hack-a-tack/FPGA_Logic_Analyzer/rev2/pcb/images/rev2_3d_render.png

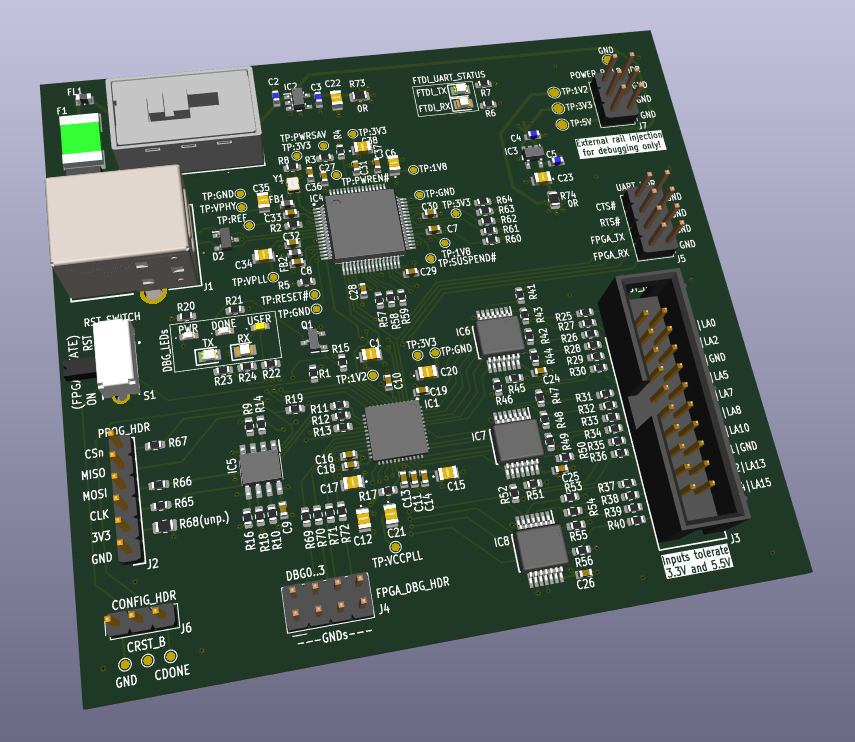
rev2/pcb/images/rev2_3d_render.png
