hack-a-tack/FPGA_Logic_Analyzer/rev2/pcb/kicad/report.txt

Warning: Width correction constrained.  The width correction value must be in the range of [-0.099999 mm; -0.000002 mm] for the current design rules.
