hack-a-tack/FPGA_Logic_Analyzer/rev2/fpga/iCEcube2_rev2_logic_analyzer/iCEcube2_rev2_logic_analyzer_Implmnt/synlog/report/iCEcube2_rev2_logic_analyzer_fpga_mapper_notes.txt

@N: MF248 |Running in 64-bit mode.
@N: MF666 |Clock conversion enabled. (Command "set_option -fix_gated_and_generated_clocks 1" in the project file.)
@N: MT204 |Auto Constrain mode is disabled because clocks are defined in the SDC file
@N: MO225 :"c:\users\jakob\documents\ee-projects\fpga_logic_analyzer\rev2\fpga\rtl\uart_rx.vhd":91:2:91:3|There are no possible illegal states for state machine r_state[0:3] (in view: work.uart_rx(rtl)); safe FSM implementation is not required.
@N: MO225 :"c:\users\jakob\documents\ee-projects\fpga_logic_analyzer\rev2\fpga\rtl\analyzer_fsm.vhd":133:2:133:3|There are no possible illegal states for state machine r_state[0:3] (in view: work.analyzer_fsm(rtl)); safe FSM implementation is not required.
@N: MO231 :"c:\users\jakob\documents\ee-projects\fpga_logic_analyzer\rev2\fpga\rtl\capture_engine.vhd":168:2:168:3|Found counter in view:work.capture_engine(rtl) instance r_post_remaining[13:0] 
@N: MF179 :"c:\users\jakob\documents\ee-projects\fpga_logic_analyzer\rev2\fpga\rtl\capture_engine.vhd":461:10:461:82|Found 16 by 16 bit equality operator ('==') fsm_proc\.un34_i_samp_tick (in view: work.capture_engine(rtl))
@N: MF179 :"c:\users\jakob\documents\ee-projects\fpga_logic_analyzer\rev2\fpga\rtl\capture_engine.vhd":269:5:269:29|Found 14 by 14 bit equality operator ('==') fsm_proc\.un5_r_write_ptr (in view: work.capture_engine(rtl))
@N: BN362 :|Removing sequential instance r_bank_0_0_0_sr_rst_0 (in view: VhdlGenLib.top_RAMN_R_W_6144_8_TFFF_block_ram_ns_sbt(netlist)) because it does not drive other instances.
@N: BN362 :|Removing sequential instance r_bank_1_0_0_sr_rst_0 (in view: VhdlGenLib.top_RAMN_R_W_6144_8_TFFF_block_ram_ns_sbt_0(netlist)) because it does not drive other instances.
@N: MF179 :"c:\users\jakob\documents\ee-projects\fpga_logic_analyzer\rev2\fpga\rtl\send_engine.vhd":221:61:221:87|Found 14 by 14 bit equality operator ('==') fsm_proc\.un5_r_last_addr (in view: work.send_engine(rtl))
@N: BN362 :"c:\users\jakob\documents\ee-projects\fpga_logic_analyzer\rev2\fpga\rtl\send_engine.vhd":164:2:164:3|Removing sequential instance r_sample_count[10] (in view: work.send_engine(rtl)) because it does not drive other instances.
@N: BN362 :"c:\users\jakob\documents\ee-projects\fpga_logic_analyzer\rev2\fpga\rtl\resp_gen.vhd":135:2:135:3|Removing sequential instance seq_proc\.r_queue_3[18] (in view: work.resp_gen(rtl)) because it does not drive other instances.
@N: BN362 :"c:\users\jakob\documents\ee-projects\fpga_logic_analyzer\rev2\fpga\rtl\resp_gen.vhd":135:2:135:3|Removing sequential instance seq_proc\.r_queue_2[18] (in view: work.resp_gen(rtl)) because it does not drive other instances.
@N: BN362 :"c:\users\jakob\documents\ee-projects\fpga_logic_analyzer\rev2\fpga\rtl\resp_gen.vhd":135:2:135:3|Removing sequential instance seq_proc\.r_queue_1[18] (in view: work.resp_gen(rtl)) because it does not drive other instances.
@N: BN362 :"c:\users\jakob\documents\ee-projects\fpga_logic_analyzer\rev2\fpga\rtl\resp_gen.vhd":135:2:135:3|Removing sequential instance seq_proc\.r_queue_0[18] (in view: work.resp_gen(rtl)) because it does not drive other instances.
@N: MO225 :"c:\users\jakob\documents\ee-projects\fpga_logic_analyzer\rev2\fpga\rtl\uart_tx.vhd":107:2:107:3|There are no possible illegal states for state machine r_state[0:3] (in view: work.uart_tx(rtl)); safe FSM implementation is not required.
@N: MF794 |RAM r_bank_0[7:0] required 2 registers during mapping 
@N: MF794 |RAM r_bank_1[7:0] required 2 registers during mapping 
@N: BN362 :|Removing sequential instance r_bank_0_0_0_sr_rst (in view: VhdlGenLib.top_RAMN_R_W_6144_8_TFFF_block_ram_ns_sbt(netlist)) because it does not drive other instances.
@N: BN362 :|Removing sequential instance r_bank_0_0_0_sr_en (in view: VhdlGenLib.top_RAMN_R_W_6144_8_TFFF_block_ram_ns_sbt(netlist)) because it does not drive other instances.
@N: BN362 :|Removing sequential instance r_bank_1_0_0_sr_rst (in view: VhdlGenLib.top_RAMN_R_W_6144_8_TFFF_block_ram_ns_sbt_0(netlist)) because it does not drive other instances.
@N: BN362 :|Removing sequential instance r_bank_1_0_0_sr_en (in view: VhdlGenLib.top_RAMN_R_W_6144_8_TFFF_block_ram_ns_sbt_0(netlist)) because it does not drive other instances.
@N: BN362 :"c:\users\jakob\documents\ee-projects\fpga_logic_analyzer\rev2\fpga\rtl\resp_gen.vhd":135:2:135:3|Removing sequential instance E10.r_active_type[2] (in view: work.top(structure)) because it does not drive other instances.
@N: BN362 :"c:\users\jakob\documents\ee-projects\fpga_logic_analyzer\rev2\fpga\rtl\frame_tx.vhd":121:2:121:3|Removing sequential instance E12.r_frame_type[2] (in view: work.top(structure)) because it does not drive other instances.
@N: BN362 :"c:\users\jakob\documents\ee-projects\fpga_logic_analyzer\rev2\fpga\rtl\trace_buffer.vhd":96:8:96:15|Removing sequential instance E8.r_bank_0_r_bank_0_2_3_OLD[0] (in view: work.top(structure)) because it does not drive other instances.
@N: BN362 :"c:\users\jakob\documents\ee-projects\fpga_logic_analyzer\rev2\fpga\rtl\trace_buffer.vhd":96:8:96:15|Removing sequential instance E8.r_bank_0_r_bank_0_2_3_OLD[1] (in view: work.top(structure)) because it does not drive other instances.
@N: BN362 :"c:\users\jakob\documents\ee-projects\fpga_logic_analyzer\rev2\fpga\rtl\trace_buffer.vhd":96:8:96:15|Removing sequential instance E8.r_bank_0_r_bank_0_2_2_OLD[0] (in view: work.top(structure)) because it does not drive other instances.
@N: BN362 :"c:\users\jakob\documents\ee-projects\fpga_logic_analyzer\rev2\fpga\rtl\trace_buffer.vhd":96:8:96:15|Removing sequential instance E8.r_bank_0_r_bank_0_2_2_OLD[1] (in view: work.top(structure)) because it does not drive other instances.
@N: BN362 :"c:\users\jakob\documents\ee-projects\fpga_logic_analyzer\rev2\fpga\rtl\trace_buffer.vhd":96:8:96:15|Removing sequential instance E8.r_bank_0_r_bank_0_2_1_OLD[0] (in view: work.top(structure)) because it does not drive other instances.
@N: BN362 :"c:\users\jakob\documents\ee-projects\fpga_logic_analyzer\rev2\fpga\rtl\trace_buffer.vhd":96:8:96:15|Removing sequential instance E8.r_bank_0_r_bank_0_2_1_OLD[1] (in view: work.top(structure)) because it does not drive other instances.
@N: BN362 :"c:\users\jakob\documents\ee-projects\fpga_logic_analyzer\rev2\fpga\rtl\trace_buffer.vhd":96:8:96:15|Removing sequential instance E8.r_bank_0_r_bank_0_2_0_OLD[0] (in view: work.top(structure)) because it does not drive other instances.
@N: BN362 :"c:\users\jakob\documents\ee-projects\fpga_logic_analyzer\rev2\fpga\rtl\trace_buffer.vhd":96:8:96:15|Removing sequential instance E8.r_bank_0_r_bank_0_2_0_OLD[1] (in view: work.top(structure)) because it does not drive other instances.
@N: BN362 :"c:\users\jakob\documents\ee-projects\fpga_logic_analyzer\rev2\fpga\rtl\trace_buffer.vhd":96:8:96:15|Removing sequential instance E8.r_bank_0_r_bank_0_1_3_OLD[0] (in view: work.top(structure)) because it does not drive other instances.
@N: BN362 :"c:\users\jakob\documents\ee-projects\fpga_logic_analyzer\rev2\fpga\rtl\trace_buffer.vhd":96:8:96:15|Removing sequential instance E8.r_bank_0_r_bank_0_1_3_OLD[1] (in view: work.top(structure)) because it does not drive other instances.
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
@N: MF794 |RAM r_bank_0[7:0] required 2 registers during mapping 
@N: BN362 :"c:\users\jakob\documents\ee-projects\fpga_logic_analyzer\rev2\fpga\rtl\frame_tx.vhd":121:2:121:3|Removing sequential instance E12.r_frame_len[10] (in view: work.top(structure)) because it does not drive other instances.
@N: BN362 :"c:\users\jakob\documents\ee-projects\fpga_logic_analyzer\rev2\fpga\rtl\frame_tx.vhd":121:2:121:3|Removing sequential instance E12.r_frame_len[9] (in view: work.top(structure)) because it does not drive other instances.
@N: BN362 :"c:\users\jakob\documents\ee-projects\fpga_logic_analyzer\rev2\fpga\rtl\frame_tx.vhd":121:2:121:3|Removing sequential instance E12.r_frame_len[8] (in view: work.top(structure)) because it does not drive other instances.
@N: BN362 :"c:\users\jakob\documents\ee-projects\fpga_logic_analyzer\rev2\fpga\rtl\frame_tx.vhd":121:2:121:3|Removing sequential instance E12.r_frame_len[7] (in view: work.top(structure)) because it does not drive other instances.
@N: BN362 :"c:\users\jakob\documents\ee-projects\fpga_logic_analyzer\rev2\fpga\rtl\frame_tx.vhd":121:2:121:3|Removing sequential instance E12.r_frame_len[6] (in view: work.top(structure)) because it does not drive other instances.
@N: BN362 :"c:\users\jakob\documents\ee-projects\fpga_logic_analyzer\rev2\fpga\rtl\frame_tx.vhd":121:2:121:3|Removing sequential instance E12.r_frame_len[5] (in view: work.top(structure)) because it does not drive other instances.
@N: BN362 :"c:\users\jakob\documents\ee-projects\fpga_logic_analyzer\rev2\fpga\rtl\frame_tx.vhd":121:2:121:3|Removing sequential instance E12.r_frame_len[4] (in view: work.top(structure)) because it does not drive other instances.
@N: BN362 :"c:\users\jakob\documents\ee-projects\fpga_logic_analyzer\rev2\fpga\rtl\send_engine.vhd":164:2:164:3|Removing sequential instance E9.r_payload_len[10] (in view: work.top(structure)) because it does not drive other instances.
@N: BN362 :"c:\users\jakob\documents\ee-projects\fpga_logic_analyzer\rev2\fpga\rtl\send_engine.vhd":164:2:164:3|Removing sequential instance E9.r_payload_len[9] (in view: work.top(structure)) because it does not drive other instances.
@N: BN362 :"c:\users\jakob\documents\ee-projects\fpga_logic_analyzer\rev2\fpga\rtl\send_engine.vhd":164:2:164:3|Removing sequential instance E9.r_payload_len[8] (in view: work.top(structure)) because it does not drive other instances.
@N: BN362 :"c:\users\jakob\documents\ee-projects\fpga_logic_analyzer\rev2\fpga\rtl\send_engine.vhd":164:2:164:3|Removing sequential instance E9.r_payload_len[7] (in view: work.top(structure)) because it does not drive other instances.
@N: BN362 :"c:\users\jakob\documents\ee-projects\fpga_logic_analyzer\rev2\fpga\rtl\send_engine.vhd":164:2:164:3|Removing sequential instance E9.r_payload_len[6] (in view: work.top(structure)) because it does not drive other instances.
@N: BN362 :"c:\users\jakob\documents\ee-projects\fpga_logic_analyzer\rev2\fpga\rtl\send_engine.vhd":164:2:164:3|Removing sequential instance E9.r_payload_len[5] (in view: work.top(structure)) because it does not drive other instances.
@N: BN362 :"c:\users\jakob\documents\ee-projects\fpga_logic_analyzer\rev2\fpga\rtl\send_engine.vhd":164:2:164:3|Removing sequential instance E9.r_payload_len[4] (in view: work.top(structure)) because it does not drive other instances.
@N: FX1017 :|SB_GB inserted on the net E7.un1_r_state_8_0_0.
@N: FX1017 :|SB_GB inserted on the net E12.n_header_index_0_sqmuxa.
@N: FX1017 :|SB_GB inserted on the net N_191_i.
@N: FX1017 :|SB_GB inserted on the net N_352.
@N: BW103 |The default time unit for the Synopsys Constraint File (SDC or FDC) is 1ns.
@N: BW107 |Synopsys Constraint File capacitance units using default value of 1pF 
@N: FX1056 |Writing EDF file: C:\Users\Jakob\Documents\ee-projects\FPGA_logic_analyzer\rev2\fpga\iCEcube2_rev2_logic_analyzer\iCEcube2_rev2_logic_analyzer_Implmnt\iCEcube2_rev2_logic_analyzer.edf
@N: MT615 |Found clock clk52 with period 18.94ns 
@N: MT320 |This timing report is an estimate of place and route data. For final timing results, use the FPGA vendor place and route report.
@N: MT322 |Clock constraints include only register-to-register paths associated with each individual clock.
