hack-a-tack/FPGA_Logic_Analyzer/rev2/fpga/iCEcube2_rev2_logic_analyzer/iCEcube2_rev2_logic_analyzer_Implmnt/synlog/report/iCEcube2_rev2_logic_analyzer_compiler_notes.txt

@N|Running in 64-bit mode
@N|Running in 64-bit mode
@N: CD720 :"C:\lscc\iCEcube2.2020.12\synpbase\lib\vhd2008\std.vhd":146:18:146:21|Setting time resolution to ps
@N:"C:\Users\Jakob\Documents\ee-projects\FPGA_logic_analyzer\rev2\fpga\rtl\top.vhd":90:7:90:9|Top entity is set to top.
@N: CD231 :"C:\lscc\iCEcube2.2020.12\synpbase\lib\vhd2008\std1164.vhd":890:16:890:17|Using onehot encoding for type mvl9plus. For example, enumeration 'U' is mapped to "1000000000".
@N: CD630 :"C:\Users\Jakob\Documents\ee-projects\FPGA_logic_analyzer\rev2\fpga\rtl\top.vhd":90:7:90:9|Synthesizing work.top.structure.
@N: CD630 :"C:\Users\Jakob\Documents\ee-projects\FPGA_logic_analyzer\rev2\fpga\rtl\uart_tx.vhd":57:7:57:13|Synthesizing work.uart_tx.rtl.
@N: CD233 :"C:\Users\Jakob\Documents\ee-projects\FPGA_logic_analyzer\rev2\fpga\rtl\uart_tx.vhd":83:25:83:26|Using sequential encoding for type uart_tx_state_type.
@N: CL189 :"C:\Users\Jakob\Documents\ee-projects\FPGA_logic_analyzer\rev2\fpga\rtl\uart_tx.vhd":107:2:107:3|Register bit r_clks_per_bit(0) is always 0.
@N: CL189 :"C:\Users\Jakob\Documents\ee-projects\FPGA_logic_analyzer\rev2\fpga\rtl\uart_tx.vhd":107:2:107:3|Register bit r_clks_per_bit(1) is always 0.
@N: CD630 :"C:\Users\Jakob\Documents\ee-projects\FPGA_logic_analyzer\rev2\fpga\rtl\frame_tx.vhd":69:7:69:14|Synthesizing work.frame_tx.rtl.
@N: CD231 :"C:\Users\Jakob\Documents\ee-projects\FPGA_logic_analyzer\rev2\fpga\rtl\frame_tx.vhd":104:26:104:27|Using onehot encoding for type frame_tx_state_type. For example, enumeration idle is mapped to "100000".
@N: CD630 :"C:\Users\Jakob\Documents\ee-projects\FPGA_logic_analyzer\rev2\fpga\rtl\tx_mux.vhd":36:7:36:12|Synthesizing work.tx_mux.rtl.
@N: CD630 :"C:\Users\Jakob\Documents\ee-projects\FPGA_logic_analyzer\rev2\fpga\rtl\resp_gen.vhd":78:7:78:14|Synthesizing work.resp_gen.rtl.
@N: CD231 :"C:\Users\Jakob\Documents\ee-projects\FPGA_logic_analyzer\rev2\fpga\rtl\resp_gen.vhd":113:26:113:27|Using onehot encoding for type resp_gen_state_type. For example, enumeration idle is mapped to "10000".
@N: CD630 :"C:\Users\Jakob\Documents\ee-projects\FPGA_logic_analyzer\rev2\fpga\rtl\send_engine.vhd":80:7:80:17|Synthesizing work.send_engine.rtl.
@N: CD231 :"C:\Users\Jakob\Documents\ee-projects\FPGA_logic_analyzer\rev2\fpga\rtl\send_engine.vhd":120:29:120:30|Using onehot encoding for type send_engine_state_type. For example, enumeration idle is mapped to "100000000".
@N: CD630 :"C:\Users\Jakob\Documents\ee-projects\FPGA_logic_analyzer\rev2\fpga\rtl\trace_buffer.vhd":72:7:72:18|Synthesizing work.trace_buffer.rtl.
@N: CL134 :"C:\Users\Jakob\Documents\ee-projects\FPGA_logic_analyzer\rev2\fpga\rtl\trace_buffer.vhd":97:8:97:15|Found RAM r_bank_1, depth=6144, width=8
@N: CL134 :"C:\Users\Jakob\Documents\ee-projects\FPGA_logic_analyzer\rev2\fpga\rtl\trace_buffer.vhd":96:8:96:15|Found RAM r_bank_0, depth=6144, width=8
@N: CD630 :"C:\Users\Jakob\Documents\ee-projects\FPGA_logic_analyzer\rev2\fpga\rtl\capture_engine.vhd":82:7:82:20|Synthesizing work.capture_engine.rtl.
@N: CD231 :"C:\Users\Jakob\Documents\ee-projects\FPGA_logic_analyzer\rev2\fpga\rtl\capture_engine.vhd":120:32:120:33|Using onehot encoding for type capture_engine_state_type. For example, enumeration idle is mapped to "100000".
@N: CL189 :"C:\Users\Jakob\Documents\ee-projects\FPGA_logic_analyzer\rev2\fpga\rtl\capture_engine.vhd":168:2:168:3|Register bit r_pre_samples(0) is always 0.
@N: CL189 :"C:\Users\Jakob\Documents\ee-projects\FPGA_logic_analyzer\rev2\fpga\rtl\capture_engine.vhd":168:2:168:3|Register bit r_pre_samples(1) is always 0.
@N: CL189 :"C:\Users\Jakob\Documents\ee-projects\FPGA_logic_analyzer\rev2\fpga\rtl\capture_engine.vhd":168:2:168:3|Register bit r_pre_samples(2) is always 0.
@N: CL189 :"C:\Users\Jakob\Documents\ee-projects\FPGA_logic_analyzer\rev2\fpga\rtl\capture_engine.vhd":168:2:168:3|Register bit r_pre_samples(3) is always 0.
@N: CL189 :"C:\Users\Jakob\Documents\ee-projects\FPGA_logic_analyzer\rev2\fpga\rtl\capture_engine.vhd":168:2:168:3|Register bit r_pre_samples(4) is always 0.
@N: CL189 :"C:\Users\Jakob\Documents\ee-projects\FPGA_logic_analyzer\rev2\fpga\rtl\capture_engine.vhd":168:2:168:3|Register bit r_pre_samples(5) is always 0.
@N: CL189 :"C:\Users\Jakob\Documents\ee-projects\FPGA_logic_analyzer\rev2\fpga\rtl\capture_engine.vhd":168:2:168:3|Register bit r_pre_samples(6) is always 0.
@N: CL189 :"C:\Users\Jakob\Documents\ee-projects\FPGA_logic_analyzer\rev2\fpga\rtl\capture_engine.vhd":168:2:168:3|Register bit r_pre_samples(7) is always 0.
@N: CL189 :"C:\Users\Jakob\Documents\ee-projects\FPGA_logic_analyzer\rev2\fpga\rtl\capture_engine.vhd":168:2:168:3|Register bit r_pre_samples(8) is always 0.
@N: CD630 :"C:\Users\Jakob\Documents\ee-projects\FPGA_logic_analyzer\rev2\fpga\rtl\analyzer_fsm.vhd":69:7:69:18|Synthesizing work.analyzer_fsm.rtl.
@N: CD233 :"C:\Users\Jakob\Documents\ee-projects\FPGA_logic_analyzer\rev2\fpga\rtl\analyzer_fsm.vhd":109:25:109:26|Using sequential encoding for type runtime_state_type.
@N: CL189 :"C:\Users\Jakob\Documents\ee-projects\FPGA_logic_analyzer\rev2\fpga\rtl\analyzer_fsm.vhd":133:2:133:3|Register bit r_resp_type(2) is always 0.
@N: CL189 :"C:\Users\Jakob\Documents\ee-projects\FPGA_logic_analyzer\rev2\fpga\rtl\analyzer_fsm.vhd":133:2:133:3|Register bit r_resp_type(3) is always 0.
@N: CL189 :"C:\Users\Jakob\Documents\ee-projects\FPGA_logic_analyzer\rev2\fpga\rtl\analyzer_fsm.vhd":133:2:133:3|Register bit r_resp_type(4) is always 0.
@N: CL189 :"C:\Users\Jakob\Documents\ee-projects\FPGA_logic_analyzer\rev2\fpga\rtl\analyzer_fsm.vhd":133:2:133:3|Register bit r_resp_type(5) is always 0.
@N: CL189 :"C:\Users\Jakob\Documents\ee-projects\FPGA_logic_analyzer\rev2\fpga\rtl\analyzer_fsm.vhd":133:2:133:3|Register bit r_resp_type(6) is always 0.
@N: CL189 :"C:\Users\Jakob\Documents\ee-projects\FPGA_logic_analyzer\rev2\fpga\rtl\analyzer_fsm.vhd":133:2:133:3|Register bit r_resp_type(7) is always 0.
@N: CD630 :"C:\Users\Jakob\Documents\ee-projects\FPGA_logic_analyzer\rev2\fpga\rtl\config_regs.vhd":70:7:70:17|Synthesizing work.config_regs.rtl.
@N: CD233 :"C:\Users\Jakob\Documents\ee-projects\FPGA_logic_analyzer\rev2\fpga\rtl\config_regs.vhd":126:22:126:23|Using sequential encoding for type baud_state_type.
@N: CD630 :"C:\Users\Jakob\Documents\ee-projects\FPGA_logic_analyzer\rev2\fpga\rtl\cmd_parser.vhd":53:7:53:16|Synthesizing work.cmd_parser.rtl.
@N: CD233 :"C:\Users\Jakob\Documents\ee-projects\FPGA_logic_analyzer\rev2\fpga\rtl\cmd_parser.vhd":78:23:78:24|Using sequential encoding for type cmd_parser_state.
@N: CL189 :"C:\Users\Jakob\Documents\ee-projects\FPGA_logic_analyzer\rev2\fpga\rtl\cmd_parser.vhd":90:8:90:9|Register bit r_pending_cmd(4) is always 0.
@N: CL189 :"C:\Users\Jakob\Documents\ee-projects\FPGA_logic_analyzer\rev2\fpga\rtl\cmd_parser.vhd":90:8:90:9|Register bit r_pending_cmd(5) is always 0.
@N: CD630 :"C:\Users\Jakob\Documents\ee-projects\FPGA_logic_analyzer\rev2\fpga\rtl\rx_frame_parser.vhd":67:7:67:21|Synthesizing work.rx_frame_parser.rtl.
@N: CD630 :"C:\Users\Jakob\Documents\ee-projects\FPGA_logic_analyzer\rev2\fpga\rtl\uart_rx.vhd":45:7:45:13|Synthesizing work.uart_rx.rtl.
@N: CD233 :"C:\Users\Jakob\Documents\ee-projects\FPGA_logic_analyzer\rev2\fpga\rtl\uart_rx.vhd":65:25:65:26|Using sequential encoding for type uart_rx_state_type.
@N: CD630 :"C:\Users\Jakob\Documents\ee-projects\FPGA_logic_analyzer\rev2\fpga\rtl\clocking.vhd":29:7:29:14|Synthesizing work.clocking.rtl.
@N: CD630 :"C:\Users\Jakob\Documents\ee-projects\FPGA_logic_analyzer\rev2\fpga\rtl\clocking.vhd":39:11:39:18|Synthesizing work.sb_hfosc.syn_black_box.
@N: CL189 :"C:\Users\Jakob\Documents\ee-projects\FPGA_logic_analyzer\rev2\fpga\rtl\uart_rx.vhd":91:2:91:3|Register bit r_clks_per_bit(0) is always 0.
@N: CL189 :"C:\Users\Jakob\Documents\ee-projects\FPGA_logic_analyzer\rev2\fpga\rtl\uart_rx.vhd":91:2:91:3|Register bit r_clks_per_bit(1) is always 0.
@N: CL201 :"C:\Users\Jakob\Documents\ee-projects\FPGA_logic_analyzer\rev2\fpga\rtl\uart_rx.vhd":91:2:91:3|Trying to extract state machine for register r_state.
@N: CL159 :"C:\Users\Jakob\Documents\ee-projects\FPGA_logic_analyzer\rev2\fpga\rtl\rx_frame_parser.vhd":75:2:75:6|Input i_clk is unused.
@N: CL159 :"C:\Users\Jakob\Documents\ee-projects\FPGA_logic_analyzer\rev2\fpga\rtl\rx_frame_parser.vhd":76:2:76:8|Input i_rst_n is unused.
@N: CL189 :"C:\Users\Jakob\Documents\ee-projects\FPGA_logic_analyzer\rev2\fpga\rtl\cmd_parser.vhd":90:8:90:9|Register bit o_cfg_opcode(4) is always 0.
@N: CL189 :"C:\Users\Jakob\Documents\ee-projects\FPGA_logic_analyzer\rev2\fpga\rtl\cmd_parser.vhd":90:8:90:9|Register bit o_cfg_opcode(5) is always 0.
@N: CL201 :"C:\Users\Jakob\Documents\ee-projects\FPGA_logic_analyzer\rev2\fpga\rtl\cmd_parser.vhd":90:8:90:9|Trying to extract state machine for register r_state.
@N: CL201 :"C:\Users\Jakob\Documents\ee-projects\FPGA_logic_analyzer\rev2\fpga\rtl\config_regs.vhd":268:2:268:3|Trying to extract state machine for register r_baud_state.
@N: CL201 :"C:\Users\Jakob\Documents\ee-projects\FPGA_logic_analyzer\rev2\fpga\rtl\analyzer_fsm.vhd":133:2:133:3|Trying to extract state machine for register r_state.
@N: CL201 :"C:\Users\Jakob\Documents\ee-projects\FPGA_logic_analyzer\rev2\fpga\rtl\capture_engine.vhd":168:2:168:3|Trying to extract state machine for register r_state.
@N: CL201 :"C:\Users\Jakob\Documents\ee-projects\FPGA_logic_analyzer\rev2\fpga\rtl\send_engine.vhd":164:2:164:3|Trying to extract state machine for register r_state.
@N: CL201 :"C:\Users\Jakob\Documents\ee-projects\FPGA_logic_analyzer\rev2\fpga\rtl\resp_gen.vhd":135:2:135:3|Trying to extract state machine for register r_state.
@N: CL201 :"C:\Users\Jakob\Documents\ee-projects\FPGA_logic_analyzer\rev2\fpga\rtl\frame_tx.vhd":121:2:121:3|Trying to extract state machine for register r_state.
@N: CL201 :"C:\Users\Jakob\Documents\ee-projects\FPGA_logic_analyzer\rev2\fpga\rtl\uart_tx.vhd":107:2:107:3|Trying to extract state machine for register r_state.
@N|Running in 64-bit mode
@N: NF107 :"C:\Users\Jakob\Documents\ee-projects\FPGA_logic_analyzer\rev2\fpga\rtl\top.vhd":90:7:90:9|Selected library: work cell: top view structure as top level
@N: NF107 :"C:\Users\Jakob\Documents\ee-projects\FPGA_logic_analyzer\rev2\fpga\rtl\top.vhd":90:7:90:9|Selected library: work cell: top view structure as top level
