hack-a-tack/FPGA_Logic_Analyzer/rev2/fpga/iCEcube2_rev2_logic_analyzer/iCEcube2_rev2_logic_analyzer_Implmnt/syntmp/statusReport.html

Project Settings
Project Name | iCEcube2_rev2_logic_analyzer_syn | Implementation Name | iCEcube2_rev2_logic_analyzer_Implmnt
Top Module | [auto] | Pipelining | 1
Retiming | 0 | Resource Sharing | 1
Fanout Guide | 10000 | Disable I/O Insertion | 0
Disable Sequential Optimizations | 0 | Clock Conversion | 1

Run Status
Job Name | Status | | | | CPU Time | Real Time | Memory | Date/Time
(compiler) | Complete | 68 | 26 | 0 | - | 00m:01s | - | 23/08/2026 09:57:09
(premap) | Complete | 6 | 0 | 0 | 0m:00s | 0m:00s | 139MB | 23/08/2026 09:57:12
(fpga_mapper) | Complete | 149 | 159 | 0 | 0m:08s | 0m:09s | 173MB | 23/08/2026 09:57:21
Multi-srs Generator | Complete | | | | 00m:01s | | | 23/08/2026 09:57:11

Area Summary
PADS | 27 | FLOPS | 615
RAMS (v_ram) | 24 | CARRYS | 165
LUTS (total_luts) | 963

Timing Summary
Clock Name | Req Freq | Est Freq | Slack
clk52 | 52.8 MHz | 54.2 MHz | 0.500

Optimizations Summary
Combined Clock Conversion | 2 / 0
