hack-a-tack/FPGA_Logic_Analyzer/rev2/pcb/images/rev2_layout_L4.png

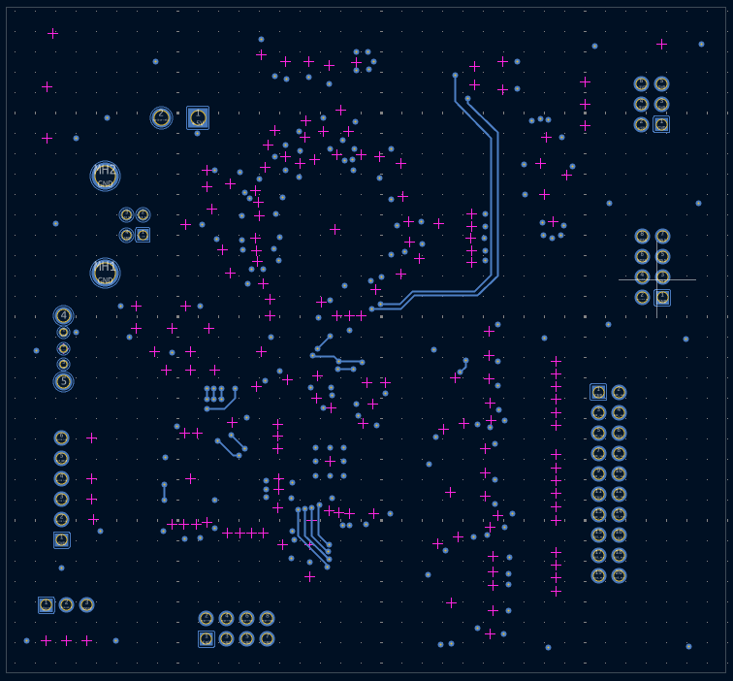
rev2/pcb/images/rev2_layout_L4.png
