hack-a-tack/FPGA_Logic_Analyzer/rev2/pcb/images/rev2_schematic.png

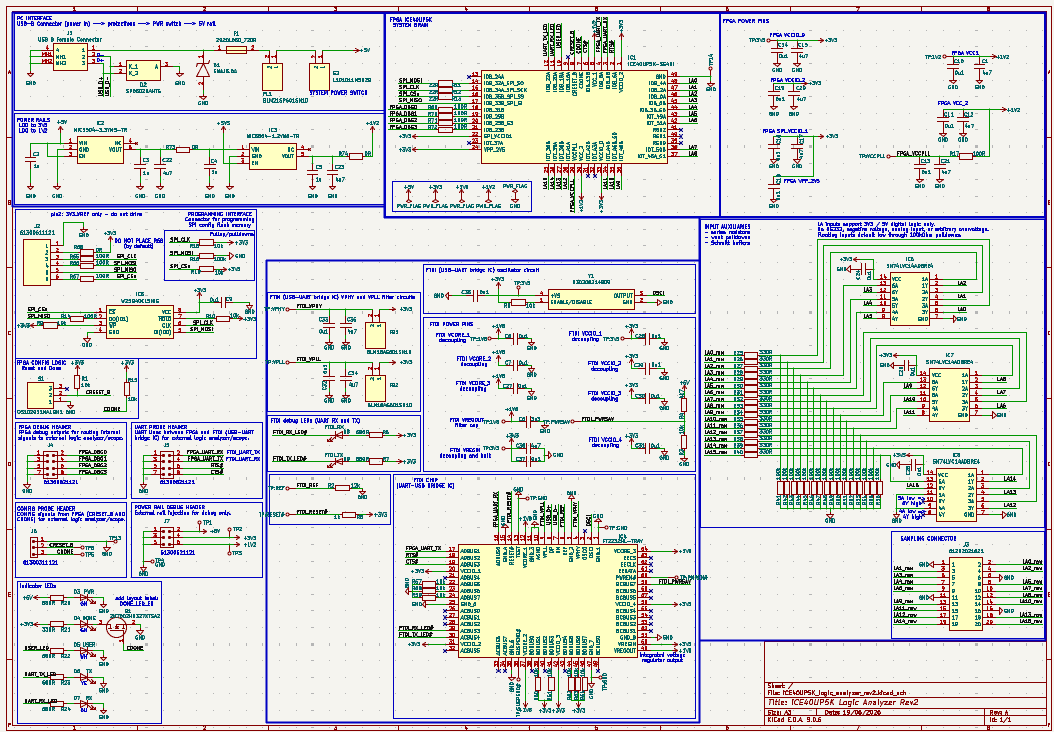
rev2/pcb/images/rev2_schematic.png
