hack-a-tack/FPGA_Logic_Analyzer/rev1/measurements/measurement_notes.md

## Folder contents

raw/ = direct outputs from scripts, scope, external LA, etc.
processed/ = cleaned tables derived from raw data
	performance_summary.csv = final selected metrics for report/GitHub
