hack-a-tack/FPGA_Logic_Analyzer/rev1/measurements/raw/phase7_100k.csv

index | value
0 | 0
1 | 0
2 | 0
3 | 0
4 | 0
5 | 0
6 | 0
7 | 0
8 | 0
9 | 0
10 | 0
11 | 0
12 | 0
13 | 0
14 | 0
15 | 0
16 | 0
17 | 0
18 | 0
19 | 0
20 | 0
21 | 0
22 | 0
23 | 0
24 | 0
25 | 0
26 | 0
27 | 0
28 | 0
29 | 0
30 | 0
31 | 0
32 | 0
33 | 0
34 | 0
35 | 0
36 | 0
37 | 0
38 | 0
39 | 0
40 | 0
41 | 0
42 | 0
43 | 0
44 | 0
45 | 0
46 | 0
47 | 0
48 | 0
49 | 0
50 | 0
51 | 0
52 | 0
53 | 0
54 | 0
55 | 0
56 | 0
57 | 0
58 | 0
59 | 0
60 | 0
61 | 0
62 | 0
63 | 0
64 | 0
65 | 0
66 | 0
67 | 0
68 | 0
69 | 0
70 | 0
71 | 0
72 | 0
73 | 0
74 | 0
75 | 0
76 | 0
77 | 0
78 | 0
79 | 0
80 | 0
81 | 0
82 | 0
83 | 0
84 | 0
85 | 0
86 | 0
87 | 0
88 | 0
89 | 0
90 | 0
91 | 0
92 | 0
93 | 1
94 | 1
95 | 1
96 | 1
97 | 1
98 | 1
99 | 1
100 | 1
101 | 1
102 | 1
103 | 1
104 | 1
105 | 1
106 | 1
107 | 1
108 | 1
109 | 1
110 | 1
111 | 1
112 | 1
113 | 1
114 | 1
115 | 1
116 | 1
117 | 1
118 | 1
119 | 1
120 | 1
121 | 1
122 | 1
123 | 1
124 | 1
125 | 1
126 | 1
127 | 1
128 | 1
129 | 1
130 | 1
131 | 1
132 | 1
133 | 1
134 | 1
135 | 1
136 | 1
137 | 1
138 | 1
139 | 1
140 | 1
141 | 1
142 | 1
143 | 1
144 | 1
145 | 1
146 | 1
147 | 1
148 | 1
149 | 1
150 | 1
151 | 1
152 | 1
153 | 1
154 | 1
155 | 1
156 | 1
157 | 1
158 | 1
159 | 1
160 | 1
161 | 1
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
