hack-a-tack/FPGA_Logic_Analyzer/rev1/measurements/raw/phase7_10M.csv

index | value
0 | 0
1 | 0
2 | 1
3 | 0
4 | 1
5 | 1
6 | 0
7 | 1
8 | 0
9 | 1
10 | 0
11 | 0
12 | 1
13 | 0
14 | 1
15 | 0
16 | 1
17 | 1
18 | 0
19 | 1
20 | 0
21 | 1
22 | 1
23 | 0
24 | 1
25 | 0
26 | 1
27 | 0
28 | 0
29 | 1
30 | 0
31 | 1
32 | 0
33 | 1
34 | 1
35 | 0
36 | 1
37 | 0
38 | 1
39 | 0
40 | 0
41 | 1
42 | 0
43 | 1
44 | 0
45 | 1
46 | 1
47 | 0
48 | 1
49 | 0
50 | 1
51 | 0
52 | 0
53 | 1
54 | 0
55 | 1
56 | 0
57 | 1
58 | 1
59 | 0
60 | 1
61 | 0
62 | 1
63 | 0
64 | 0
65 | 1
66 | 0
67 | 1
68 | 0
69 | 1
70 | 1
71 | 0
72 | 1
73 | 0
74 | 1
75 | 0
76 | 0
77 | 1
78 | 0
79 | 1
80 | 0
81 | 1
82 | 1
83 | 0
84 | 1
85 | 0
86 | 1
87 | 0
88 | 0
89 | 1
90 | 0
91 | 1
92 | 0
93 | 1
94 | 1
95 | 0
96 | 1
97 | 0
98 | 1
99 | 0
100 | 0
101 | 1
102 | 0
103 | 1
104 | 0
105 | 1
106 | 1
107 | 0
108 | 1
109 | 0
110 | 1
111 | 0
112 | 0
113 | 1
114 | 0
115 | 1
116 | 0
117 | 1
118 | 1
119 | 0
120 | 1
121 | 0
122 | 1
123 | 1
124 | 0
125 | 1
126 | 0
127 | 1
128 | 0
129 | 0
130 | 1
131 | 0
132 | 1
133 | 0
134 | 1
135 | 1
136 | 0
137 | 1
138 | 0
139 | 1
140 | 0
141 | 0
142 | 1
143 | 0
144 | 1
145 | 0
146 | 1
147 | 1
148 | 0
149 | 1
150 | 0
151 | 1
152 | 0
153 | 0
154 | 1
155 | 0
156 | 1
157 | 0
158 | 1
159 | 1
160 | 0
161 | 1
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
