hack-a-tack/FPGA_Logic_Analyzer/rev1/measurements/raw/phase7_1M.csv

index | value
0 | 0
1 | 1
2 | 1
3 | 1
4 | 1
5 | 1
6 | 1
7 | 1
8 | 1
9 | 1
10 | 1
11 | 1
12 | 0
13 | 0
14 | 0
15 | 0
16 | 0
17 | 0
18 | 0
19 | 0
20 | 0
21 | 0
22 | 0
23 | 0
24 | 1
25 | 1
26 | 1
27 | 1
28 | 1
29 | 1
30 | 1
31 | 1
32 | 1
33 | 1
34 | 1
35 | 1
36 | 0
37 | 0
38 | 0
39 | 0
40 | 0
41 | 0
42 | 0
43 | 0
44 | 0
45 | 0
46 | 0
47 | 0
48 | 1
49 | 1
50 | 1
51 | 1
52 | 1
53 | 1
54 | 1
55 | 1
56 | 1
57 | 1
58 | 1
59 | 1
60 | 0
61 | 0
62 | 0
63 | 0
64 | 0
65 | 0
66 | 0
67 | 0
68 | 0
69 | 0
70 | 0
71 | 0
72 | 1
73 | 1
74 | 1
75 | 1
76 | 1
77 | 1
78 | 1
79 | 1
80 | 1
81 | 1
82 | 1
83 | 1
84 | 0
85 | 0
86 | 0
87 | 0
88 | 0
89 | 0
90 | 0
91 | 0
92 | 0
93 | 0
94 | 0
95 | 0
96 | 1
97 | 1
98 | 1
99 | 1
100 | 1
101 | 1
102 | 1
103 | 1
104 | 1
105 | 1
106 | 1
107 | 1
108 | 0
109 | 0
110 | 0
111 | 0
112 | 0
113 | 0
114 | 0
115 | 0
116 | 0
117 | 0
118 | 0
119 | 0
120 | 1
121 | 1
122 | 1
123 | 1
124 | 1
125 | 1
126 | 1
127 | 1
128 | 1
129 | 1
130 | 1
131 | 1
132 | 0
133 | 0
134 | 0
135 | 0
136 | 0
137 | 0
138 | 0
139 | 0
140 | 0
141 | 0
142 | 0
143 | 0
144 | 1
145 | 1
146 | 1
147 | 1
148 | 1
149 | 1
150 | 1
151 | 1
152 | 1
153 | 1
154 | 1
155 | 1
156 | 0
157 | 0
158 | 0
159 | 0
160 | 0
161 | 0
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
