hack-a-tack/FPGA_Logic_Analyzer/rev1/measurements/raw/phase7_5M.csv

index | value
0 | 0
1 | 0
2 | 1
3 | 1
4 | 1
5 | 0
6 | 0
7 | 1
8 | 1
9 | 1
10 | 0
11 | 0
12 | 1
13 | 1
14 | 0
15 | 0
16 | 0
17 | 1
18 | 1
19 | 0
20 | 0
21 | 0
22 | 1
23 | 1
24 | 0
25 | 0
26 | 1
27 | 1
28 | 1
29 | 0
30 | 0
31 | 1
32 | 1
33 | 1
34 | 0
35 | 0
36 | 1
37 | 1
38 | 0
39 | 0
40 | 0
41 | 1
42 | 1
43 | 0
44 | 0
45 | 0
46 | 1
47 | 1
48 | 0
49 | 0
50 | 1
51 | 1
52 | 1
53 | 0
54 | 0
55 | 1
56 | 1
57 | 1
58 | 0
59 | 0
60 | 1
61 | 1
62 | 1
63 | 0
64 | 0
65 | 1
66 | 1
67 | 0
68 | 0
69 | 0
70 | 1
71 | 1
72 | 0
73 | 0
74 | 0
75 | 1
76 | 1
77 | 0
78 | 0
79 | 1
80 | 1
81 | 1
82 | 0
83 | 0
84 | 1
85 | 1
86 | 1
87 | 0
88 | 0
89 | 1
90 | 1
91 | 0
92 | 0
93 | 0
94 | 1
95 | 1
96 | 0
97 | 0
98 | 0
99 | 1
100 | 1
101 | 0
102 | 0
103 | 1
104 | 1
105 | 1
106 | 0
107 | 0
108 | 1
109 | 1
110 | 1
111 | 0
112 | 0
113 | 1
114 | 1
115 | 0
116 | 0
117 | 0
118 | 1
119 | 1
120 | 0
121 | 0
122 | 0
123 | 1
124 | 1
125 | 0
126 | 0
127 | 0
128 | 1
129 | 1
130 | 0
131 | 0
132 | 1
133 | 1
134 | 1
135 | 0
136 | 0
137 | 1
138 | 1
139 | 1
140 | 0
141 | 0
142 | 1
143 | 1
144 | 0
145 | 0
146 | 0
147 | 1
148 | 1
149 | 0
150 | 0
151 | 0
152 | 1
153 | 1
154 | 0
155 | 0
156 | 1
157 | 1
158 | 1
159 | 0
160 | 0
161 | 1
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
