hack-a-tack/FPGA_Logic_Analyzer/rev2/pcb/images/rev2_schematic.pdf

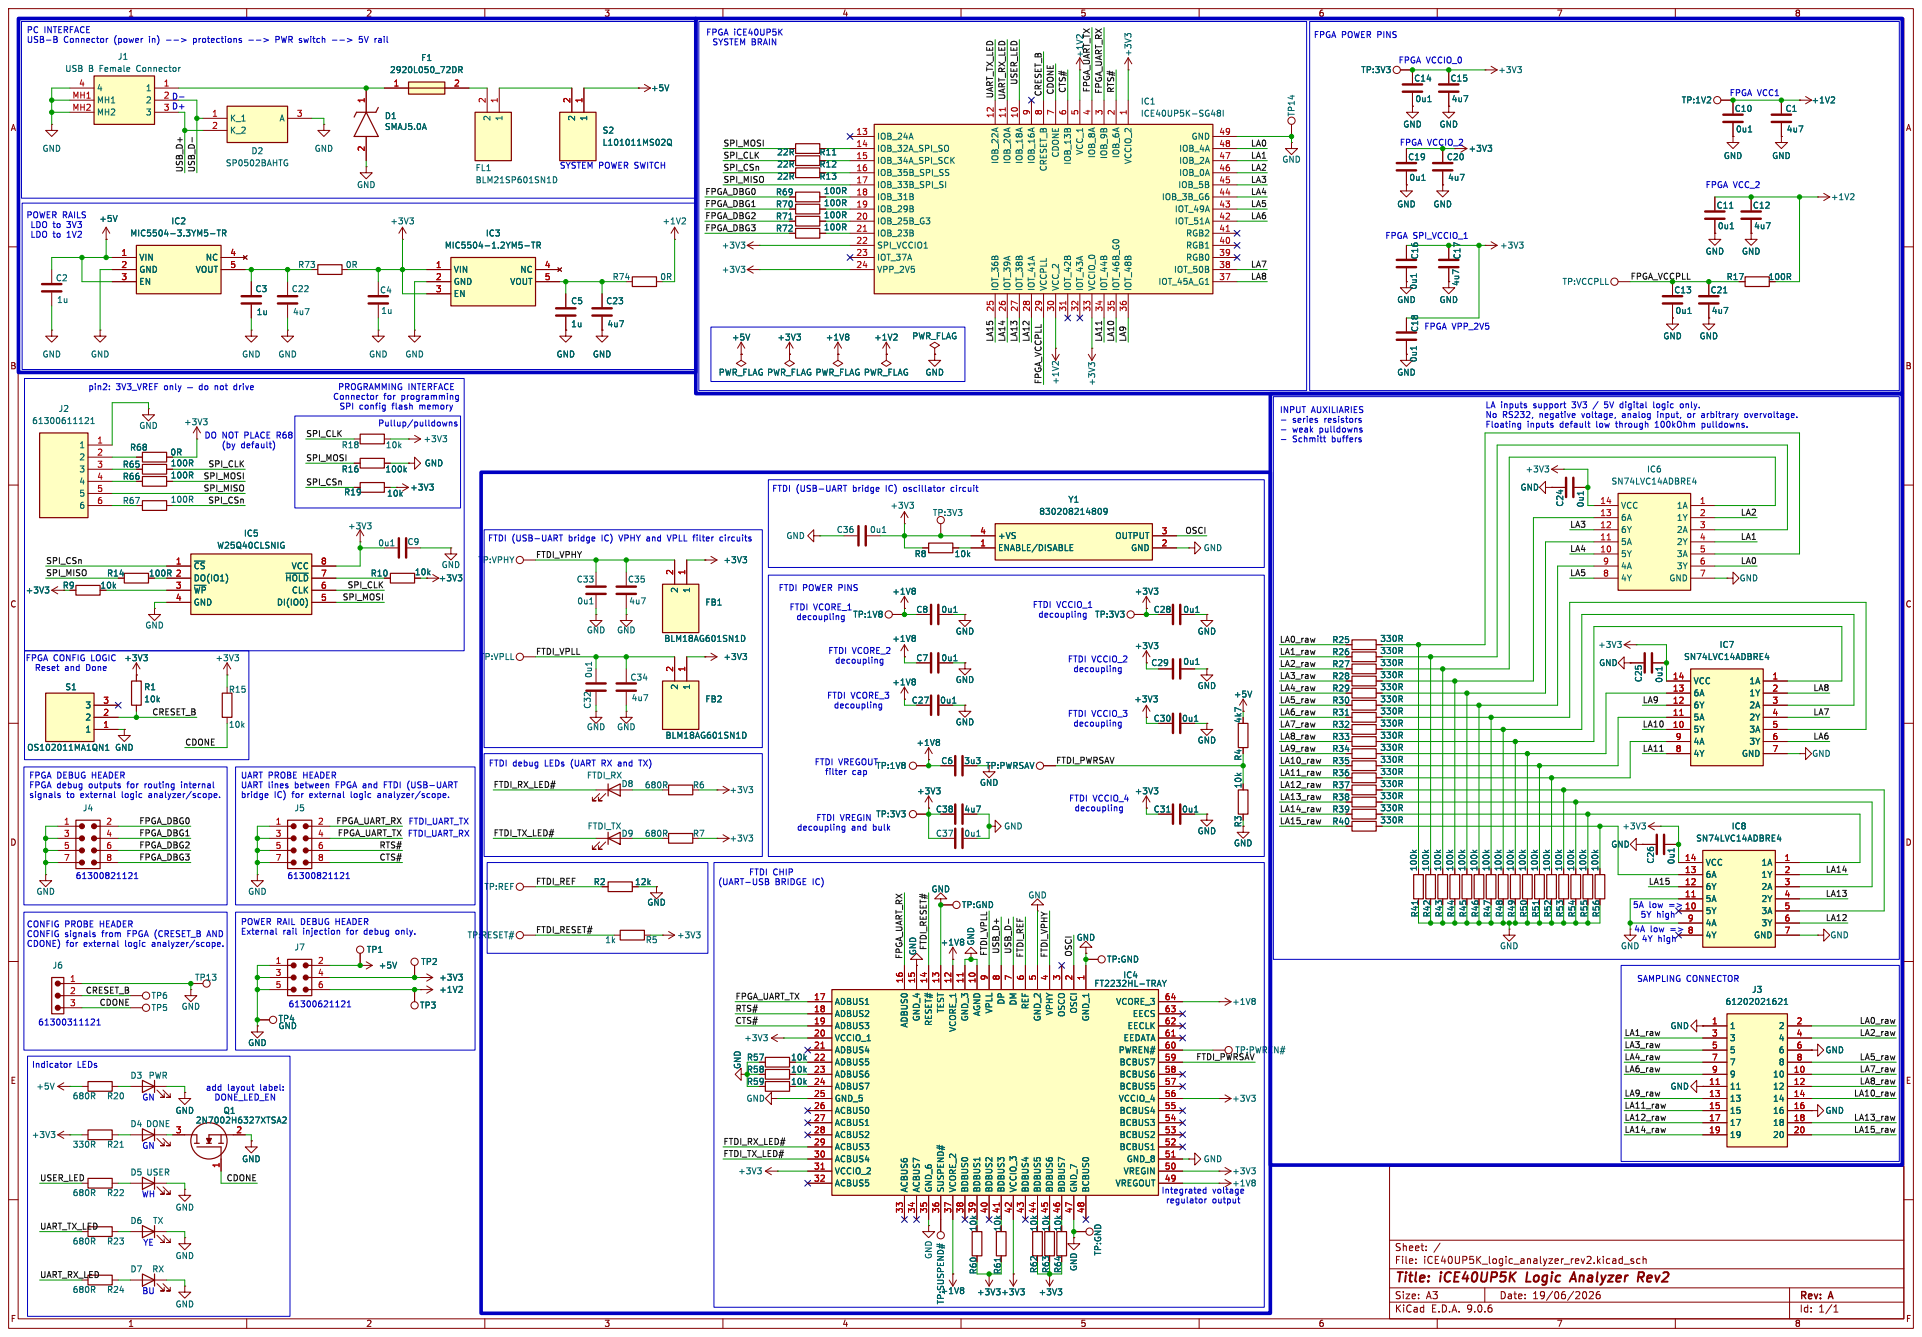
[picture p8: page 1]

- Schmitt buffers FTDI VREGOUT

(UART-USB BRIDGE IC) FPGA CONFIG LOGIC

5Y high FTDI debug LEDs (UART RX and TX) WH

9 AGND 10 GND_3 11 VCORE_1 12 TEST 13 RESET# 14 GND_4 15 ADBUS0 16 VCORE_3 64 ADBUS1 17 EECS 63 ADBUS2 18 EECLK 62 ADBUS3 19 EEDATA 61 VCCIO_1 20 PWREN# 60 ADBUS4 21 BCBUS7 59 ADBUS5 22 BCBUS6 58 ADBUS6 23 BCBUS5 57 ADBUS7 24 VCCIO_4 56 GND_5 25 BCBUS4 55 ACBUS0 26 BCBUS3 54 ACBUS1 27 BCBUS2 53 ACBUS2 28 BCBUS1 52 ACBUS3 29 GND_8 51 ACBUS4 30 VREGIN 50 VCCIO_2 31 VREGOUT 49 ACBUS5 32 BCBUS0 48 GND_7 47 BDBUS7 46 BDBUS6 45 BDBUS5 44 BDBUS4 43 VCCIO_3 42 BDBUS3 41 BDBUS2 40 BDBUS1 39 BDBUS0 38 VCORE_2 37 SUSPEND# 36 GND_6 35 ACBUS7 34 ACBUS6 33 TP:GND GND GNDR57 10k R58 10k TP:PWRSAV

UART lines between FPGA and FTDI (USB-UART

61300821121 POWER RAIL DEBUG HEADER

TP:RESET# TP:REF

CONFIG signals from FPGA (CRESET_B AND

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

Id: 1/1 Title: iCE40UP5K Logic Analyzer Rev2
