hack-a-tack/FPGA_Logic_Analyzer/rev1/pcb/images/schematic.pdf

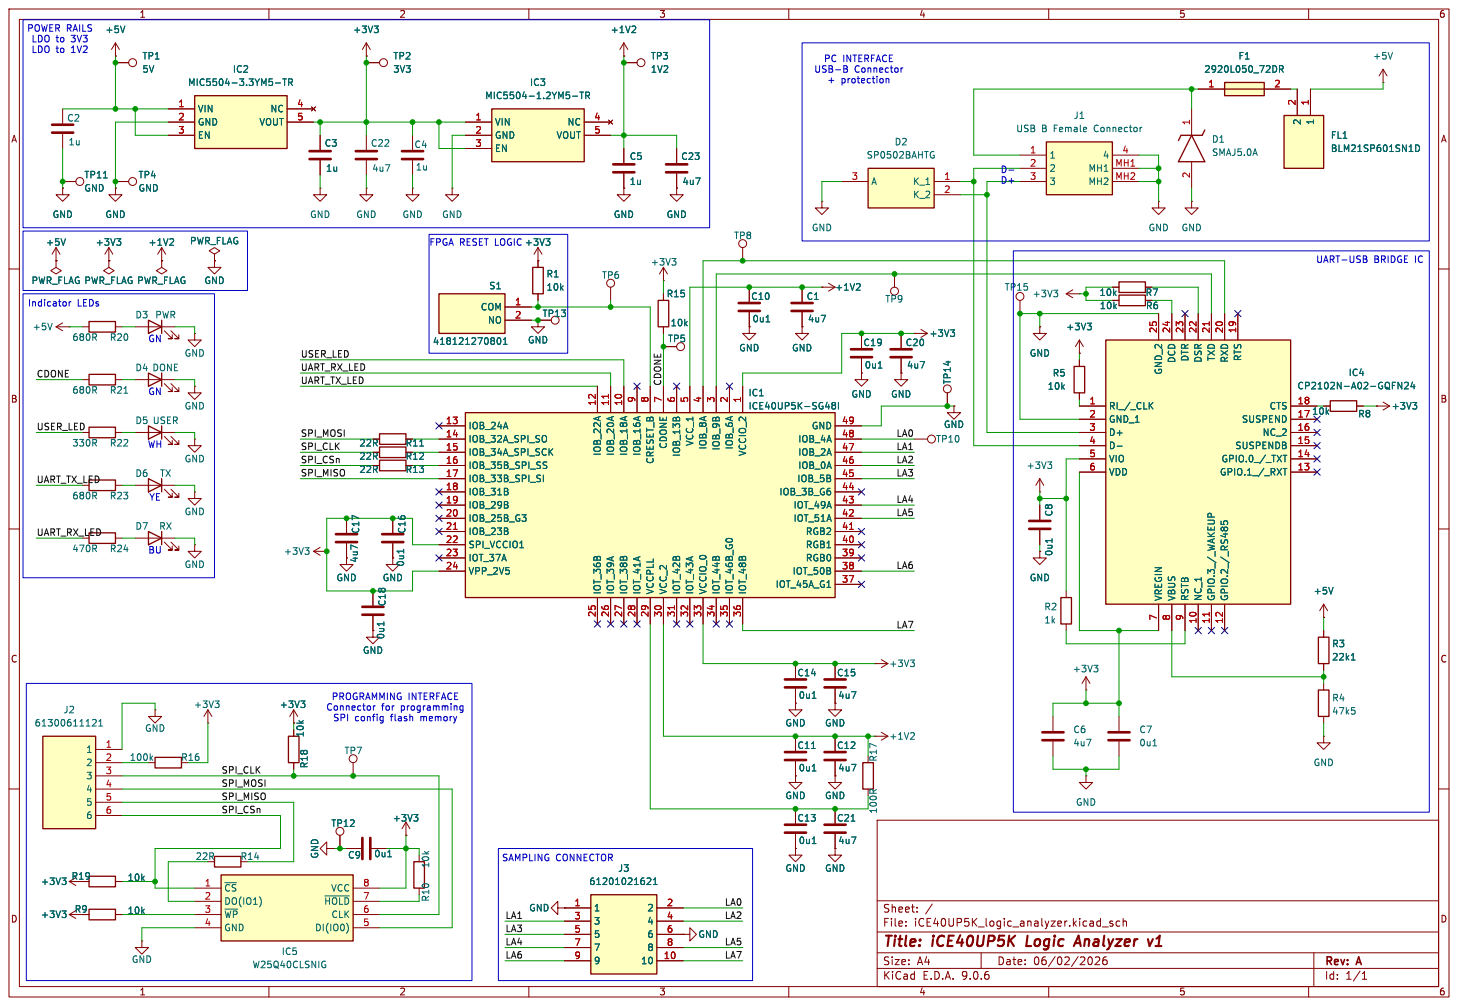
[picture p9: page 1]

J1 USB B Female Connector GND

UART-USB BRIDGE IC

9 DSR 22 NC_1 10 TXD 21 GPIO.3_/_WAKEUP 11 RXD 20 GPIO.2_/_RS485 12 RTS 19 CTS 18 SUSPEND 17 NC_2 16 SUSPENDB 15 GPIO.0_/_TXT 14 GPIO.1_/_RXT 13

Id: 1/1 Title: iCE40UP5K Logic Analyzer v1
