hack-a-tack/FPGA_Logic_Analyzer/rev2/pcb/kicad/iCE40UP5K_logic_analyzer_rev2.kicad_pcb

## KiCad design rev2/pcb/kicad/iCE40UP5K_logic_analyzer_rev2.kicad_pcb (2026-07-11)

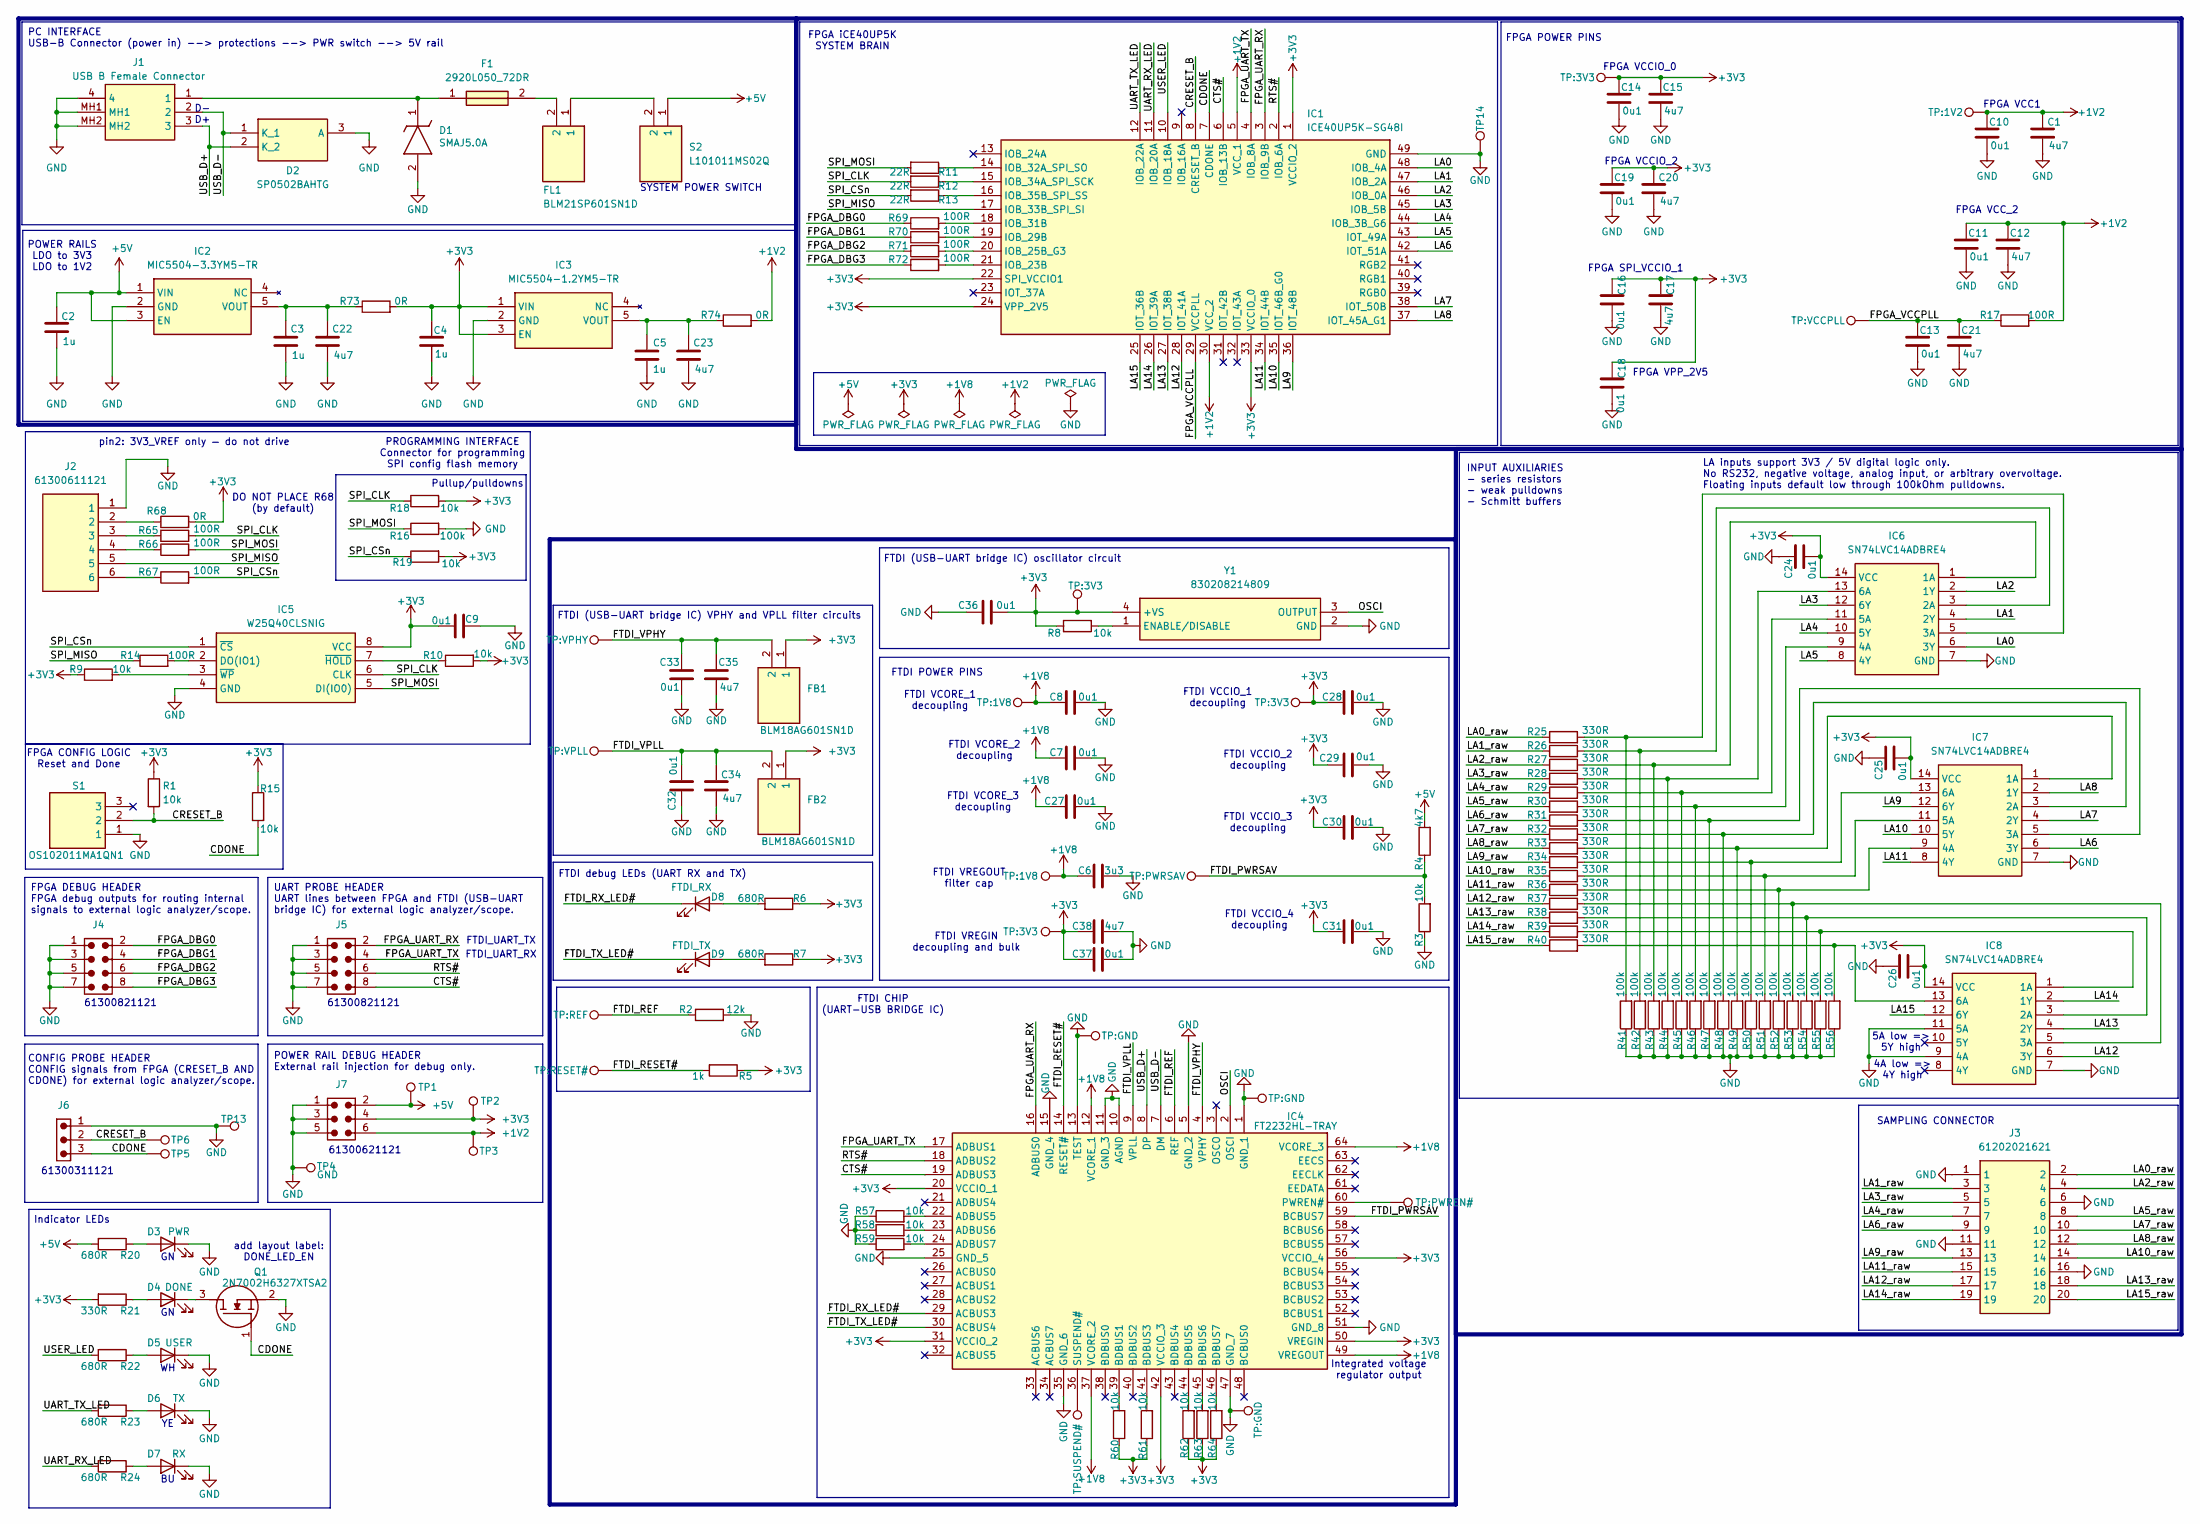
[picture p10: schematic iCE40UP5K_logic_analyzer_rev2.kicad_sch, iCE40UP5K Logic Analyzer Rev2]

Parts:
C1, C12, C15, C17, C20, C21, C22, C23, C34, C35, C38: 4u7; C0805
C2, C3, C4, C5: 1u; INDC1608X90N
C6: 3u3; C0805
C7, C8, C9, C10, C11, C13, C14, C16, C18, C19, C24, C25, C26, C27, C28, C29, C30, C31, C32, C33, C36, C37: 0u1; CAPC1608X95N
D1: SMAJ5.0A; DIOM5127X229N; Mouser Part Number 78-SMAJ5.0A
D2: SP0502BAHTG; SOT95P237X112-3N; Mouser Part Number 576-SP0502BAHTG
D3: PWR; 150060VS75003
D4: DONE; 150060VS75003
D5: USER; 150060WS75000
D6: TX; LEDC2012X70N
D7: RX; LEDC2012X85N
D8: FTDI_RX; LEDC2012X85N
D9: FTDI_TX; LEDC2012X70N
F1: 2920L050_72DR; FUSC7451X125N; Mouser Part Number 576-2920L050/72DR
FB1, FB2: BLM18AG601SN1D; BLM18SP221SN1B; Mouser Part Number 81-BLM11A601S
FL1: BLM21SP601SN1D; BLM21AG102BH1J; Mouser Part Number 81-BLM21SP601SN1D
IC1: ICE40UP5K-SG48I; QFN50P700X700X100-49N-D; Mouser Part Number 842-ICE40UP5K-SG48I
IC2: MIC5504-3.3YM5-TR; SOT95P280X145-5N; Mouser Part Number 998-MIC5504-3.3YM5TR
IC3: MIC5504-1.2YM5-TR; SOT95P280X145-5N; Mouser Part Number 998-MIC5504-1.2YM5TR
IC4: FT2232HL-TRAY; QFP50P1200X1200X160-64N; Mouser Part Number 895-FT2232HL-TRAY
IC5: W25Q40CLSNIG; SOIC127P600X175-8N; Mouser Part Number 454-W25Q40CLSNIG
IC6, IC7, IC8: SN74LVC14ADBRE4; SOP65P780X200-14N; Mouser Part Number 595-SN74LVC14ADBRE4
J1: USB B Female Connector; 61400416121; Mouser Part Number 710-61400416121
J2: 61300611121; HDRV6W64P0X254_1X6_1524X254X869P; Mouser Part Number 710-61300611121
J3: 61202021621; SHDR20W64P254_2X10_3306X910X885P; Mouser Part Number 710-61202021621
J4, J5: 61300821121; J_Wurth_WR-PHD_61300821121
J6: 61300311121; J_Wurth_WR-PHD_61300311121
J7: 61300621121; J_Wurth_WR-PHD_61300621121
Q1: 2N7002H6327XTSA2; SOT95P240X110-3N; Mouser Part Number 726-2N7002H6327XTSA2
R1, R3, R8, R9, R10, R15, R18, R19, R57, R58, R59, R60, R61, R62, R63, R64: 10k; R_0603_1608Metric
R2: 12k; R_0603_1608Metric
R4: 4k7; R_0603_1608Metric
R5: 1k; R_0603_1608Metric
R6, R7, R20, R22, R23, R24: 680R; R_0603_1608Metric
R11, R12, R13: 22R; R_0603_1608Metric
R14, R17, R65, R66, R67, R69, R70, R71, R72: 100R; R_0603_1608Metric
R16, R41, R42, R43, R44, R45, R46, R47, R48, R49, R50, R51, R52, R53, R54, R55, R56: 100k; R_0603_1608Metric
R21, R25, R26, R27, R28, R29, R30, R31, R32, R33, R34, R35, R36, R37, R38, R39, R40: 330R; R_0603_1608Metric
R68, R73, R74: 0R; R_0805_2012Metric
S1: OS102011MA1QN1; Mouser Part Number 611-OS102011MA1QN1
S2: L101011MS02Q; Mouser Part Number 611-L101011MS02Q
TP1: 5V; TestPoint_Pad_D1.5mm
TP2: 3V3; TestPoint_Pad_D1.5mm
TP3: 1V2; TestPoint_Pad_D1.5mm
TP4: GND; TestPoint_Pad_D1.5mm
TP5: CDONE; TestPoint_Pad_D1.0mm
TP6: CRESET_B; TestPoint_Pad_D1.0mm
TP13, TP14: GND; TestPoint_Pad_D1.0mm
TP:1V2: VCC; TestPoint_Pad_D1.0mm
TP:1V8: VREGOUT; TestPoint_Pad_D1.0mm
TP:3V3: FTDI_VCCIO; TestPoint_Pad_D1.0mm
TP:GND: GND; TestPoint_Pad_D1.0mm
TP:PWREN#: PWREN#; TestPoint_Pad_D1.0mm
TP:PWRSAV: PWRSAV#; TestPoint_Pad_D1.0mm
TP:REF: REF; TestPoint_Pad_D1.0mm
TP:RESET#: RESET#; TestPoint_Pad_D1.0mm
TP:SUSPEND#: SUSPEND#; TestPoint_Pad_D1.0mm
TP:VCCPLL: VCC_PLL; TestPoint_Pad_D1.0mm
TP:VPHY: VPHY; TestPoint_Pad_D1.0mm
TP:VPLL: VPLL; TestPoint_Pad_D1.0mm
Y1: 830208214809; Manufacturer_Part_Number 830208214809

Connections:
+1V2: C1.1, C10.1, C11.1, C12.1, IC1.5 (VCC_1), IC1.30 (VCC_2), J7.6, R17.2, R74.2, TP3.1, TP:1V2.1
+1V8: C6.1, C7.1, C8.1, C27.1, IC4.12 (VCORE_1), IC4.37 (VCORE_2), IC4.49 (VREGOUT), IC4.64 (VCORE_3), TP:1V8.1; also elsewhere on the board
+3V3: C4.1, C9.2, C14.1, C15.1, C16.1, C17.1, C18.1, C19.1, C20.1, C24.2, C25.2, C26.2, C28.1, C29.1, C30.1, C31.1, C36.2, C37.1, C38.1, FB1.1, FB2.1, IC1.1 (VCCIO_2), IC1.22 (SPI_VCCIO1), IC1.24 (VPP_2V5), IC1.33 (VCCIO_0), IC3.1 (VIN), IC3.3 (EN), IC4.20 (VCCIO_1), IC4.31 (VCCIO_2), IC4.42 (VCCIO_3), IC4.50 (VREGIN), IC4.56 (VCCIO_4), IC5.8 (VCC), IC6.14 (VCC), IC7.14 (VCC), IC8.14 (VCC), J7.4, R1.1, R5.1, R6.1, R7.1, R8.2, R9.1, R10.2, R15.1, R18.2, R19.2, R21.2, R60.1, R61.1, R62.1, R63.1, R64.1, R68.2, R73.2, TP2.1, TP:3V3.1, Y1.4 (+VS); also elsewhere on the board
+5V: C2.1, IC2.1 (VIN), IC2.3 (EN), J7.2, R4.2, R20.2, S2.1, TP1.1
/CDONE: IC1.7 (CDONE), J6.3, Q1.1 (G), R15.2, TP5.1
/CRESET_B: IC1.8 (CRESET_B), J6.2, R1.2, S1.2, TP6.1
/CTS#: IC1.6 (IOB_13B), IC4.19 (ADBUS3), J5.8
/FPGA_DBG0: J4.2, R69.1
/FPGA_DBG1: J4.4, R70.1
/FPGA_DBG2: J4.6, R71.1
/FPGA_DBG3: J4.8, R72.1
/FPGA_UART_RX: IC1.3 (IOB_9B), IC4.16 (ADBUS0), J5.2
/FPGA_UART_TX: IC1.4 (IOB_8A), IC4.17 (ADBUS1), J5.4
/FPGA_VCCPLL: C13.1, C21.1, IC1.29 (VCCPLL), R17.1, TP:VCCPLL.1
/FTDI_PWRSAV: IC4.59 (BCBUS7), R3.2, R4.1, TP:PWRSAV.1
/FTDI_REF: IC4.6 (REF), R2.1, TP:REF.1
/FTDI_RESET#: IC4.14 (RESET#), R5.2, TP:RESET#.1
/FTDI_RX_LED#: D8.1 (K), IC4.29 (ACBUS3)
/FTDI_TX_LED#: D9.1 (K), IC4.30 (ACBUS4)
/FTDI_VPHY: C33.2, C35.1, FB1.2, IC4.4 (VPHY), TP:VPHY.1
/FTDI_VPLL: C32.2, C34.1, FB2.2, IC4.9 (VPLL), TP:VPLL.1
/LA0: IC1.48 (IOB_4A), IC6.6 (3Y)
/LA0_raw: J3.2, R25.1
/LA1: IC1.47 (IOB_2A), IC6.4 (2Y)
/LA1_raw: J3.3, R26.1
/LA2: IC1.46 (IOB_0A), IC6.2 (1Y)
/LA2_raw: J3.4, R27.1
/LA3: IC1.45 (IOB_5B), IC6.12 (6Y)
/LA3_raw: J3.5, R28.1
/LA4: IC1.44 (IOB_3B_G6), IC6.10 (5Y)
/LA4_raw: J3.7, R29.1
/LA5: IC1.43 (IOT_49A), IC6.8 (4Y)
/LA5_raw: J3.8, R30.1
/LA6: IC1.42 (IOT_51A), IC7.6 (3Y)
/LA6_raw: J3.9, R31.1
/LA7: IC1.38 (IOT_50B), IC7.4 (2Y)
/LA7_raw: J3.10, R32.1
/LA8: IC1.37 (IOT_45A_G1), IC7.2 (1Y)
/LA8_raw: J3.12, R33.1
/LA9: IC1.36 (IOT_48B), IC7.12 (6Y)
/LA9_raw: J3.13, R34.1
/LA10: IC1.35 (IOT_46B_G0), IC7.10 (5Y)
/LA10_raw: J3.14, R35.1
/LA11: IC1.34 (IOT_44B), IC7.8 (4Y)
/LA11_raw: J3.15, R36.1
/LA12: IC1.28 (IOT_41A), IC8.6 (3Y)
/LA12_raw: J3.17, R37.1
/LA13: IC1.27 (IOT_38B), IC8.4 (2Y)
/LA13_raw: J3.18, R38.1
/LA14: IC1.26 (IOT_39A), IC8.2 (1Y)
/LA14_raw: J3.19, R39.1
/LA15: IC1.25 (IOT_36B), IC8.12 (6Y)
/LA15_raw: J3.20, R40.1
/OSCI: IC4.2 (OSCI), Y1.3 (OUTPUT)
/RTS#: IC1.2 (IOB_6A), IC4.18 (ADBUS2), J5.6
/SPI_CLK: IC5.6 (CLK), R12.2, R18.1, R65.2
/SPI_CSn: IC5.1 (~CS), R13.2, R19.1, R67.2
/SPI_MISO: IC1.17 (IOB_33B_SPI_SI), J2.5, R14.1
/SPI_MOSI: IC5.5 (DI(IO0)), R11.2, R16.1, R66.2
/UART_RX_LED: IC1.11 (IOB_20A), R24.2
/UART_TX_LED: IC1.12 (IOB_22A), R23.2
/USB_D+: D2.2 (K_2), IC4.8 (DP), J1.3
/USB_D-: D2.1 (K_1), IC4.7 (DM), J1.2
/USER_LED: IC1.10 (IOB_18A), R22.2
GND: C1.2, C2.2, C3.2, C4.2, C5.2, C6.2, C7.2, C8.2, C9.1, C10.2, C11.2, C12.2, C13.2, C14.2, C15.2, C16.2, C17.2, C18.2, C19.2, C20.2, C21.2, C22.2, C23.2, C24.1, C25.1, C26.1, C27.2, C28.2, C29.2, C30.2, C31.2, C32.1, C33.1, C34.2, C35.2, C36.1, C37.2, C38.2, D1.2 (A), D2.3 (A), D3.1 (K), D5.1 (K), D6.1 (K), D7.1 (K), IC1.49 (GND), IC2.2 (GND), IC3.2 (GND), IC4.1 (GND_1), IC4.5 (GND_2), IC4.10 (AGND), IC4.11 (GND_3), IC4.13 (TEST), IC4.15 (GND_4), IC4.25 (GND_5), IC4.35 (GND_6), IC4.47 (GND_7), IC4.51 (GND_8), IC5.4 (GND), IC6.7 (GND), IC7.7 (GND), IC8.7 (GND), IC8.9 (4A), IC8.11 (5A), J1.4, J1.MH1, J1.MH2, J2.1, J3.1, J3.6, J3.11, J3.16, J4.1, J4.3, J4.5, J4.7, J5.1, J5.3, J5.5, J5.7, J6.1, J7.1, J7.3, J7.5, Q1.2 (S), R2.2, R3.1, R16.2, R41.1, R42.1, R43.1, R44.1, R45.1, R46.1, R47.1, R48.1, R49.1, R50.1, R51.1, R52.1, R53.1, R54.1, R55.1, R56.1, R57.1, R58.1, R59.1, S1.1, TP4.1, TP13.1, TP14.1, TP:GND.1, Y1.2 (GND); also elsewhere on the board
unnamed: D1.1 (K), F1.1, J1.1
unnamed: D3.2 (A), R20.1
unnamed: D4.2 (A), R21.1
unnamed: D4.1 (K), Q1.3 (D)
unnamed: D5.2 (A), R22.1
unnamed: D6.2 (A), R23.1
unnamed: D7.2 (A), R24.1
unnamed: D8.2 (A), R6.2
unnamed: D9.2 (A), R7.2
unnamed: F1.2, FL1.2
unnamed: FL1.1, S2.2
unnamed: IC1.21 (IOB_23B), R72.2
unnamed: IC1.20 (IOB_25B_G3), R71.2
unnamed: IC1.19 (IOB_29B), R70.2
unnamed: IC1.18 (IOB_31B), R69.2
unnamed: IC1.14 (IOB_32A_SPI_SO), R11.1
unnamed: IC1.15 (IOB_34A_SPI_SCK), R12.1
unnamed: IC1.16 (IOB_35B_SPI_SS), R13.1
unnamed: C3.1, C22.1, IC2.5 (VOUT), R73.1
unnamed: C5.1, C23.1, IC3.5 (VOUT), R74.1
unnamed: IC4.22 (ADBUS5), R57.2
unnamed: IC4.23 (ADBUS6), R58.2
unnamed: IC4.24 (ADBUS7), R59.2
unnamed: IC4.39 (BDBUS1), R60.2
unnamed: IC4.41 (BDBUS3), R61.2
unnamed: IC4.44 (BDBUS5), R62.2
unnamed: IC4.45 (BDBUS6), R63.2
unnamed: IC4.46 (BDBUS7), R64.2
unnamed: IC4.60 (PWREN#), TP:PWREN#.1
unnamed: IC4.36 (SUSPEND#), TP:SUSPEND#.1
unnamed: IC5.2 (DO(IO1)), R14.2
unnamed: IC5.7 (~HOLD), R10.1
unnamed: IC5.3 (~WP), R9.2
unnamed: IC6.1 (1A), R27.2, R43.2
unnamed: IC6.3 (2A), R26.2, R42.2
unnamed: IC6.5 (3A), R25.2, R41.2
unnamed: IC6.9 (4A), R30.2, R46.2
unnamed: IC6.11 (5A), R29.2, R45.2
unnamed: IC6.13 (6A), R28.2, R44.2
unnamed: IC7.1 (1A), R33.2, R49.2
unnamed: IC7.3 (2A), R32.2, R48.2
unnamed: IC7.5 (3A), R31.2, R47.2
unnamed: IC7.9 (4A), R36.2, R52.2
unnamed: IC7.11 (5A), R35.2, R51.2
unnamed: IC7.13 (6A), R34.2, R50.2
unnamed: IC8.1 (1A), R39.2, R55.2
unnamed: IC8.3 (2A), R38.2, R54.2
unnamed: IC8.5 (3A), R37.2, R53.2
unnamed: IC8.13 (6A), R40.2, R56.2
unnamed: J2.2, R68.1
unnamed: J2.3, R65.1
unnamed: J2.4, R66.1
unnamed: J2.6, R67.1
unnamed: R8.1, Y1.1 (ENABLE/DISABLE)

Notes on the sheet:
FPGA VCCIO_2
FPGA VCC1
POWER RAILS LDO to 3V3 LDO to 1V2
FTDI VCORE_3 decoupling
FTDI VCCIO_1 decoupling
61300311121
5A low => 5Y high
FTDI VCCIO_2 decoupling
PROGRAMMING INTERFACE Connector for programming SPI config flash memory
FTDI_UART_RX
FTDI VCORE_1 decoupling
SAMPLING CONNECTOR
CONFIG PROBE HEADER CONFIG signals from FPGA (CRESET_B AND CDONE) for external logic analyzer/scope.
LA inputs support 3V3 / 5V digital logic only. No RS232, negative voltage, analog input, or arbitrary overvoltage. Floating inputs default low through 100kOhm pulldowns.
61300821121
add layout label: DONE_LED_EN
FPGA CONFIG LOGIC Reset and Done
UART PROBE HEADER UART lines between FPGA and FTDI (USB-UART bridge IC) for external logic analyzer/scope.
61300621121
POWER RAIL DEBUG HEADER External rail injection for debug only.
D- D+
FPGA SPI_VCCIO_1
FTDI VREGIN decoupling and bulk
FPGA POWER PINS
FTDI VCCIO_4 decoupling
FPGA DEBUG HEADER FPGA debug outputs for routing internal signals to external logic analyzer/scope.
FTDI VREGOUT filter cap
FPGA VCC_2
FTDI (USB-UART bridge IC) VPHY and VPLL filter circuits
Indicator LEDs
FTDI CHIP (UART-USB BRIDGE IC)
FTDI VCCIO_3 decoupling
FTDI (USB-UART bridge IC) oscillator circuit
FTDI debug LEDs (UART RX and TX)
Pullup/pulldowns
FPGA iCE40UP5K SYSTEM BRAIN
Integrated voltage regulator output
FTDI POWER PINS
FPGA VPP_2V5
pin2: 3V3_VREF only — do not drive
FPGA VCCIO_0
PC INTERFACE USB-B Connector (power in) --> protections --> PWR switch --> 5V rail
4A low => 4Y high
DO NOT PLACE R68 (by default)
INPUT AUXILIARIES - series resistors - weak pulldowns - Schmitt buffers
FTDI_UART_TX
FTDI VCORE_2 decoupling
SYSTEM POWER SWITCH

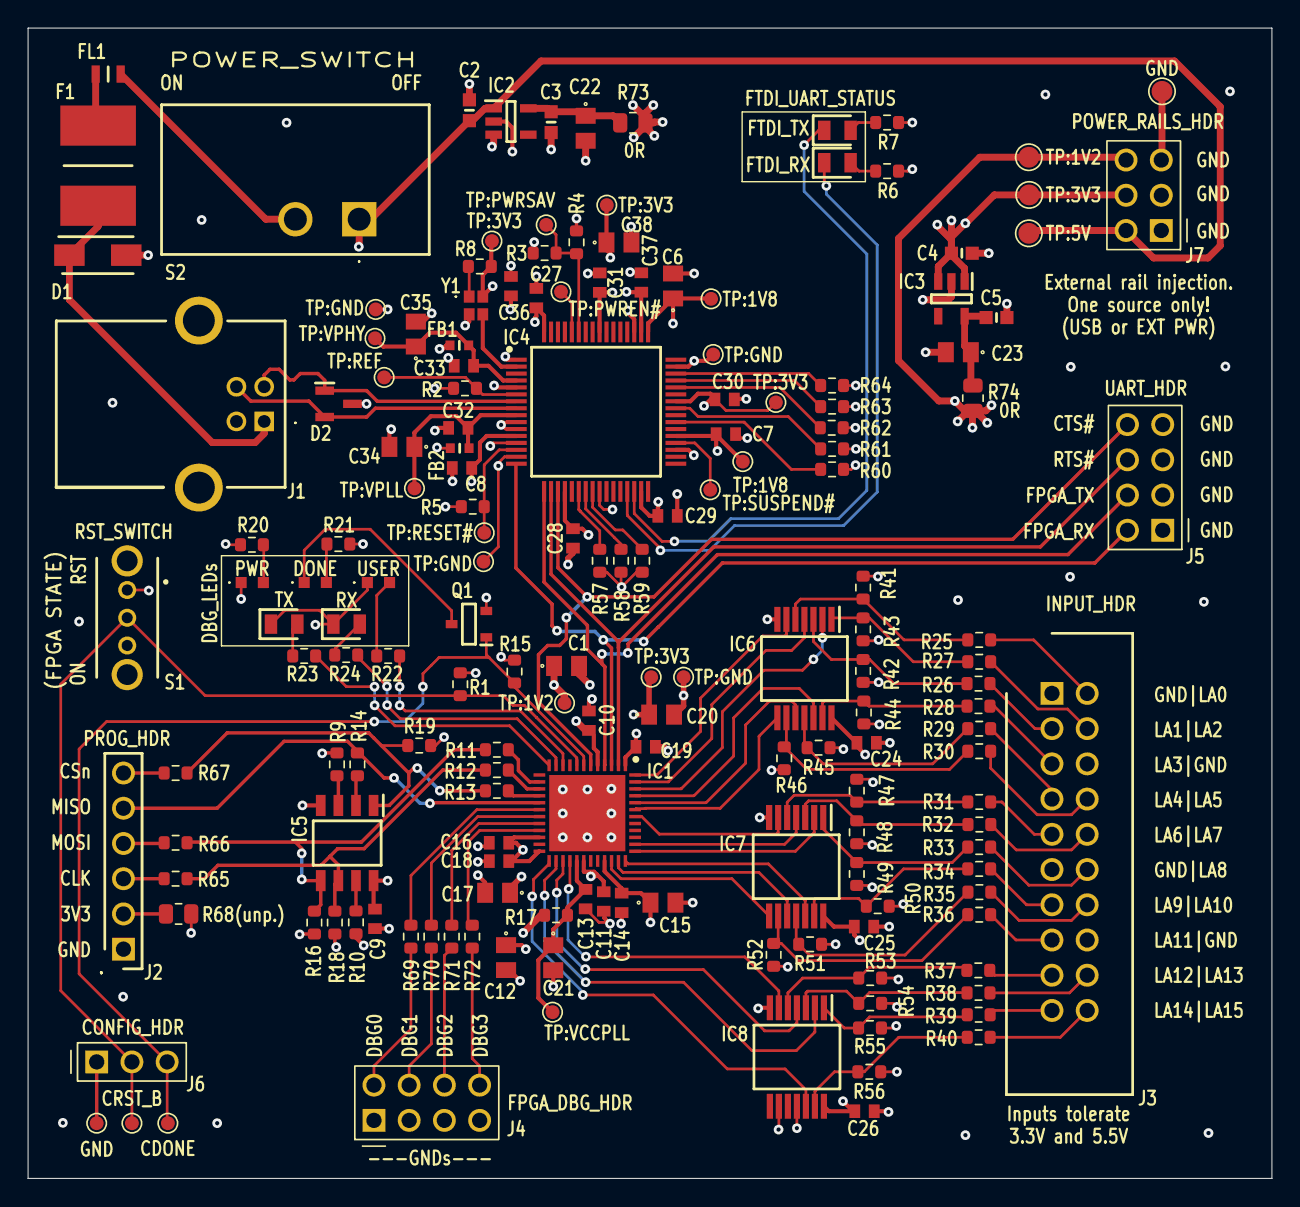
[picture p11: board iCE40UP5K_logic_analyzer_rev2.kicad_pcb from above]

Board: 4 copper layers, 89.7 x 82.9 mm, 170 parts (0 on the bottom side), 119 nets.

Other parts of the board:
TP:1V8#2: VREGOUT; TestPoint_Pad_D1.0mm
TP:3V3#2: FTDI_VCCIO; TestPoint_Pad_D1.0mm
TP:3V3#3: VCCIO; TestPoint_Pad_D1.0mm
TP:3V3#4: VS_OSC; TestPoint_Pad_D1.0mm
TP:GND#2: GND; TestPoint_Pad_D1.0mm
TP:GND#3: TEST; TestPoint_Pad_D1.0mm

Their connections:
+1V8: TP:1V8#2.1; also elsewhere on the board
+3V3: TP:3V3#2.1, TP:3V3#3.1, TP:3V3#4.1; also elsewhere on the board
GND: TP:GND#2.1, TP:GND#3.1; also elsewhere on the board
