hack-a-tack/FPGA_Logic_Analyzer/rev1/pcb/kicad/iCE40UP5K_logic_analyzer.kicad_pcb

## KiCad design rev1/pcb/kicad/iCE40UP5K_logic_analyzer.kicad_pcb (2026-04-13, an earlier design)

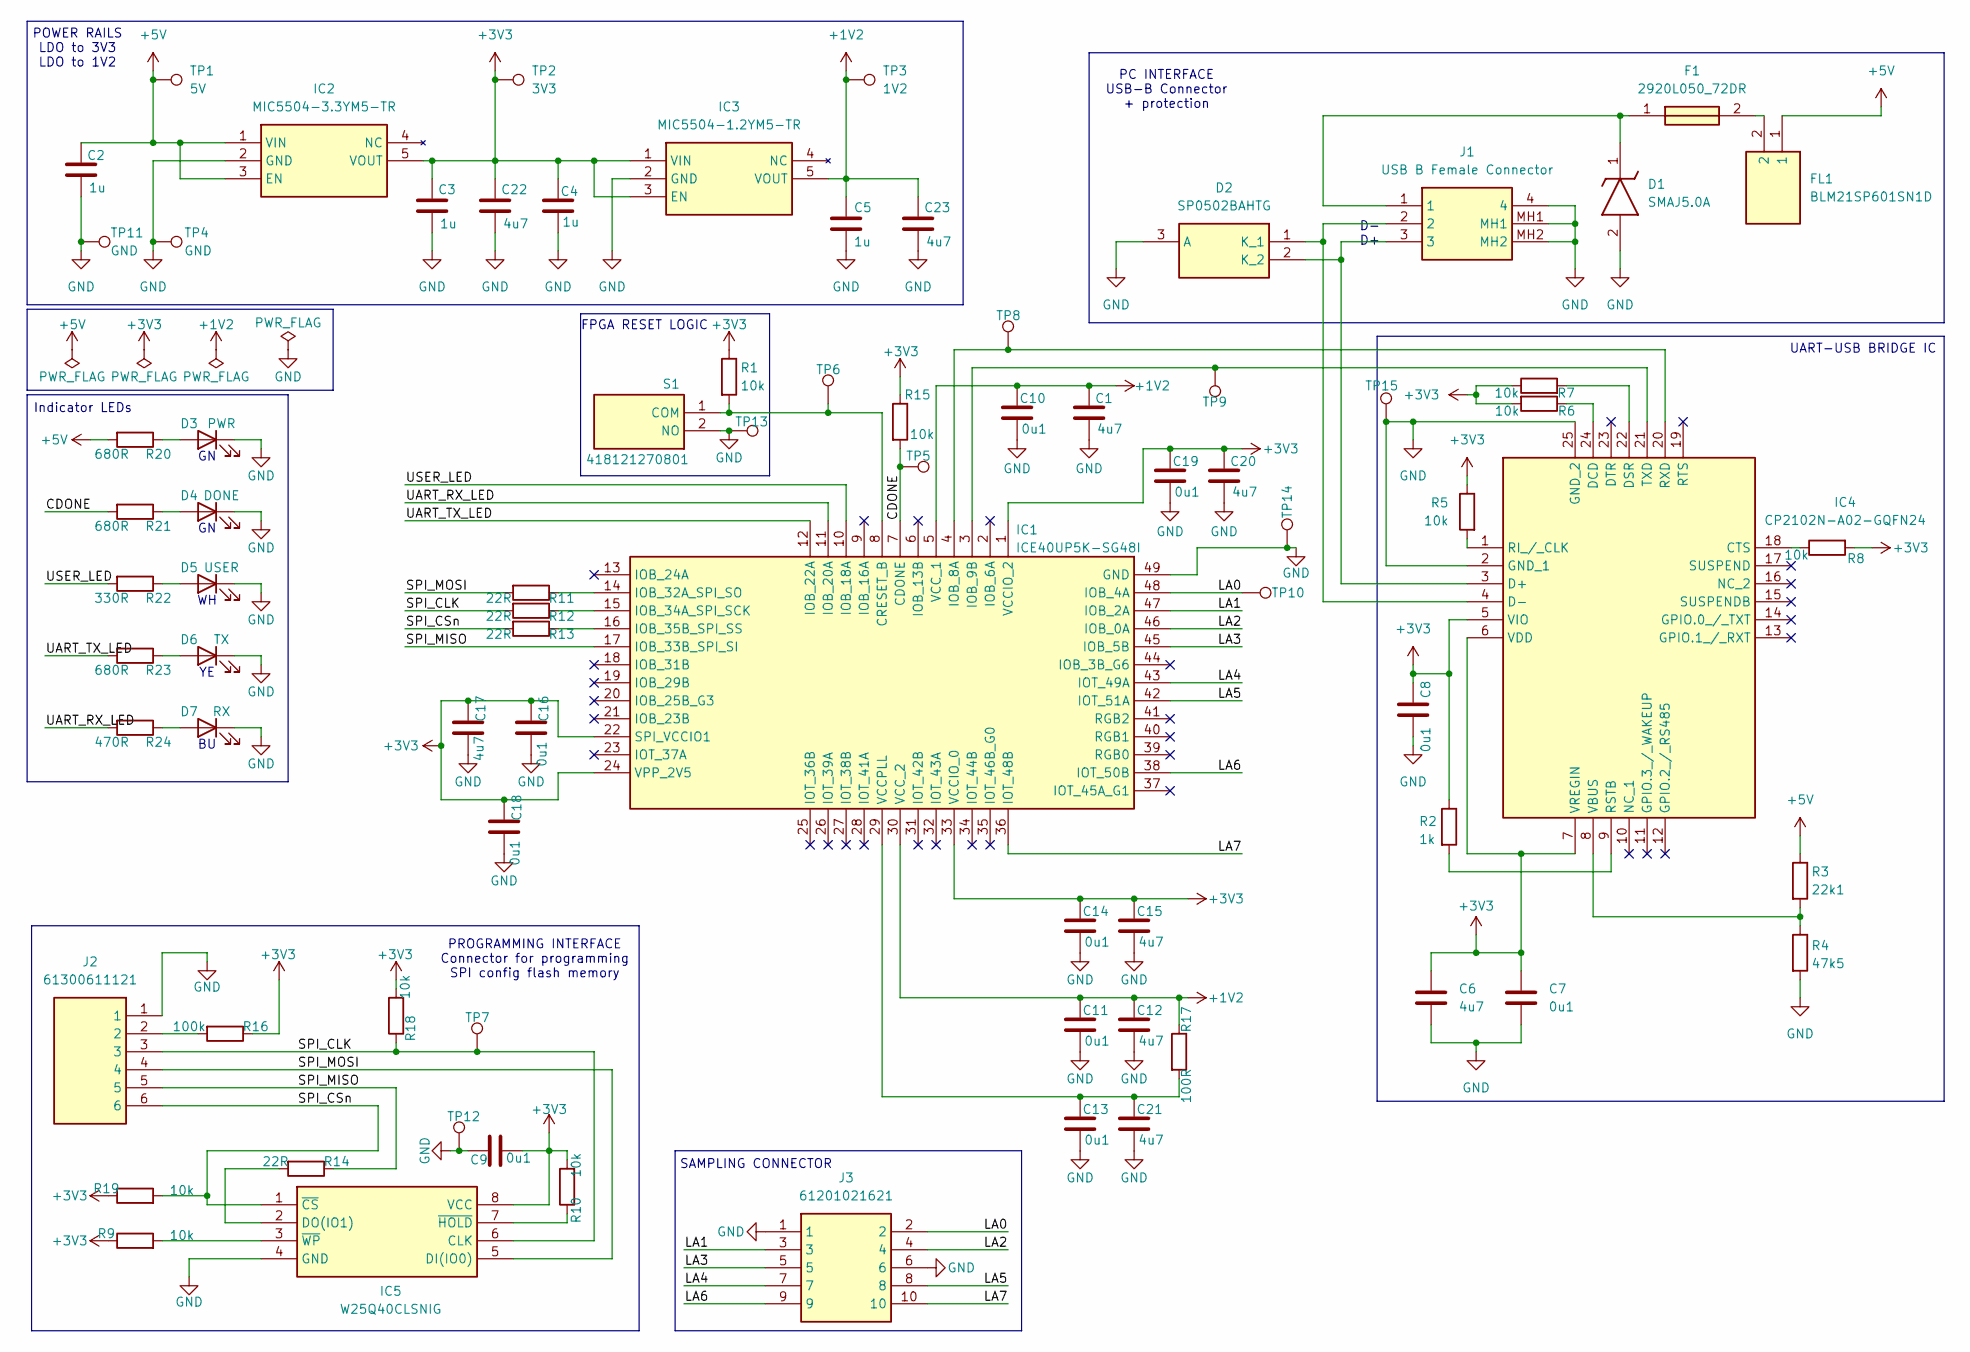
[picture p12: schematic iCE40UP5K_logic_analyzer.kicad_sch, iCE40UP5K Logic Analyzer v1]

Parts:
C1, C6, C12, C15, C17, C20, C21, C22, C23: 4u7; C0805
C2, C3, C4, C5: 1u; INDC1608X90N
C7, C8, C9, C10, C11, C13, C14, C16, C18, C19: 0u1; CAPC1608X95N
D1: SMAJ5.0A; DIOM5127X229N; Mouser Part Number 78-SMAJ5.0A
D2: SP0502BAHTG; SOT95P237X112-3N; Mouser Part Number 576-SP0502BAHTG
D3: PWR; 150060VS75003
D4: DONE; 150060VS75003
D5: USER; 150060WS75000
D6: TX; LEDC2012X70N
D7: RX; LEDC2012X85N
F1: 2920L050_72DR; FUSC7451X125N; Mouser Part Number 576-2920L050/72DR
FL1: BLM21SP601SN1D; BLM21AG102BH1J; Mouser Part Number 81-BLM21SP601SN1D
IC1: ICE40UP5K-SG48I; QFN50P700X700X100-49N-D; Mouser Part Number 842-ICE40UP5K-SG48I
IC2: MIC5504-3.3YM5-TR; SOT95P280X145-5N; Mouser Part Number 998-MIC5504-3.3YM5TR
IC3: MIC5504-1.2YM5-TR; SOT95P280X145-5N; Mouser Part Number 998-MIC5504-1.2YM5TR
IC4: CP2102N-A02-GQFN24; QFN50P400X400X80-25N-D; Mouser Part Number 634-CP2102NA02GQFN24
IC5: W25Q40CLSNIG; SOIC127P600X175-8N; Mouser Part Number 454-W25Q40CLSNIG
J1: USB B Female Connector; 61400416121; Mouser Part Number 710-61400416121
J2: 61300611121; HDRV6W64P0X254_1X6_1524X254X869P; Mouser Part Number 710-61300611121
J3: 61201021621; SHDR10W64P254_2X5_2036X885X925P; Mouser Part Number 710-61201021621
R1, R5, R6, R7, R8, R9, R10, R15, R18, R19: 10k; R_0603_1608Metric
R2: 1k; R_0603_1608Metric
R3: 22k1; R_0603_1608Metric
R4: 47k5; R_0603_1608Metric
R11, R12, R13, R14: 22R; R_0603_1608Metric
R16: 100k; R_0603_1608Metric
R17: 100R; R_0603_1608Metric
R20, R21, R23: 680R; R_0603_1608Metric
R22: 330R; R_0603_1608Metric
R24: 470R; R_0603_1608Metric
S1: 418121270801; Mouser Part Number N/A
TP1: 5V; TestPoint_Pad_D1.5mm
TP2: 3V3; TestPoint_Pad_D1.5mm
TP3: 1V2; TestPoint_Pad_D1.5mm
TP4, TP11: GND; TestPoint_Pad_D1.5mm
TP5: CDONE; TestPoint_Pad_D1.0mm
TP6: CRESET_B; TestPoint_Pad_D1.0mm
TP7: SPI_SCK; TestPoint_Pad_D1.0mm
TP8: FPGA_UART_TX; TestPoint_Pad_D1.0mm
TP9: FPGA_UART_RX; TestPoint_Pad_D1.0mm
TP10: CH0_sampling; TestPoint_Pad_D1.0mm
TP12, TP13, TP14, TP15: GND; TestPoint_Pad_D1.0mm

Connections:
+1V2: C1.1, C5.1, C10.1, C11.1, C12.1, C23.1, IC1.5 (VCC_1), IC1.30 (VCC_2), IC3.5 (VOUT), R17.1, TP3.1
+3V3: C3.1, C4.1, C6.1, C7.1, C8.1, C9.2, C14.1, C15.1, C16.1, C17.1, C18.1, C19.1, C20.1, C22.1, IC1.1 (VCCIO_2), IC1.22 (SPI_VCCIO1), IC1.24 (VPP_2V5), IC1.33 (VCCIO_0), IC2.5 (VOUT), IC3.1 (VIN), IC3.3 (EN), IC4.5 (VIO), IC4.6 (VDD), IC4.7 (VREGIN), IC5.8 (VCC), R1.1, R2.1, R5.1, R6.2, R7.1, R8.2, R9.1, R10.2, R15.1, R16.1, R18.2, R19.1, TP2.1
+5V: C2.1, FL1.1, IC2.1 (VIN), IC2.3 (EN), R3.1, R20.2, TP1.1
/CDONE: IC1.7 (CDONE), R15.2, R21.2, TP5.1
/LA0: IC1.48 (IOB_4A), J3.2, TP10.1
/LA1: IC1.47 (IOB_2A), J3.3
/LA2: IC1.46 (IOB_0A), J3.4
/LA3: IC1.45 (IOB_5B), J3.5
/LA4: IC1.43 (IOT_49A), J3.7
/LA5: IC1.42 (IOT_51A), J3.8
/LA6: IC1.38 (IOT_50B), J3.9
/LA7: IC1.36 (IOT_48B), J3.10
/SPI_CLK: IC5.6 (CLK), J2.3, R12.2, R18.1, TP7.1
/SPI_CSn: IC5.1 (~CS), J2.6, R13.2, R19.2
/SPI_MISO: IC1.17 (IOB_33B_SPI_SI), J2.5, R14.1
/SPI_MOSI: IC5.5 (DI(IO0)), J2.4, R11.2
/UART_RX_LED: IC1.11 (IOB_20A), R24.2
/UART_TX_LED: IC1.12 (IOB_22A), R23.2
/USER_LED: IC1.10 (IOB_18A), R22.2
GND: C1.2, C2.2, C3.2, C4.2, C5.2, C6.2, C7.2, C8.2, C9.1, C10.2, C11.2, C12.2, C13.2, C14.2, C15.2, C16.2, C17.2, C18.2, C19.2, C20.2, C21.2, C22.2, C23.2, D1.2 (A), D2.3 (A), D3.1 (K), D4.1 (K), D5.1 (K), D6.1 (K), D7.1 (K), IC1.49 (GND), IC2.2 (GND), IC3.2 (GND), IC4.2 (GND_1), IC4.25 (GND_2), IC5.4 (GND), J1.4, J1.MH1, J1.MH2, J2.1, J3.1, J3.6, R4.2, S1.2 (NO), TP4.1, TP11.1, TP12.1, TP13.1, TP14.1, TP15.1
unnamed: D1.1 (K), F1.1, J1.1
unnamed: D2.1 (K_1), IC4.4 (D-), J1.2
unnamed: D2.2 (K_2), IC4.3 (D+), J1.3
unnamed: D3.2 (A), R20.1
unnamed: D4.2 (A), R21.1
unnamed: D5.2 (A), R22.1
unnamed: D6.2 (A), R23.1
unnamed: D7.2 (A), R24.1
unnamed: F1.2, FL1.2
unnamed: IC1.8 (CRESET_B), R1.2, S1.1 (COM), TP6.1
unnamed: IC1.4 (IOB_8A), IC4.20 (RXD), TP8.1
unnamed: IC1.3 (IOB_9B), IC4.21 (TXD), TP9.1
unnamed: IC1.14 (IOB_32A_SPI_SO), R11.1
unnamed: IC1.15 (IOB_34A_SPI_SCK), R12.1
unnamed: IC1.16 (IOB_35B_SPI_SS), R13.1
unnamed: C13.1, C21.1, IC1.29 (VCCPLL), R17.2
unnamed: IC4.18 (CTS), R8.1
unnamed: IC4.24 (DCD), R6.1
unnamed: IC4.22 (DSR), R7.2
unnamed: IC4.1 (RI_/_CLK), R5.2
unnamed: IC4.9 (RSTB), R2.2
unnamed: IC4.8 (VBUS), R3.2, R4.1
unnamed: IC5.2 (DO(IO1)), R14.2
unnamed: IC5.7 (~HOLD), R10.1
unnamed: IC5.3 (~WP), R9.2
unnamed: J2.2, R16.2

Notes on the sheet:
POWER RAILS LDO to 3V3 LDO to 1V2
PROGRAMMING INTERFACE Connector for programming SPI config flash memory
SAMPLING CONNECTOR
FPGA RESET LOGIC
D- D+
Indicator LEDs
UART-USB BRIDGE IC
PC INTERFACE USB-B Connector + protection

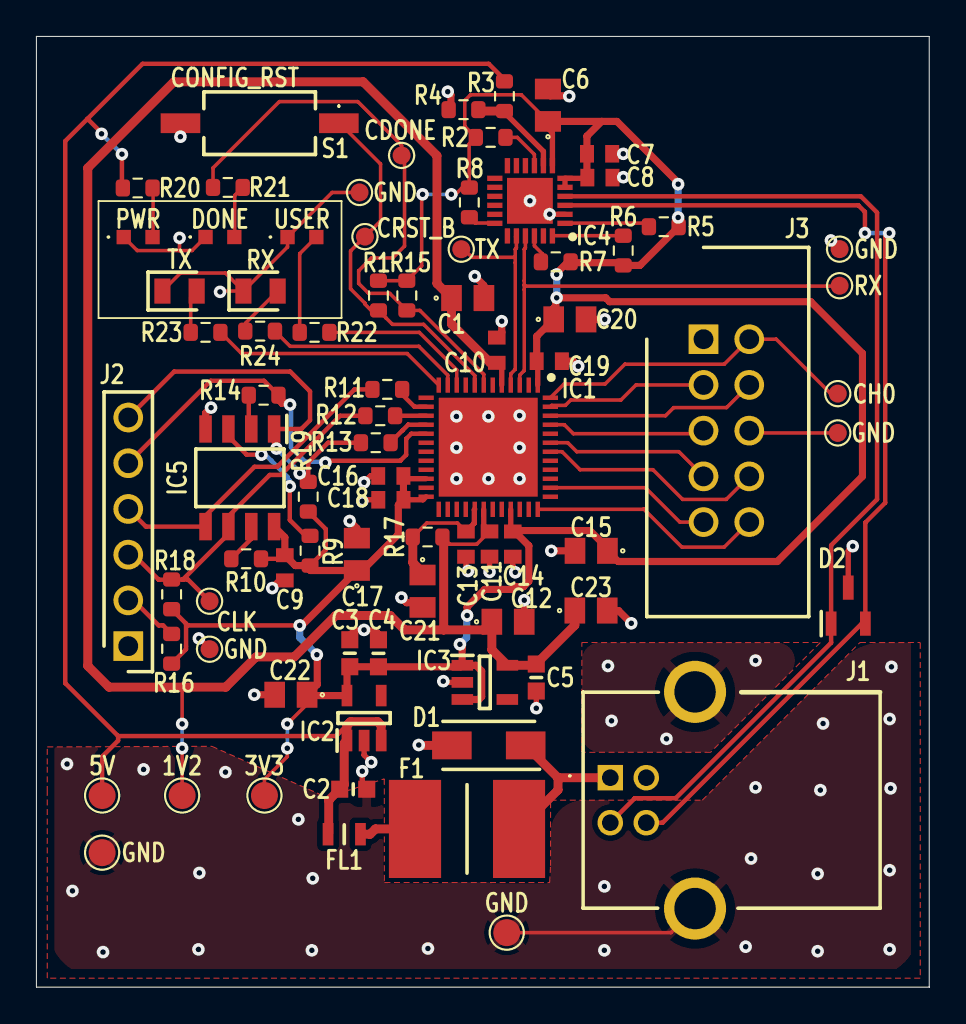
[picture p13: board iCE40UP5K_logic_analyzer.kicad_pcb from above]

Board: 2 copper layers, 49.6 x 52.8 mm, 80 parts (0 on the bottom side), 46 nets.
