hack-a-tack/FPGA_Logic_Analyzer/rev2/fpga/rtl/send_engine.vhd

-- ========================================
-- MODULE: send_engine.vhd
-- FUNCTION: streams captured data from BRAM to host via UART
-- AUTHOR: Jakob Kieszek Ottesen
-- DATE: 2026-04-16 (YYYY-MM-DD)
-- MODIFIED: 2026-05-14 (reset active low)
-- LAST MODIFIED: 2026-05-15
-- MODIFIED: 2026-08-05 (rev2)
-- MODIFIED: 2026-08-12 (rev2) (packet framing: send_engine now supplies payload only via frame_tx; framing/CRC/SEQ moved to frame_tx.vhd)
-- MODIFIED: 2026-08-21 (rev2) (r_sample_index replaced with a down-counter r_samples_remaining, and r_last_addr latched once per send instead of recomputing r_sample_count-1 every cycle; both the SEND_LOW_BYTE/SEND_HIGH_BYTE termination test and the circular-buffer wraparound compare were live subtractions on the hot per-byte path, and owned the worst P&R critical path once capture_engine's and frame_tx's were fixed)
-- MODIFIED: 2026-08-21 (rev2) (added WAIT_RAM_2 -- trace_buffer's RAM read is now 2 clocks, not 1, after registering its output past rd_mux_proc to break an unregistered combinational chain that ran through send_engine/tx_mux into frame_tx's CRC register)
--
-- INPUTS					DATA		FROM MODULE
-- i_clk					1 bit		<- clocking
-- i_rst_n					1 bit		<- top
-- i_send_start_pulse		1 bit		<- analyzer_fsm
-- i_capture_sample_rate_sel	2 bits	<- capture_engine
-- i_capture_trigger_mode		2 bits	<- capture_engine
-- i_capture_trigger_index		16 bits	<- capture_engine
-- i_capture_start_addr 	14 bits		<- capture_engine
-- i_capture_sample_count	14 bits		<- capture_engine
-- i_capture_width_sel		1 bit		<- capture_engine
-- i_ram_rd_data			16 bits		<- trace_buffer
-- i_send_grant				1 bit		<- frame_tx
-- i_frame_done_pulse		1 bit		<- frame_tx
-- i_pl_ready				1 bit		<- tx_mux
--
-- OUTPUTS					DATA		TO MODULE
-- o_ram_rd_addr			14 bits		-> trace_buffer
-- o_send_frame_req			1 bit		-> frame_tx
-- o_send_frame_len			16 bits		-> frame_tx
-- o_pl_byte				8 bits		-> tx_mux
-- o_pl_valid				1 bit		-> tx_mux
-- o_send_done_pulse		1 bit		-> analyzer_fsm
--
-- NOTES
-- send_engine supplies payload only: 7 metadata bytes (sample rate, sample count L and H, capture width, trigger mode, and trigger index L and H)
-- then the sample bytes. frame_tx owns sync/version/type/seq/len/CRC and does the actual framing.
--   1) requests a frame from frame_tx, then sends the 7 metadata bytes
--   2) streams the sample bytes from trace_buffer
--   3) pulses o_send_done_pulse once frame_tx confirms the frame is done
--
-- trace_buffer is treated as synchronous-read RAM with a 2-clock read latency (RAM read register,
-- then a mode-mux register). o_ram_rd_addr is registered and driven to trace_buffer before the
-- corresponding i_ram_rd_data sample is launched to tx_mux. WAIT_RAM and WAIT_RAM_2 provide the
-- two required latency stages so the selected RAM byte is valid before SEND_LOW_BYTE/SEND_HIGH_BYTE
-- transmits it.
--
-- The RAM address is incremented only after the current byte has completed transmission.
-- When r_sample_count logical samples have been sent, send_engine waits for frame_tx to
-- finish (WAIT_FRAME_DONE) before asserting o_send_done_pulse and returning to IDLE.

-- TX handshake: send_engine talks to tx_mux
-- o_pl_valid 	: "I have a byte ready"
-- o_pl_byte 	: byte associated with valid signal
-- i_pl_ready	: "byte accepted this cycle"
-- Transfer occurs only when both valid and ready are '1'
-- Otherwise the sender must hold the same byte, not advance FSM or increment counters.

-- i_capture_sample_count and i_capture_width_sel dictate number of bytes to send
-- if width_sel = '0', i.e. 8-channel mode: the latter 8 bits from i_ram_rd_data contains the byte we're looking for
-- if width_sel = '1', i.e. 16-channel mode: the full 16 bits from i_ram_rd_data contains the 2 bytes we're looking for
-- In total, we want to collect <i_capture_sample_count> number of samples (sets of 1 or 2 bytes) from trace_buffer.

-- PREFIXES
-- i_ : input
-- o_ : output
-- r_ : register 			(internal signal; current; 		for sequential process)
-- n_ : next <register> 	(internal signal; next state; 	for combinational process)
-- v_ : variable

-- ITERATIVE PROCESS NOTES:
-- update VHDL entities in OneNote once module is locked
-- ========================================

library IEEE;
use IEEE.STD_LOGIC_1164.ALL;
use IEEE.NUMERIC_STD.ALL;

entity send_engine is
	generic (
		ADDR_LENGTH : integer := 14;
		DATA_LENGTH : integer := 8
	);
	port (
		i_clk					: in  std_logic;
		i_rst_n					: in  std_logic;
		i_send_start_pulse		: in  std_logic;

		i_capture_sample_rate_sel	: in std_logic_vector(1 downto 0);
		i_capture_trigger_mode		: in std_logic_vector(1 downto 0);
		i_capture_trigger_index		: in std_logic_vector(15 downto 0);
		i_capture_start_addr 	: in  std_logic_vector(ADDR_LENGTH-1 downto 0);
		i_capture_sample_count 	: in  std_logic_vector(ADDR_LENGTH-1 downto 0);
		i_capture_width_sel		: in  std_logic;
		i_ram_rd_data			: in  std_logic_vector(2*DATA_LENGTH-1 downto 0);

		o_ram_rd_addr			: out std_logic_vector(ADDR_LENGTH-1 downto 0);

		-- frame_tx
		o_send_frame_req		: out std_logic;
		o_send_frame_len		: out std_logic_vector(15 downto 0);
		i_send_grant			: in  std_logic;
		i_frame_done_pulse		: in  std_logic;

		-- payload out, to tx_mux
		o_pl_byte				: out std_logic_vector(DATA_LENGTH-1 downto 0);
		o_pl_valid				: out std_logic;
		i_pl_ready				: in  std_logic;

		o_send_done_pulse		: out std_logic
	);
end entity send_engine;

architecture RTL of send_engine is
	-- Internal send_engine state machine
	-- Note that UART is slow: 1 byte ≈ 10.85 us ≈ 521 FPGA clocks @ 921600 baud, 24MHz.
	-- @ 6Mbaud, 24MHz: 1 byte (+1start,1stop bit) ≈ 1.67 us = 40 FPGA clocks
	-- I.e. Adding a few FPGA clocks per byte is irrelevant at low baud rate, but becomes more tricky at higher bauds and lower sampling rates
	type send_engine_state_type is (
		IDLE,
		REQUEST,
		SEND_META,
		WAIT_RAM,
		WAIT_RAM_2,
		SEND_LOW_BYTE,
		SEND_HIGH_BYTE,
		WAIT_FRAME_DONE,
		DONE
	);

	-- Register signals, next-state signals
	signal r_state, n_state : send_engine_state_type := IDLE;

	signal r_samples_remaining, n_samples_remaining : unsigned(ADDR_LENGTH-1 downto 0) := (others => '0');  -- samples left to send, including the one in flight
	signal r_ram_rd_addr, n_ram_rd_addr : unsigned(ADDR_LENGTH-1 downto 0) := (others => '0');
	signal r_last_addr, n_last_addr : unsigned(ADDR_LENGTH-1 downto 0) := (others => '0');  -- i_capture_sample_count-1, latched once per send; last valid circular-buffer address before wraparound
	signal r_send_done_pulse, n_send_done_pulse : std_logic := '0';

	-- s_ signals for output process
	signal s_tx_byte  : std_logic_vector(DATA_LENGTH-1 downto 0) := (others => '0');
	signal s_tx_valid : std_logic := '0';

	----------------------------------------------------
	-- Registers pertaining to the payload send_engine supplies to frame_tx
	----------------------------------------------------
	-- Derived frame information
	signal r_payload_len, n_payload_len : unsigned(15 downto 0) := (others => '0');  -- driven out on o_send_frame_len

	-- Values to latch before send operation begins
	signal r_sample_rate_sel, n_sample_rate_sel : std_logic_vector(1 downto 0);
	signal r_sample_count, n_sample_count : unsigned(ADDR_LENGTH-1 downto 0);
	signal r_capture_width_sel, n_capture_width_sel : std_logic;
	signal r_trigger_mode, n_trigger_mode : std_logic_vector(1 downto 0);
	signal r_trigger_index, n_trigger_index : unsigned(15 downto 0);

	-- Metadata payload runtime
	signal r_meta_index, n_meta_index : integer range 0 to 6 := 0;  -- 7 metadata bytes: SAMPLE_RATE..TRIGGER_INDEX_H

begin
	-- Sequential process for dealing with clocking
	seq_proc: process(i_clk) is
	begin
		if rising_edge(i_clk) then
			if i_rst_n = '0' then
				-- reset logic
				r_state <= IDLE;
				r_samples_remaining <= (others => '0');
				r_ram_rd_addr <= (others => '0');
				r_last_addr <= (others => '0');
				r_send_done_pulse <= '0';

				r_payload_len <= (others => '0');
				r_sample_rate_sel <= "00";
				r_sample_count <= (others => '0');
				r_capture_width_sel <= '0';
				r_trigger_mode <= "00";
				r_trigger_index <= (others => '0');
				r_meta_index <= 0;
			else
				r_state <= n_state;
				r_samples_remaining <= n_samples_remaining;
				r_ram_rd_addr <= n_ram_rd_addr;
				r_last_addr <= n_last_addr;
				r_send_done_pulse <= n_send_done_pulse;

				r_payload_len <= n_payload_len;
				r_sample_rate_sel <= n_sample_rate_sel;
				r_sample_count <= n_sample_count;
				r_capture_width_sel <= n_capture_width_sel;
				r_trigger_mode <= n_trigger_mode;
				r_trigger_index <= n_trigger_index;
				r_meta_index <= n_meta_index;
			end if;
		end if;
	end process seq_proc;


	-- Combinational process for dealing with send_engine FSM
	fsm_proc: process(all) is
		variable v_next_addr : unsigned(ADDR_LENGTH-1 downto 0);
	begin
		-- Defaults
		n_state <= r_state;
		n_samples_remaining <= r_samples_remaining;
		n_ram_rd_addr <= r_ram_rd_addr;
		n_last_addr <= r_last_addr;
		n_send_done_pulse <= '0';

		n_payload_len <= r_payload_len;
		n_sample_rate_sel <= r_sample_rate_sel;
		n_sample_count <= r_sample_count;
		n_capture_width_sel <= r_capture_width_sel;
		n_trigger_mode <= r_trigger_mode;
		n_trigger_index <= r_trigger_index;
		n_meta_index <= r_meta_index;

		-- Calculate the next circular-buffer address. r_last_addr is latched once per send (in IDLE)
		-- instead of recomputing r_sample_count-1 here every cycle -- this compare is now two
		-- registers against each other (cheap) rather than a live subtraction feeding a compare.
        if r_sample_count /= to_unsigned(0, ADDR_LENGTH) and r_ram_rd_addr = r_last_addr then
            v_next_addr := (others => '0');
        else
            v_next_addr := r_ram_rd_addr + 1;
        end if;

		case r_state is
			when IDLE =>
				if i_send_start_pulse = '1' then
					-- latch metadata at the start of the send proceure (host READ cmd)
					n_samples_remaining <= unsigned(i_capture_sample_count);
					n_ram_rd_addr <= unsigned(i_capture_start_addr);  -- important for wraparound read. start reading from RAM at correct start_addr
					n_last_addr <= unsigned(i_capture_sample_count) - 1;  -- computed once here, not every cycle -- see wraparound compare above
					n_sample_rate_sel <= i_capture_sample_rate_sel;
					n_sample_count <= unsigned(i_capture_sample_count);
					n_capture_width_sel <= i_capture_width_sel;
					n_trigger_mode <= i_capture_trigger_mode;
					n_trigger_index <= unsigned(i_capture_trigger_index);
					n_meta_index <= 0;

					n_state <= REQUEST;

					-- set payload length based on capture width (8channel/16channel mode)
					if i_capture_width_sel = '0' then	-- 8 channels
						n_payload_len <= resize(unsigned(i_capture_sample_count), 16) + 7;
					else								-- 16 channels
						n_payload_len <= shift_left(resize(unsigned(i_capture_sample_count), 16), 1) + 7;  -- left-shift to double (2 bytes per sample for 16-channel-mode)
					end if;
				end if;

			when REQUEST =>
				-- r_payload_len only becomes valid one clock after i_send_start_pulse, so the
				-- request is asserted from here (registered), not combinationally from IDLE
				if i_send_grant = '1' then
					n_state <= SEND_META;
				end if;

			when SEND_META =>
				-- metadata byte accepted when valid and ready are both high
				if i_pl_ready = '1' then
					if r_meta_index = 6 then
						n_state <= WAIT_RAM;
					else
						n_meta_index <= r_meta_index + 1;
					end if;
				end if;

			when WAIT_RAM =>
				-- First of two cycles of synchronous RAM read latency (trace_buffer registers both the RAM
				-- read and the mode mux afterward, so o_ram_rd_addr -> valid i_ram_rd_data takes 2 clocks)
				n_state <= WAIT_RAM_2;

			when WAIT_RAM_2 =>
				-- Second cycle of RAM read latency; i_ram_rd_data is valid now
				n_state <= SEND_LOW_BYTE;

			when SEND_LOW_BYTE =>
				if i_pl_ready = '1' then
					if r_capture_width_sel = '1' then  -- 16bit sample: low-byte accepted, send high byte
						n_state 		<= SEND_HIGH_BYTE;
					elsif r_samples_remaining = 1 then  -- final 8bit sample accepted
						n_state 		<= WAIT_FRAME_DONE;
					else  -- move to next 8bit sample
						n_samples_remaining <= r_samples_remaining - 1;
						n_ram_rd_addr 	<= v_next_addr;
						n_state 		<= WAIT_RAM;
					end if;
				end if;

			when SEND_HIGH_BYTE =>
				if i_pl_ready = '1' then
					if r_samples_remaining = 1 then  -- final 16bit sample accepted
						n_state 		<= WAIT_FRAME_DONE;
					else  -- current 16bit sample is complete
						n_samples_remaining <= r_samples_remaining - 1;
						n_ram_rd_addr 	<= v_next_addr;
						n_state 		<= WAIT_RAM;
					end if;
				end if;

			when WAIT_FRAME_DONE =>
				-- frame_tx still has CRC_L/CRC_H to send; keep the request asserted until it's done
				if i_frame_done_pulse = '1' then
					n_state <= DONE;
				end if;

			when DONE =>
				n_send_done_pulse 	<= '1';
				n_state 			<= IDLE;

		end case;
	end process fsm_proc;


	output_proc : process(all) is
	begin
		s_tx_valid <= '0';
		s_tx_byte <= (others => '0');

		case r_state is
			when SEND_META =>
				case r_meta_index is
					when 0 => s_tx_byte <= "000000" & r_sample_rate_sel;							-- SAMPLE_RATE
					when 1 => s_tx_byte <= std_logic_vector(r_sample_count(7 downto 0));			-- SAMPLE_COUNT_L
					when 2 => s_tx_byte <= "00" & std_logic_vector(r_sample_count(13 downto 8));	-- SAMPLE_COUNT_H
					when 3 => s_tx_byte <= "0000000" & r_capture_width_sel;						-- CAPTURE_WIDTH
					when 4 => s_tx_byte <= "000000" & r_trigger_mode;								-- TRIGGER_MODE
					when 5 => s_tx_byte <= std_logic_vector(r_trigger_index(7 downto 0));			-- TRIGGER_INDEX_L
					when 6 => s_tx_byte <= std_logic_vector(r_trigger_index(15 downto 8));			-- TRIGGER_INDEX_H
				end case;
				s_tx_valid <= '1';

			when SEND_LOW_BYTE =>
                s_tx_valid <= '1';
                s_tx_byte  <= i_ram_rd_data(DATA_LENGTH-1 downto 0);

            when SEND_HIGH_BYTE =>
                s_tx_valid <= '1';
                s_tx_byte  <= i_ram_rd_data(2*DATA_LENGTH-1 downto DATA_LENGTH);

            when others =>
                null;
		end case;
	end process output_proc;

	-- Set remaining outputs
	o_ram_rd_addr 		<= std_logic_vector(r_ram_rd_addr);
	o_send_done_pulse 	<= r_send_done_pulse;

	o_send_frame_req	<= '1' when r_state /= IDLE and r_state /= DONE else '0';
	o_send_frame_len	<= std_logic_vector(r_payload_len);

	o_pl_valid 	<= s_tx_valid;
	o_pl_byte  	<= s_tx_byte;

end architecture RTL;
