hack-a-tack/FPGA_Logic_Analyzer/rev2/fpga/rtl/cmd_parser.vhd

-- ========================================
-- MODULE: cmd_parser.vhd
-- FUNCTION: decodes opcodes and outputs one-cycle command pulses (and config data)
-- AUTHOR: Jakob Kieszek Ottesen
-- DATE: 2026-03-12 (YYYY-MM-DD)
-- MODIFIED: 2026-05-14 (reset active low)
-- MODIFIED: 2026-07-28 (FSM, config outputs)
-- MODIFIED: 2026-08-17 (rev2)
-- MODIFIED: 2026-08-18 (rev2) (command-byte constants changed from std_logic_vector(DATA_LENGTH-1 downto 0) to a fixed std_logic_vector(7 downto 0); GHDL rejects a generic-dependent subtype as a case choice, Synplify silently accepted it)
-- MODIFIED: 2026-08-19 (rev2) (migrated to la_pkg: all twelve local CMD_* constants deleted, replaced with la_pkg's C_CMD_*, which are already fixed 8-bit and stay locally static as case choices)
--
-- INPUTS					DATA		FROM MODULE
-- i_clk					1 bit		<- clocking
-- i_rst_n					1 bit		<- top
-- i_rx_byte				8 bits 		<- rx_frame_parser
-- i_rx_valid_pulse			1 bit		<- rx_frame_parser
--
-- OUTPUTS					DATA		TO MODULE
-- o_capture_cmd_pulse		1 bit		-> analyzer_fsm
-- o_read_cmd_pulse			1 bit		-> analyzer_fsm
-- o_cmd_error_pulse		1 bit		-> analyzer_fsm
-- o_cmd_opcode				8 bits		-> analyzer_fsm
-- o_cfg_write_pulse		1 bit		-> config_regs
-- o_cfg_opcode				8 bits		-> config_regs
-- o_cfg_value				16 bits		-> config_regs
--
-- NOTES
-- o_cmd_opcode is held, not pulsed: analyzer_fsm samples it one or more cycles after the triggering pulse, so a
-- self-clearing signal would read back as 0x00. It only updates in IDLE, on i_rx_valid_pulse, so it correctly
-- holds the pending command's opcode through WAIT_ARG_1/WAIT_ARG_2 for timeout/error reporting.
--
-- C_CMD_PATTERN_VALUE/C_CMD_PATTERN_MASK (C7/C8) arguments are low byte first, matching every other
-- multi-byte field in the protocol (LEN, SAMPLE_COUNT, TRIGGER_INDEX, CRC, sample data).
--
-- With rx_frame_parser active, a partial command can't arrive over UART any more. Frames are released atomically.
-- The timeout now catches exactly one thing: a well-formed frame carrying an incomplete command, e.g. LEN=1 with
-- payload C1 and no argument.
--
-- PREFIXES
-- i_ : input
-- o_ : output
-- r_ : register 			(internal signal; current; 		for sequential process)

-- ITERATIVE PROCESS NOTES:
-- update VHDL entities in OneNote once module is locked
-- ========================================

library IEEE;
use IEEE.STD_LOGIC_1164.ALL;
use IEEE.NUMERIC_STD.ALL;
use WORK.la_pkg.ALL;

entity cmd_parser is
	generic (
		DATA_LENGTH : integer := 8;
		G_TIMEOUT_CYCLES : positive := 48_000  -- 48,000 cycles at 48 MHz = 1 ms
	);
	port (
		i_clk					: in  std_logic;
		i_rst_n					: in  std_logic;
		
		i_rx_byte				: in  std_logic_vector(DATA_LENGTH-1 downto 0);
		i_rx_valid_pulse		: in  std_logic;
		
		o_capture_cmd_pulse		: out std_logic;
		o_read_cmd_pulse		: out std_logic;
		o_cmd_error_pulse		: out std_logic;
		o_cmd_opcode			: out std_logic_vector(DATA_LENGTH-1 downto 0);

		o_cfg_write_pulse		: out std_logic;
		o_cfg_opcode			: out std_logic_vector(DATA_LENGTH-1 downto 0);
		o_cfg_value				: out std_logic_vector(2*DATA_LENGTH-1 downto 0)
	);
end entity cmd_parser;

architecture RTL of cmd_parser is	
	-- FSM type and signals
	type cmd_parser_state is (IDLE, WAIT_ARG_1, WAIT_ARG_2);
	signal r_state : cmd_parser_state := IDLE;
	
	-- Register signals	
	signal r_pending_cmd : std_logic_vector(DATA_LENGTH-1 downto 0);
	signal r_arg_1 : std_logic_vector(DATA_LENGTH-1 downto 0);
	
	signal r_timeout_count : integer range 0 to G_TIMEOUT_CYCLES - 1 := 0;
	
begin
	parser_proc : process(i_clk)
    begin
        if rising_edge(i_clk) then
            -- Pulse outputs default low every cycle.
            o_capture_cmd_pulse <= '0';
            o_read_cmd_pulse    <= '0';
            o_cmd_error_pulse   <= '0';
            o_cfg_write_pulse   <= '0';

            if i_rst_n = '0' then
                r_state         <= IDLE;
                r_pending_cmd   <= (others => '0');
                r_arg_1         <= (others => '0');
                r_timeout_count <= 0;
                o_cmd_opcode    <= (others => '0');
                o_cfg_opcode    <= (others => '0');
                o_cfg_value     <= (others => '0');
            else
                case r_state is
                    when IDLE =>
                        r_timeout_count <= 0;

                        if i_rx_valid_pulse = '1' then
                            o_cmd_opcode <= i_rx_byte;

                            case i_rx_byte is

                                when C_CMD_CAPTURE	=> o_capture_cmd_pulse <= '1';

                                when C_CMD_READ		=> o_read_cmd_pulse <= '1';

                                when C_CMD_UART_BAUD               |
                                     C_CMD_CAPTURE_WIDTH           |
                                     C_CMD_SAMP_RATE               |
                                     C_CMD_CAPTURE_DEPTH           |
                                     C_CMD_TRIGGER_MODE            |
                                     C_CMD_EDGE_TRIG_CH         |
                                     C_CMD_EDGE_TRIG_TYPE       |
                                     C_CMD_PATTERN_VALUE |
                                     C_CMD_PATTERN_MASK    |
                                     C_CMD_TRIGGER_POSITION =>

                                    r_pending_cmd <= i_rx_byte;
                                    r_state       <= WAIT_ARG_1;

                                when others 		=> o_cmd_error_pulse <= '1';

                            end case;
                        end if;

                    when WAIT_ARG_1 =>
                        if i_rx_valid_pulse = '1' then
                            r_timeout_count <= 0;

                            if (r_pending_cmd = C_CMD_PATTERN_VALUE) or
                               (r_pending_cmd = C_CMD_PATTERN_MASK) then

                                -- First byte is the low byte.
                                r_arg_1 <= i_rx_byte;
                                r_state <= WAIT_ARG_2;

                            else
                                -- One-byte configuration command.
                                o_cfg_opcode      <= r_pending_cmd;
                                o_cfg_value       <= x"00" & i_rx_byte;
                                o_cfg_write_pulse <= '1';
                                r_state <= IDLE;
                            end if;

                        elsif r_timeout_count = G_TIMEOUT_CYCLES - 1 then
                            r_timeout_count  <= 0;
                            r_state          <= IDLE;
                            o_cmd_error_pulse <= '1';

                        else
                            r_timeout_count <= r_timeout_count + 1;
                        end if;

                    when WAIT_ARG_2 =>
                        if i_rx_valid_pulse = '1' then
                            r_timeout_count <= 0;

                            -- Low byte arrived first, high byte arrives now.
                            o_cfg_opcode      <= r_pending_cmd;
                            o_cfg_value       <= i_rx_byte & r_arg_1;
                            o_cfg_write_pulse <= '1';

                            r_state <= IDLE;

                        elsif r_timeout_count = G_TIMEOUT_CYCLES - 1 then
                            r_timeout_count   <= 0;
                            r_state           <= IDLE;
                            o_cmd_error_pulse <= '1';

                        else
                            r_timeout_count <= r_timeout_count + 1;
                        end if;
                end case;
            end if;
        end if;
    end process parser_proc;
	
end architecture RTL;
