hack-a-tack/FPGA_Logic_Analyzer/rev2/fpga/iCEcube2_rev2_logic_analyzer/iCEcube2_rev2_logic_analyzer_Implmnt/sbt/outputs/simulation_netlist/tx_mux_sbt.v

// ******************************************************************************

// iCEcube Netlister

// Version:            2020.12.27943

// Build Date:         Dec  9 2020 18:18:12

// File Generated:     Aug 18 2026 06:55:32

// Purpose:            Post-Route Verilog/VHDL netlist for timing simulation

// Copyright (C) 2006-2010 by Lattice Semiconductor Corp. All rights reserved.

// ******************************************************************************

// Verilog file for cell "tx_mux" view "INTERFACE"

module tx_mux (
    i_resp_pl_byte,
    i_send_pl_byte,
    o_pl_byte,
    o_send_pl_ready,
    i_grant_sel,
    i_send_pl_valid,
    i_resp_pl_valid,
    o_pl_valid,
    o_resp_pl_ready,
    i_pl_ready);

    input [7:0] i_resp_pl_byte;
    input [7:0] i_send_pl_byte;
    output [7:0] o_pl_byte;
    output o_send_pl_ready;
    input i_grant_sel;
    input i_send_pl_valid;
    input i_resp_pl_valid;
    output o_pl_valid;
    output o_resp_pl_ready;
    input i_pl_ready;

    wire N__1192;
    wire N__1191;
    wire N__1190;
    wire N__1183;
    wire N__1182;
    wire N__1181;
    wire N__1174;
    wire N__1173;
    wire N__1172;
    wire N__1165;
    wire N__1164;
    wire N__1163;
    wire N__1156;
    wire N__1155;
    wire N__1154;
    wire N__1147;
    wire N__1146;
    wire N__1145;
    wire N__1138;
    wire N__1137;
    wire N__1136;
    wire N__1129;
    wire N__1128;
    wire N__1127;
    wire N__1120;
    wire N__1119;
    wire N__1118;
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
    wire i_send_pl_byte_c_3;
    wire i_resp_pl_byte_c_3;
    wire o_pl_byte_c_3;
    wire i_resp_pl_byte_c_4;
    wire i_send_pl_byte_c_4;
    wire o_pl_byte_c_4;
    wire o_resp_pl_ready_c;
    wire i_pl_ready_c;
    wire i_grant_sel_c;
    wire o_send_pl_ready_c;
    wire _gnd_net_;

    IO_PAD i_resp_pl_byte_ibuf_5_iopad (
            .OE(N__1192),
            .DIN(N__1191),
            .DOUT(N__1190),
            .PACKAGEPIN(i_resp_pl_byte[5]));
    defparam i_resp_pl_byte_ibuf_5_preio.NEG_TRIGGER=1'b0;
    defparam i_resp_pl_byte_ibuf_5_preio.PIN_TYPE=6'b000001;
    PRE_IO i_resp_pl_byte_ibuf_5_preio (
            .PADOEN(N__1192),
            .PADOUT(N__1191),
            .PADIN(N__1190),
            .CLOCKENABLE(),
            .DOUT1(),
            .OUTPUTENABLE(),
            .DIN0(i_resp_pl_byte_c_5),
            .DOUT0(),
            .INPUTCLK(),
            .LATCHINPUTVALUE(),
            .DIN1(),
            .OUTPUTCLK());
    IO_PAD o_send_pl_ready_obuf_iopad (
            .OE(N__1183),
            .DIN(N__1182),
            .DOUT(N__1181),
            .PACKAGEPIN(o_send_pl_ready));
    defparam o_send_pl_ready_obuf_preio.NEG_TRIGGER=1'b0;
    defparam o_send_pl_ready_obuf_preio.PIN_TYPE=6'b011001;
    PRE_IO o_send_pl_ready_obuf_preio (
            .PADOEN(N__1183),
            .PADOUT(N__1182),
            .PADIN(N__1181),
            .CLOCKENABLE(),
            .DOUT1(),
            .OUTPUTENABLE(),
            .DIN0(),
            .DOUT0(N__708),
            .INPUTCLK(),
            .LATCHINPUTVALUE(),
            .DIN1(),
            .OUTPUTCLK());
    IO_PAD i_send_pl_valid_ibuf_iopad (
            .OE(N__1174),
            .DIN(N__1173),
            .DOUT(N__1172),
            .PACKAGEPIN(i_send_pl_valid));
    defparam i_send_pl_valid_ibuf_preio.NEG_TRIGGER=1'b0;
    defparam i_send_pl_valid_ibuf_preio.PIN_TYPE=6'b000001;
    PRE_IO i_send_pl_valid_ibuf_preio (
            .PADOEN(N__1174),
            .PADOUT(N__1173),
            .PADIN(N__1172),
            .CLOCKENABLE(),
            .DOUT1(),
            .OUTPUTENABLE(),
            .DIN0(i_send_pl_valid_c),
            .DOUT0(),
            .INPUTCLK(),
            .LATCHINPUTVALUE(),
            .DIN1(),
            .OUTPUTCLK());
    IO_PAD o_pl_byte_obuf_1_iopad (
            .OE(N__1165),
            .DIN(N__1164),
            .DOUT(N__1163),
            .PACKAGEPIN(o_pl_byte[1]));
    defparam o_pl_byte_obuf_1_preio.NEG_TRIGGER=1'b0;
    defparam o_pl_byte_obuf_1_preio.PIN_TYPE=6'b011001;
    PRE_IO o_pl_byte_obuf_1_preio (
            .PADOEN(N__1165),
            .PADOUT(N__1164),
            .PADIN(N__1163),
            .CLOCKENABLE(),
            .DOUT1(),
            .OUTPUTENABLE(),
            .DIN0(),
            .DOUT0(N__510),
            .INPUTCLK(),
            .LATCHINPUTVALUE(),
            .DIN1(),
            .OUTPUTCLK());
    IO_PAD i_resp_pl_byte_ibuf_7_iopad (
            .OE(N__1156),
            .DIN(N__1155),
            .DOUT(N__1154),
            .PACKAGEPIN(i_resp_pl_byte[7]));
    defparam i_resp_pl_byte_ibuf_7_preio.NEG_TRIGGER=1'b0;
    defparam i_resp_pl_byte_ibuf_7_preio.PIN_TYPE=6'b000001;
    PRE_IO i_resp_pl_byte_ibuf_7_preio (
            .PADOEN(N__1156),
            .PADOUT(N__1155),
            .PADIN(N__1154),
            .CLOCKENABLE(),
            .DOUT1(),
            .OUTPUTENABLE(),
            .DIN0(i_resp_pl_byte_c_7),
            .DOUT0(),
            .INPUTCLK(),
            .LATCHINPUTVALUE(),
            .DIN1(),
            .OUTPUTCLK());
    IO_PAD i_send_pl_byte_ibuf_5_iopad (
            .OE(N__1147),
            .DIN(N__1146),
            .DOUT(N__1145),
            .PACKAGEPIN(i_send_pl_byte[5]));
    defparam i_send_pl_byte_ibuf_5_preio.NEG_TRIGGER=1'b0;
    defparam i_send_pl_byte_ibuf_5_preio.PIN_TYPE=6'b000001;
    PRE_IO i_send_pl_byte_ibuf_5_preio (
            .PADOEN(N__1147),
            .PADOUT(N__1146),
            .PADIN(N__1145),
            .CLOCKENABLE(),
            .DOUT1(),
            .OUTPUTENABLE(),
            .DIN0(i_send_pl_byte_c_5),
            .DOUT0(),
            .INPUTCLK(),
            .LATCHINPUTVALUE(),
            .DIN1(),
            .OUTPUTCLK());
    IO_PAD o_resp_pl_ready_obuf_iopad (
            .OE(N__1138),
            .DIN(N__1137),
            .DOUT(N__1136),
            .PACKAGEPIN(o_resp_pl_ready));
    defparam o_resp_pl_ready_obuf_preio.NEG_TRIGGER=1'b0;
    defparam o_resp_pl_ready_obuf_preio.PIN_TYPE=6'b011001;
    PRE_IO o_resp_pl_ready_obuf_preio (
            .PADOEN(N__1138),
            .PADOUT(N__1137),
            .PADIN(N__1136),
            .CLOCKENABLE(),
            .DOUT1(),
            .OUTPUTENABLE(),
            .DIN0(),
            .DOUT0(N__795),
            .INPUTCLK(),
            .LATCHINPUTVALUE(),
            .DIN1(),
            .OUTPUTCLK());
    IO_PAD i_resp_pl_byte_ibuf_0_iopad (
            .OE(N__1129),
            .DIN(N__1128),
            .DOUT(N__1127),
            .PACKAGEPIN(i_resp_pl_byte[0]));
    defparam i_resp_pl_byte_ibuf_0_preio.NEG_TRIGGER=1'b0;
    defparam i_resp_pl_byte_ibuf_0_preio.PIN_TYPE=6'b000001;
    PRE_IO i_resp_pl_byte_ibuf_0_preio (
            .PADOEN(N__1129),
            .PADOUT(N__1128),
            .PADIN(N__1127),
            .CLOCKENABLE(),
            .DOUT1(),
            .OUTPUTENABLE(),
            .DIN0(i_resp_pl_byte_c_0),
            .DOUT0(),
            .INPUTCLK(),
            .LATCHINPUTVALUE(),
            .DIN1(),
            .OUTPUTCLK());
    IO_PAD i_send_pl_byte_ibuf_6_iopad (
            .OE(N__1120),
            .DIN(N__1119),
            .DOUT(N__1118),
            .PACKAGEPIN(i_send_pl_byte[6]));
    defparam i_send_pl_byte_ibuf_6_preio.NEG_TRIGGER=1'b0;
    defparam i_send_pl_byte_ibuf_6_preio.PIN_TYPE=6'b000001;
    PRE_IO i_send_pl_byte_ibuf_6_preio (
            .PADOEN(N__1120),
            .PADOUT(N__1119),
            .PADIN(N__1118),
            .CLOCKENABLE(),
            .DOUT1(),
            .OUTPUTENABLE(),
            .DIN0(i_send_pl_byte_c_6),
            .DOUT0(),
            .INPUTCLK(),
            .LATCHINPUTVALUE(),
            .DIN1(),
            .OUTPUTCLK());
    IO_PAD o_pl_byte_obuf_7_iopad (
            .OE(N__1111),
            .DIN(N__1110),
            .DOUT(N__1109),
            .PACKAGEPIN(o_pl_byte[7]));
    defparam o_pl_byte_obuf_7_preio.NEG_TRIGGER=1'b0;
    defparam o_pl_byte_obuf_7_preio.PIN_TYPE=6'b011001;
    PRE_IO o_pl_byte_obuf_7_preio (
            .PADOEN(N__1111),
            .PADOUT(N__1110),
            .PADIN(N__1109),
            .CLOCKENABLE(),
            .DOUT1(),
            .OUTPUTENABLE(),
            .DIN0(),
            .DOUT0(N__654),
            .INPUTCLK(),
            .LATCHINPUTVALUE(),
            .DIN1(),
            .OUTPUTCLK());
    IO_PAD i_resp_pl_byte_ibuf_1_iopad (
            .OE(N__1102),
            .DIN(N__1101),
            .DOUT(N__1100),
            .PACKAGEPIN(i_resp_pl_byte[1]));
    defparam i_resp_pl_byte_ibuf_1_preio.NEG_TRIGGER=1'b0;
    defparam i_resp_pl_byte_ibuf_1_preio.PIN_TYPE=6'b000001;
    PRE_IO i_resp_pl_byte_ibuf_1_preio (
            .PADOEN(N__1102),
            .PADOUT(N__1101),
            .PADIN(N__1100),
            .CLOCKENABLE(),
            .DOUT1(),
            .OUTPUTENABLE(),
            .DIN0(i_resp_pl_byte_c_1),
            .DOUT0(),
            .INPUTCLK(),
            .LATCHINPUTVALUE(),
            .DIN1(),
            .OUTPUTCLK());
    IO_PAD i_send_pl_byte_ibuf_7_iopad (
            .OE(N__1093),
            .DIN(N__1092),
            .DOUT(N__1091),
            .PACKAGEPIN(i_send_pl_byte[7]));
    defparam i_send_pl_byte_ibuf_7_preio.NEG_TRIGGER=1'b0;
    defparam i_send_pl_byte_ibuf_7_preio.PIN_TYPE=6'b000001;
    PRE_IO i_send_pl_byte_ibuf_7_preio (
            .PADOEN(N__1093),
            .PADOUT(N__1092),
            .PADIN(N__1091),
            .CLOCKENABLE(),
            .DOUT1(),
            .OUTPUTENABLE(),
            .DIN0(i_send_pl_byte_c_7),
            .DOUT0(),
            .INPUTCLK(),
            .LATCHINPUTVALUE(),
            .DIN1(),
            .OUTPUTCLK());
    IO_PAD o_pl_byte_obuf_6_iopad (
            .OE(N__1084),
            .DIN(N__1083),
            .DOUT(N__1082),
            .PACKAGEPIN(o_pl_byte[6]));
    defparam o_pl_byte_obuf_6_preio.NEG_TRIGGER=1'b0;
    defparam o_pl_byte_obuf_6_preio.PIN_TYPE=6'b011001;
    PRE_IO o_pl_byte_obuf_6_preio (
            .PADOEN(N__1084),
            .PADOUT(N__1083),
            .PADIN(N__1082),
            .CLOCKENABLE(),
            .DOUT1(),
            .OUTPUTENABLE(),
            .DIN0(),
            .DOUT0(N__684),
            .INPUTCLK(),
            .LATCHINPUTVALUE(),
            .DIN1(),
            .OUTPUTCLK());
    IO_PAD i_resp_pl_byte_ibuf_2_iopad (
            .OE(N__1075),
            .DIN(N__1074),
            .DOUT(N__1073),
            .PACKAGEPIN(i_resp_pl_byte[2]));
    defparam i_resp_pl_byte_ibuf_2_preio.NEG_TRIGGER=1'b0;
    defparam i_resp_pl_byte_ibuf_2_preio.PIN_TYPE=6'b000001;
    PRE_IO i_resp_pl_byte_ibuf_2_preio (
            .PADOEN(N__1075),
            .PADOUT(N__1074),
            .PADIN(N__1073),
            .CLOCKENABLE(),
            .DOUT1(),
            .OUTPUTENABLE(),
            .DIN0(i_resp_pl_byte_c_2),
            .DOUT0(),
            .INPUTCLK(),
            .LATCHINPUTVALUE(),
            .DIN1(),
            .OUTPUTCLK());
    IO_PAD i_send_pl_byte_ibuf_0_iopad (
            .OE(N__1066),
            .DIN(N__1065),
            .DOUT(N__1064),
            .PACKAGEPIN(i_send_pl_byte[0]));
    defparam i_send_pl_byte_ibuf_0_preio.NEG_TRIGGER=1'b0;
    defparam i_send_pl_byte_ibuf_0_preio.PIN_TYPE=6'b000001;
    PRE_IO i_send_pl_byte_ibuf_0_preio (
            .PADOEN(N__1066),
            .PADOUT(N__1065),
            .PADIN(N__1064),
            .CLOCKENABLE(),
            .DOUT1(),
            .OUTPUTENABLE(),
            .DIN0(i_send_pl_byte_c_0),
            .DOUT0(),
            .INPUTCLK(),
            .LATCHINPUTVALUE(),
            .DIN1(),
            .OUTPUTCLK());
    IO_PAD o_pl_byte_obuf_5_iopad (
            .OE(N__1057),
            .DIN(N__1056),
            .DOUT(N__1055),
            .PACKAGEPIN(o_pl_byte[5]));
    defparam o_pl_byte_obuf_5_preio.NEG_TRIGGER=1'b0;
    defparam o_pl_byte_obuf_5_preio.PIN_TYPE=6'b011001;
    PRE_IO o_pl_byte_obuf_5_preio (
            .PADOEN(N__1057),
            .PADOUT(N__1056),
            .PADIN(N__1055),
            .CLOCKENABLE(),
            .DOUT1(),
            .OUTPUTENABLE(),
            .DIN0(),
            .DOUT0(N__552),
            .INPUTCLK(),
            .LATCHINPUTVALUE(),
            .DIN1(),
            .OUTPUTCLK());
    IO_PAD o_pl_valid_obuf_iopad (
            .OE(N__1048),
            .DIN(N__1047),
            .DOUT(N__1046),
            .PACKAGEPIN(o_pl_valid));
    defparam o_pl_valid_obuf_preio.NEG_TRIGGER=1'b0;
    defparam o_pl_valid_obuf_preio.PIN_TYPE=6'b011001;
    PRE_IO o_pl_valid_obuf_preio (
            .PADOEN(N__1048),
            .PADOUT(N__1047),
            .PADIN(N__1046),
            .CLOCKENABLE(),
            .DOUT1(),
            .OUTPUTENABLE(),
            .DIN0(),
            .DOUT0(N__624),
            .INPUTCLK(),
            .LATCHINPUTVALUE(),
            .DIN1(),
            .OUTPUTCLK());
    IO_PAD i_grant_sel_ibuf_iopad (
            .OE(N__1039),
            .DIN(N__1038),
            .DOUT(N__1037),
            .PACKAGEPIN(i_grant_sel));
    defparam i_grant_sel_ibuf_preio.NEG_TRIGGER=1'b0;
    defparam i_grant_sel_ibuf_preio.PIN_TYPE=6'b000001;
    PRE_IO i_grant_sel_ibuf_preio (
            .PADOEN(N__1039),
            .PADOUT(N__1038),
            .PADIN(N__1037),
            .CLOCKENABLE(),
            .DOUT1(),
            .OUTPUTENABLE(),
            .DIN0(i_grant_sel_c),
            .DOUT0(),
            .INPUTCLK(),
            .LATCHINPUTVALUE(),
            .DIN1(),
            .OUTPUTCLK());
    IO_PAD i_resp_pl_byte_ibuf_3_iopad (
            .OE(N__1030),
            .DIN(N__1029),
            .DOUT(N__1028),
            .PACKAGEPIN(i_resp_pl_byte[3]));
    defparam i_resp_pl_byte_ibuf_3_preio.NEG_TRIGGER=1'b0;
    defparam i_resp_pl_byte_ibuf_3_preio.PIN_TYPE=6'b000001;
    PRE_IO i_resp_pl_byte_ibuf_3_preio (
            .PADOEN(N__1030),
            .PADOUT(N__1029),
            .PADIN(N__1028),
            .CLOCKENABLE(),
            .DOUT1(),
            .OUTPUTENABLE(),
            .DIN0(i_resp_pl_byte_c_3),
            .DOUT0(),
            .INPUTCLK(),
            .LATCHINPUTVALUE(),
            .DIN1(),
            .OUTPUTCLK());
    IO_PAD i_resp_pl_valid_ibuf_iopad (
            .OE(N__1021),
            .DIN(N__1020),
            .DOUT(N__1019),
            .PACKAGEPIN(i_resp_pl_valid));
    defparam i_resp_pl_valid_ibuf_preio.NEG_TRIGGER=1'b0;
    defparam i_resp_pl_valid_ibuf_preio.PIN_TYPE=6'b000001;
    PRE_IO i_resp_pl_valid_ibuf_preio (
            .PADOEN(N__1021),
            .PADOUT(N__1020),
            .PADIN(N__1019),
            .CLOCKENABLE(),
            .DOUT1(),
            .OUTPUTENABLE(),
            .DIN0(i_resp_pl_valid_c),
            .DOUT0(),
            .INPUTCLK(),
            .LATCHINPUTVALUE(),
            .DIN1(),
            .OUTPUTCLK());
    IO_PAD i_send_pl_byte_ibuf_1_iopad (
            .OE(N__1012),
            .DIN(N__1011),
            .DOUT(N__1010),
            .PACKAGEPIN(i_send_pl_byte[1]));
    defparam i_send_pl_byte_ibuf_1_preio.NEG_TRIGGER=1'b0;
    defparam i_send_pl_byte_ibuf_1_preio.PIN_TYPE=6'b000001;
    PRE_IO i_send_pl_byte_ibuf_1_preio (
            .PADOEN(N__1012),
            .PADOUT(N__1011),
            .PADIN(N__1010),
            .CLOCKENABLE(),
            .DOUT1(),
            .OUTPUTENABLE(),
            .DIN0(i_send_pl_byte_c_1),
            .DOUT0(),
            .INPUTCLK(),
            .LATCHINPUTVALUE(),
            .DIN1(),
            .OUTPUTCLK());
    IO_PAD o_pl_byte_obuf_4_iopad (
            .OE(N__1003),
            .DIN(N__1002),
            .DOUT(N__1001),
            .PACKAGEPIN(o_pl_byte[4]));
    defparam o_pl_byte_obuf_4_preio.NEG_TRIGGER=1'b0;
    defparam o_pl_byte_obuf_4_preio.PIN_TYPE=6'b011001;
    PRE_IO o_pl_byte_obuf_4_preio (
            .PADOEN(N__1003),
            .PADOUT(N__1002),
            .PADIN(N__1001),
            .CLOCKENABLE(),
            .DOUT1(),
            .OUTPUTENABLE(),
            .DIN0(),
            .DOUT0(N__810),
            .INPUTCLK(),
            .LATCHINPUTVALUE(),
            .DIN1(),
            .OUTPUTCLK());
    IO_PAD i_resp_pl_byte_ibuf_4_iopad (
            .OE(N__994),
            .DIN(N__993),
            .DOUT(N__992),
            .PACKAGEPIN(i_resp_pl_byte[4]));
    defparam i_resp_pl_byte_ibuf_4_preio.NEG_TRIGGER=1'b0;
    defparam i_resp_pl_byte_ibuf_4_preio.PIN_TYPE=6'b000001;
    PRE_IO i_resp_pl_byte_ibuf_4_preio (
            .PADOEN(N__994),
            .PADOUT(N__993),
            .PADIN(N__992),
            .CLOCKENABLE(),
            .DOUT1(),
            .OUTPUTENABLE(),
            .DIN0(i_resp_pl_byte_c_4),
            .DOUT0(),
            .INPUTCLK(),
            .LATCHINPUTVALUE(),
            .DIN1(),
            .OUTPUTCLK());
    IO_PAD i_send_pl_byte_ibuf_2_iopad (
            .OE(N__985),
            .DIN(N__984),
            .DOUT(N__983),
            .PACKAGEPIN(i_send_pl_byte[2]));
    defparam i_send_pl_byte_ibuf_2_preio.NEG_TRIGGER=1'b0;
    defparam i_send_pl_byte_ibuf_2_preio.PIN_TYPE=6'b000001;
    PRE_IO i_send_pl_byte_ibuf_2_preio (
            .PADOEN(N__985),
            .PADOUT(N__984),
            .PADIN(N__983),
            .CLOCKENABLE(),
            .DOUT1(),
            .OUTPUTENABLE(),
            .DIN0(i_send_pl_byte_c_2),
            .DOUT0(),
            .INPUTCLK(),
            .LATCHINPUTVALUE(),
            .DIN1(),
            .OUTPUTCLK());
    IO_PAD o_pl_byte_obuf_3_iopad (
            .OE(N__976),
            .DIN(N__975),
            .DOUT(N__974),
            .PACKAGEPIN(o_pl_byte[3]));
    defparam o_pl_byte_obuf_3_preio.NEG_TRIGGER=1'b0;
    defparam o_pl_byte_obuf_3_preio.PIN_TYPE=6'b011001;
    PRE_IO o_pl_byte_obuf_3_preio (
            .PADOEN(N__976),
            .PADOUT(N__975),
            .PADIN(N__974),
            .CLOCKENABLE(),
            .DOUT1(),
            .OUTPUTENABLE(),
            .DIN0(),
            .DOUT0(N__843),
            .INPUTCLK(),
            .LATCHINPUTVALUE(),
            .DIN1(),
            .OUTPUTCLK());
    IO_PAD i_pl_ready_ibuf_iopad (
            .OE(N__967),
            .DIN(N__966),
            .DOUT(N__965),
            .PACKAGEPIN(i_pl_ready));
    defparam i_pl_ready_ibuf_preio.NEG_TRIGGER=1'b0;
    defparam i_pl_ready_ibuf_preio.PIN_TYPE=6'b000001;
    PRE_IO i_pl_ready_ibuf_preio (
            .PADOEN(N__967),
            .PADOUT(N__966),
            .PADIN(N__965),
            .CLOCKENABLE(),
            .DOUT1(),
            .OUTPUTENABLE(),
            .DIN0(i_pl_ready_c),
            .DOUT0(),
            .INPUTCLK(),
            .LATCHINPUTVALUE(),
            .DIN1(),
            .OUTPUTCLK());
    IO_PAD i_send_pl_byte_ibuf_3_iopad (
            .OE(N__958),
            .DIN(N__957),
            .DOUT(N__956),
            .PACKAGEPIN(i_send_pl_byte[3]));
    defparam i_send_pl_byte_ibuf_3_preio.NEG_TRIGGER=1'b0;
    defparam i_send_pl_byte_ibuf_3_preio.PIN_TYPE=6'b000001;
    PRE_IO i_send_pl_byte_ibuf_3_preio (
            .PADOEN(N__958),
            .PADOUT(N__957),
            .PADIN(N__956),
            .CLOCKENABLE(),
            .DOUT1(),
            .OUTPUTENABLE(),
            .DIN0(i_send_pl_byte_c_3),
            .DOUT0(),
            .INPUTCLK(),
            .LATCHINPUTVALUE(),
            .DIN1(),
            .OUTPUTCLK());
    IO_PAD o_pl_byte_obuf_2_iopad (
            .OE(N__949),
            .DIN(N__948),
            .DOUT(N__947),
            .PACKAGEPIN(o_pl_byte[2]));
    defparam o_pl_byte_obuf_2_preio.NEG_TRIGGER=1'b0;
    defparam o_pl_byte_obuf_2_preio.PIN_TYPE=6'b011001;
    PRE_IO o_pl_byte_obuf_2_preio (
            .PADOEN(N__949),
            .PADOUT(N__948),
            .PADIN(N__947),
            .CLOCKENABLE(),
            .DOUT1(),
            .OUTPUTENABLE(),
            .DIN0(),
            .DOUT0(N__879),
            .INPUTCLK(),
            .LATCHINPUTVALUE(),
            .DIN1(),
            .OUTPUTCLK());
    IO_PAD i_resp_pl_byte_ibuf_6_iopad (
            .OE(N__940),
            .DIN(N__939),
            .DOUT(N__938),
            .PACKAGEPIN(i_resp_pl_byte[6]));
    defparam i_resp_pl_byte_ibuf_6_preio.NEG_TRIGGER=1'b0;
    defparam i_resp_pl_byte_ibuf_6_preio.PIN_TYPE=6'b000001;
    PRE_IO i_resp_pl_byte_ibuf_6_preio (
            .PADOEN(N__940),
            .PADOUT(N__939),
            .PADIN(N__938),
            .CLOCKENABLE(),
            .DOUT1(),
            .OUTPUTENABLE(),
            .DIN0(i_resp_pl_byte_c_6),
            .DOUT0(),
            .INPUTCLK(),
            .LATCHINPUTVALUE(),
            .DIN1(),
            .OUTPUTCLK());
    IO_PAD i_send_pl_byte_ibuf_4_iopad (
            .OE(N__931),
            .DIN(N__930),
            .DOUT(N__929),
            .PACKAGEPIN(i_send_pl_byte[4]));
    defparam i_send_pl_byte_ibuf_4_preio.NEG_TRIGGER=1'b0;
    defparam i_send_pl_byte_ibuf_4_preio.PIN_TYPE=6'b000001;
    PRE_IO i_send_pl_byte_ibuf_4_preio (
            .PADOEN(N__931),
            .PADOUT(N__930),
            .PADIN(N__929),
            .CLOCKENABLE(),
            .DOUT1(),
            .OUTPUTENABLE(),
            .DIN0(i_send_pl_byte_c_4),
            .DOUT0(),
            .INPUTCLK(),
            .LATCHINPUTVALUE(),
            .DIN1(),
            .OUTPUTCLK());
    IO_PAD o_pl_byte_obuf_0_iopad (
            .OE(N__922),
            .DIN(N__921),
            .DOUT(N__920),
            .PACKAGEPIN(o_pl_byte[0]));
    defparam o_pl_byte_obuf_0_preio.NEG_TRIGGER=1'b0;
    defparam o_pl_byte_obuf_0_preio.PIN_TYPE=6'b011001;
    PRE_IO o_pl_byte_obuf_0_preio (
            .PADOEN(N__922),
            .PADOUT(N__921),
            .PADIN(N__920),
            .CLOCKENABLE(),
            .DOUT1(),
            .OUTPUTENABLE(),
            .DIN0(),
            .DOUT0(N__588),
            .INPUTCLK(),
            .LATCHINPUTVALUE(),
            .DIN1(),
            .OUTPUTCLK());
    InMux I__179 (
            .O(N__903),
            .I(N__900));
    LocalMux I__178 (
            .O(N__900),
            .I(i_send_pl_byte_c_2));
    InMux I__177 (
            .O(N__897),
            .I(N__894));
    LocalMux I__176 (
            .O(N__894),
            .I(N__891));
    Span4Mux_s2_v I__175 (
            .O(N__891),
            .I(N__888));
    Sp12to4 I__174 (
            .O(N__888),
            .I(N__885));
    Span12Mux_h I__173 (
            .O(N__885),
            .I(N__882));
    Odrv12 I__172 (
            .O(N__882),
            .I(i_resp_pl_byte_c_2));
    IoInMux I__171 (
            .O(N__879),
            .I(N__876));
    LocalMux I__170 (
            .O(N__876),
            .I(N__873));
    Span4Mux_s0_v I__169 (
            .O(N__873),
            .I(N__870));
    Sp12to4 I__168 (
            .O(N__870),
            .I(N__867));
    Odrv12 I__167 (
            .O(N__867),
            .I(o_pl_byte_c_2));
    InMux I__166 (
            .O(N__864),
            .I(N__861));
    LocalMux I__165 (
            .O(N__861),
            .I(i_send_pl_byte_c_3));
    InMux I__164 (
            .O(N__858),
            .I(N__855));
    LocalMux I__163 (
            .O(N__855),
            .I(N__852));
    Span4Mux_h I__162 (
            .O(N__852),
            .I(N__849));
    Span4Mux_h I__161 (
            .O(N__849),
            .I(N__846));
    Odrv4 I__160 (
            .O(N__846),
            .I(i_resp_pl_byte_c_3));
    IoInMux I__159 (
            .O(N__843),
            .I(N__840));
    LocalMux I__158 (
            .O(N__840),
            .I(N__837));
    Span4Mux_s0_v I__157 (
            .O(N__837),
            .I(N__834));
    Span4Mux_h I__156 (
            .O(N__834),
            .I(N__831));
    Odrv4 I__155 (
            .O(N__831),
            .I(o_pl_byte_c_3));
    InMux I__154 (
            .O(N__828),
            .I(N__825));
    LocalMux I__153 (
            .O(N__825),
            .I(N__822));
    Span4Mux_h I__152 (
            .O(N__822),
            .I(N__819));
    Odrv4 I__151 (
            .O(N__819),
            .I(i_resp_pl_byte_c_4));
    InMux I__150 (
            .O(N__816),
            .I(N__813));
    LocalMux I__149 (
            .O(N__813),
            .I(i_send_pl_byte_c_4));
    IoInMux I__148 (
            .O(N__810),
            .I(N__807));
    LocalMux I__147 (
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
    LogicCell40 o_send_pl_ready_obuf_RNO_LC_18_30_5 (
            .in0(N__789),
            .in1(_gnd_net_),
            .in2(_gnd_net_),
            .in3(N__758),
            .lcout(o_send_pl_ready_c),
            .ltout(),
            .carryin(_gnd_net_),
            .carryout(),
            .clk(_gnd_net_),
            .ce(),
            .sr(_gnd_net_));
endmodule // tx_mux
