hack-a-tack/FPGA_Logic_Analyzer/rev2/fpga/iCEcube2_rev2_logic_analyzer/iCEcube2_rev2_logic_analyzer_Implmnt/sbt/outputs/simulation_netlist/tx_mux_sbt.vhd

-- ******************************************************************************

-- iCEcube Netlister

-- Version:            2020.12.27943

-- Build Date:         Dec  9 2020 18:18:06

-- File Generated:     Aug 18 2026 06:55:32

-- Purpose:            Post-Route Verilog/VHDL netlist for timing simulation

-- Copyright (C) 2006-2010 by Lattice Semiconductor Corp. All rights reserved.

-- ******************************************************************************

-- VHDL file for cell "tx_mux" view "INTERFACE"

library ieee;
use ieee.std_logic_1164.all;
use ieee.std_logic_arith.all;
use ieee.std_logic_unsigned.all;

library ice;
use ice.vcomponent_vital.all;

-- Entity of tx_mux
entity tx_mux is
port (
    i_resp_pl_byte : in std_logic_vector(7 downto 0);
    i_send_pl_byte : in std_logic_vector(7 downto 0);
    o_pl_byte : out std_logic_vector(7 downto 0);
    o_send_pl_ready : out std_logic;
    i_grant_sel : in std_logic;
    i_send_pl_valid : in std_logic;
    i_resp_pl_valid : in std_logic;
    o_pl_valid : out std_logic;
    o_resp_pl_ready : out std_logic;
    i_pl_ready : in std_logic);
end tx_mux;

-- Architecture of tx_mux
-- View name is \INTERFACE\
architecture \INTERFACE\ of tx_mux is

signal \N__1192\ : std_logic;
signal \N__1191\ : std_logic;
signal \N__1190\ : std_logic;
signal \N__1183\ : std_logic;
signal \N__1182\ : std_logic;
signal \N__1181\ : std_logic;
signal \N__1174\ : std_logic;
signal \N__1173\ : std_logic;
signal \N__1172\ : std_logic;
signal \N__1165\ : std_logic;
signal \N__1164\ : std_logic;
signal \N__1163\ : std_logic;
signal \N__1156\ : std_logic;
signal \N__1155\ : std_logic;
signal \N__1154\ : std_logic;
signal \N__1147\ : std_logic;
signal \N__1146\ : std_logic;
signal \N__1145\ : std_logic;
signal \N__1138\ : std_logic;
signal \N__1137\ : std_logic;
signal \N__1136\ : std_logic;
signal \N__1129\ : std_logic;
signal \N__1128\ : std_logic;
signal \N__1127\ : std_logic;
signal \N__1120\ : std_logic;
signal \N__1119\ : std_logic;
signal \N__1118\ : std_logic;
signal \N__1111\ : std_logic;
signal \N__1110\ : std_logic;
signal \N__1109\ : std_logic;
signal \N__1102\ : std_logic;
signal \N__1101\ : std_logic;
signal \N__1100\ : std_logic;
signal \N__1093\ : std_logic;
signal \N__1092\ : std_logic;
signal \N__1091\ : std_logic;
signal \N__1084\ : std_logic;
signal \N__1083\ : std_logic;
signal \N__1082\ : std_logic;
signal \N__1075\ : std_logic;
signal \N__1074\ : std_logic;
signal \N__1073\ : std_logic;
signal \N__1066\ : std_logic;
signal \N__1065\ : std_logic;
signal \N__1064\ : std_logic;
signal \N__1057\ : std_logic;
signal \N__1056\ : std_logic;
signal \N__1055\ : std_logic;
signal \N__1048\ : std_logic;
signal \N__1047\ : std_logic;
signal \N__1046\ : std_logic;
signal \N__1039\ : std_logic;
signal \N__1038\ : std_logic;
signal \N__1037\ : std_logic;
signal \N__1030\ : std_logic;
signal \N__1029\ : std_logic;
signal \N__1028\ : std_logic;
signal \N__1021\ : std_logic;
signal \N__1020\ : std_logic;
signal \N__1019\ : std_logic;
signal \N__1012\ : std_logic;
signal \N__1011\ : std_logic;
signal \N__1010\ : std_logic;
signal \N__1003\ : std_logic;
signal \N__1002\ : std_logic;
signal \N__1001\ : std_logic;
signal \N__994\ : std_logic;
signal \N__993\ : std_logic;
signal \N__992\ : std_logic;
signal \N__985\ : std_logic;
signal \N__984\ : std_logic;
signal \N__983\ : std_logic;
signal \N__976\ : std_logic;
signal \N__975\ : std_logic;
signal \N__974\ : std_logic;
signal \N__967\ : std_logic;
signal \N__966\ : std_logic;
signal \N__965\ : std_logic;
signal \N__958\ : std_logic;
signal \N__957\ : std_logic;
signal \N__956\ : std_logic;
signal \N__949\ : std_logic;
signal \N__948\ : std_logic;
signal \N__947\ : std_logic;
signal \N__940\ : std_logic;
signal \N__939\ : std_logic;
signal \N__938\ : std_logic;
signal \N__931\ : std_logic;
signal \N__930\ : std_logic;
signal \N__929\ : std_logic;
signal \N__922\ : std_logic;
signal \N__921\ : std_logic;
signal \N__920\ : std_logic;
signal \N__903\ : std_logic;
signal \N__900\ : std_logic;
signal \N__897\ : std_logic;
signal \N__894\ : std_logic;
signal \N__891\ : std_logic;
signal \N__888\ : std_logic;
signal \N__885\ : std_logic;
signal \N__882\ : std_logic;
signal \N__879\ : std_logic;
signal \N__876\ : std_logic;
signal \N__873\ : std_logic;
signal \N__870\ : std_logic;
signal \N__867\ : std_logic;
signal \N__864\ : std_logic;
signal \N__861\ : std_logic;
signal \N__858\ : std_logic;
signal \N__855\ : std_logic;
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
signal i_resp_pl_byte_c_2 : std_logic;
signal o_pl_byte_c_2 : std_logic;
signal i_send_pl_byte_c_3 : std_logic;
signal i_resp_pl_byte_c_3 : std_logic;
signal o_pl_byte_c_3 : std_logic;
signal i_resp_pl_byte_c_4 : std_logic;
signal i_send_pl_byte_c_4 : std_logic;
signal o_pl_byte_c_4 : std_logic;
signal o_resp_pl_ready_c : std_logic;
signal i_pl_ready_c : std_logic;
signal i_grant_sel_c : std_logic;
signal o_send_pl_ready_c : std_logic;
signal \_gnd_net_\ : std_logic;

signal i_resp_pl_byte_wire : std_logic_vector(7 downto 0);
signal o_send_pl_ready_wire : std_logic;
signal i_send_pl_valid_wire : std_logic;
signal o_pl_byte_wire : std_logic_vector(7 downto 0);
signal i_send_pl_byte_wire : std_logic_vector(7 downto 0);
signal o_resp_pl_ready_wire : std_logic;
signal o_pl_valid_wire : std_logic;
signal i_grant_sel_wire : std_logic;
signal i_resp_pl_valid_wire : std_logic;
signal i_pl_ready_wire : std_logic;

begin
    i_resp_pl_byte_wire <= i_resp_pl_byte;
    o_send_pl_ready <= o_send_pl_ready_wire;
    i_send_pl_valid_wire <= i_send_pl_valid;
    o_pl_byte <= o_pl_byte_wire;
    i_send_pl_byte_wire <= i_send_pl_byte;
    o_resp_pl_ready <= o_resp_pl_ready_wire;
    o_pl_valid <= o_pl_valid_wire;
    i_grant_sel_wire <= i_grant_sel;
    i_resp_pl_valid_wire <= i_resp_pl_valid;
    i_pl_ready_wire <= i_pl_ready;

    \i_resp_pl_byte_ibuf_5_iopad\ : IO_PAD
    generic map (
            IO_STANDARD => "SB_LVCMOS",
            PULLUP => '0'
        )
    port map (
            OE => \N__1192\,
            DIN => \N__1191\,
            DOUT => \N__1190\,
            PACKAGEPIN => i_resp_pl_byte_wire(5)
        );

    \i_resp_pl_byte_ibuf_5_preio\ : PRE_IO
    generic map (
            NEG_TRIGGER => '0',
            PIN_TYPE => "000001"
        )
    port map (
            PADOEN => \N__1192\,
            PADOUT => \N__1191\,
            PADIN => \N__1190\,
            CLOCKENABLE => 'H',
            DOUT1 => '0',
            OUTPUTENABLE => '0',
            DIN0 => i_resp_pl_byte_c_5,
            DOUT0 => '0',
            INPUTCLK => '0',
            LATCHINPUTVALUE => '0',
            DIN1 => OPEN,
            OUTPUTCLK => '0'
        );

    \o_send_pl_ready_obuf_iopad\ : IO_PAD
    generic map (
            IO_STANDARD => "SB_LVCMOS",
            PULLUP => '0'
        )
    port map (
            OE => \N__1183\,
            DIN => \N__1182\,
            DOUT => \N__1181\,
            PACKAGEPIN => o_send_pl_ready_wire
        );

    \o_send_pl_ready_obuf_preio\ : PRE_IO
    generic map (
            NEG_TRIGGER => '0',
            PIN_TYPE => "011001"
        )
    port map (
            PADOEN => \N__1183\,
            PADOUT => \N__1182\,
            PADIN => \N__1181\,
            CLOCKENABLE => 'H',
            DOUT1 => '0',
            OUTPUTENABLE => '0',
            DIN0 => OPEN,
            DOUT0 => \N__708\,
            INPUTCLK => '0',
            LATCHINPUTVALUE => '0',
            DIN1 => OPEN,
            OUTPUTCLK => '0'
        );

    \i_send_pl_valid_ibuf_iopad\ : IO_PAD
    generic map (
            IO_STANDARD => "SB_LVCMOS",
            PULLUP => '0'
        )
    port map (
            OE => \N__1174\,
            DIN => \N__1173\,
            DOUT => \N__1172\,
            PACKAGEPIN => i_send_pl_valid_wire
        );

    \i_send_pl_valid_ibuf_preio\ : PRE_IO
    generic map (
            NEG_TRIGGER => '0',
            PIN_TYPE => "000001"
        )
    port map (
            PADOEN => \N__1174\,
            PADOUT => \N__1173\,
            PADIN => \N__1172\,
            CLOCKENABLE => 'H',
            DOUT1 => '0',
            OUTPUTENABLE => '0',
            DIN0 => i_send_pl_valid_c,
            DOUT0 => '0',
            INPUTCLK => '0',
            LATCHINPUTVALUE => '0',
            DIN1 => OPEN,
            OUTPUTCLK => '0'
        );

    \o_pl_byte_obuf_1_iopad\ : IO_PAD
    generic map (
            IO_STANDARD => "SB_LVCMOS",
            PULLUP => '0'
        )
    port map (
            OE => \N__1165\,
            DIN => \N__1164\,
            DOUT => \N__1163\,
            PACKAGEPIN => o_pl_byte_wire(1)
        );

    \o_pl_byte_obuf_1_preio\ : PRE_IO
    generic map (
            NEG_TRIGGER => '0',
            PIN_TYPE => "011001"
        )
    port map (
            PADOEN => \N__1165\,
            PADOUT => \N__1164\,
            PADIN => \N__1163\,
            CLOCKENABLE => 'H',
            DOUT1 => '0',
            OUTPUTENABLE => '0',
            DIN0 => OPEN,
            DOUT0 => \N__510\,
            INPUTCLK => '0',
            LATCHINPUTVALUE => '0',
            DIN1 => OPEN,
            OUTPUTCLK => '0'
        );

    \i_resp_pl_byte_ibuf_7_iopad\ : IO_PAD
    generic map (
            IO_STANDARD => "SB_LVCMOS",
            PULLUP => '0'
        )
    port map (
            OE => \N__1156\,
            DIN => \N__1155\,
            DOUT => \N__1154\,
            PACKAGEPIN => i_resp_pl_byte_wire(7)
        );

    \i_resp_pl_byte_ibuf_7_preio\ : PRE_IO
    generic map (
            NEG_TRIGGER => '0',
            PIN_TYPE => "000001"
        )
    port map (
            PADOEN => \N__1156\,
            PADOUT => \N__1155\,
            PADIN => \N__1154\,
            CLOCKENABLE => 'H',
            DOUT1 => '0',
            OUTPUTENABLE => '0',
            DIN0 => i_resp_pl_byte_c_7,
            DOUT0 => '0',
            INPUTCLK => '0',
            LATCHINPUTVALUE => '0',
            DIN1 => OPEN,
            OUTPUTCLK => '0'
        );

    \i_send_pl_byte_ibuf_5_iopad\ : IO_PAD
    generic map (
            IO_STANDARD => "SB_LVCMOS",
            PULLUP => '0'
        )
    port map (
            OE => \N__1147\,
            DIN => \N__1146\,
            DOUT => \N__1145\,
            PACKAGEPIN => i_send_pl_byte_wire(5)
        );

    \i_send_pl_byte_ibuf_5_preio\ : PRE_IO
    generic map (
            NEG_TRIGGER => '0',
            PIN_TYPE => "000001"
        )
    port map (
            PADOEN => \N__1147\,
            PADOUT => \N__1146\,
            PADIN => \N__1145\,
            CLOCKENABLE => 'H',
            DOUT1 => '0',
            OUTPUTENABLE => '0',
            DIN0 => i_send_pl_byte_c_5,
            DOUT0 => '0',
            INPUTCLK => '0',
            LATCHINPUTVALUE => '0',
            DIN1 => OPEN,
            OUTPUTCLK => '0'
        );

    \o_resp_pl_ready_obuf_iopad\ : IO_PAD
    generic map (
            IO_STANDARD => "SB_LVCMOS",
            PULLUP => '0'
        )
    port map (
            OE => \N__1138\,
            DIN => \N__1137\,
            DOUT => \N__1136\,
            PACKAGEPIN => o_resp_pl_ready_wire
        );

    \o_resp_pl_ready_obuf_preio\ : PRE_IO
    generic map (
            NEG_TRIGGER => '0',
            PIN_TYPE => "011001"
        )
    port map (
            PADOEN => \N__1138\,
            PADOUT => \N__1137\,
            PADIN => \N__1136\,
            CLOCKENABLE => 'H',
            DOUT1 => '0',
            OUTPUTENABLE => '0',
            DIN0 => OPEN,
            DOUT0 => \N__795\,
            INPUTCLK => '0',
            LATCHINPUTVALUE => '0',
            DIN1 => OPEN,
            OUTPUTCLK => '0'
        );

    \i_resp_pl_byte_ibuf_0_iopad\ : IO_PAD
    generic map (
            IO_STANDARD => "SB_LVCMOS",
            PULLUP => '0'
        )
    port map (
            OE => \N__1129\,
            DIN => \N__1128\,
            DOUT => \N__1127\,
            PACKAGEPIN => i_resp_pl_byte_wire(0)
        );

    \i_resp_pl_byte_ibuf_0_preio\ : PRE_IO
    generic map (
            NEG_TRIGGER => '0',
            PIN_TYPE => "000001"
        )
    port map (
            PADOEN => \N__1129\,
            PADOUT => \N__1128\,
            PADIN => \N__1127\,
            CLOCKENABLE => 'H',
            DOUT1 => '0',
            OUTPUTENABLE => '0',
            DIN0 => i_resp_pl_byte_c_0,
            DOUT0 => '0',
            INPUTCLK => '0',
            LATCHINPUTVALUE => '0',
            DIN1 => OPEN,
            OUTPUTCLK => '0'
        );

    \i_send_pl_byte_ibuf_6_iopad\ : IO_PAD
    generic map (
            IO_STANDARD => "SB_LVCMOS",
            PULLUP => '0'
        )
    port map (
            OE => \N__1120\,
            DIN => \N__1119\,
            DOUT => \N__1118\,
            PACKAGEPIN => i_send_pl_byte_wire(6)
        );

    \i_send_pl_byte_ibuf_6_preio\ : PRE_IO
    generic map (
            NEG_TRIGGER => '0',
            PIN_TYPE => "000001"
        )
    port map (
            PADOEN => \N__1120\,
            PADOUT => \N__1119\,
            PADIN => \N__1118\,
            CLOCKENABLE => 'H',
            DOUT1 => '0',
            OUTPUTENABLE => '0',
            DIN0 => i_send_pl_byte_c_6,
            DOUT0 => '0',
            INPUTCLK => '0',
            LATCHINPUTVALUE => '0',
            DIN1 => OPEN,
            OUTPUTCLK => '0'
        );

    \o_pl_byte_obuf_7_iopad\ : IO_PAD
    generic map (
            IO_STANDARD => "SB_LVCMOS",
            PULLUP => '0'
        )
    port map (
            OE => \N__1111\,
            DIN => \N__1110\,
            DOUT => \N__1109\,
            PACKAGEPIN => o_pl_byte_wire(7)
        );

    \o_pl_byte_obuf_7_preio\ : PRE_IO
    generic map (
            NEG_TRIGGER => '0',
            PIN_TYPE => "011001"
        )
    port map (
            PADOEN => \N__1111\,
            PADOUT => \N__1110\,
            PADIN => \N__1109\,
            CLOCKENABLE => 'H',
            DOUT1 => '0',
            OUTPUTENABLE => '0',
            DIN0 => OPEN,
            DOUT0 => \N__654\,
            INPUTCLK => '0',
            LATCHINPUTVALUE => '0',
            DIN1 => OPEN,
            OUTPUTCLK => '0'
        );

    \i_resp_pl_byte_ibuf_1_iopad\ : IO_PAD
    generic map (
            IO_STANDARD => "SB_LVCMOS",
            PULLUP => '0'
        )
    port map (
            OE => \N__1102\,
            DIN => \N__1101\,
            DOUT => \N__1100\,
            PACKAGEPIN => i_resp_pl_byte_wire(1)
        );

    \i_resp_pl_byte_ibuf_1_preio\ : PRE_IO
    generic map (
            NEG_TRIGGER => '0',
            PIN_TYPE => "000001"
        )
    port map (
            PADOEN => \N__1102\,
            PADOUT => \N__1101\,
            PADIN => \N__1100\,
            CLOCKENABLE => 'H',
            DOUT1 => '0',
            OUTPUTENABLE => '0',
            DIN0 => i_resp_pl_byte_c_1,
            DOUT0 => '0',
            INPUTCLK => '0',
            LATCHINPUTVALUE => '0',
            DIN1 => OPEN,
            OUTPUTCLK => '0'
        );

    \i_send_pl_byte_ibuf_7_iopad\ : IO_PAD
    generic map (
            IO_STANDARD => "SB_LVCMOS",
            PULLUP => '0'
        )
    port map (
            OE => \N__1093\,
            DIN => \N__1092\,
            DOUT => \N__1091\,
            PACKAGEPIN => i_send_pl_byte_wire(7)
        );

    \i_send_pl_byte_ibuf_7_preio\ : PRE_IO
    generic map (
            NEG_TRIGGER => '0',
            PIN_TYPE => "000001"
        )
    port map (
            PADOEN => \N__1093\,
            PADOUT => \N__1092\,
            PADIN => \N__1091\,
            CLOCKENABLE => 'H',
            DOUT1 => '0',
            OUTPUTENABLE => '0',
            DIN0 => i_send_pl_byte_c_7,
            DOUT0 => '0',
            INPUTCLK => '0',
            LATCHINPUTVALUE => '0',
            DIN1 => OPEN,
            OUTPUTCLK => '0'
        );

    \o_pl_byte_obuf_6_iopad\ : IO_PAD
    generic map (
            IO_STANDARD => "SB_LVCMOS",
            PULLUP => '0'
        )
    port map (
            OE => \N__1084\,
            DIN => \N__1083\,
            DOUT => \N__1082\,
            PACKAGEPIN => o_pl_byte_wire(6)
        );

    \o_pl_byte_obuf_6_preio\ : PRE_IO
    generic map (
            NEG_TRIGGER => '0',
            PIN_TYPE => "011001"
        )
    port map (
            PADOEN => \N__1084\,
            PADOUT => \N__1083\,
            PADIN => \N__1082\,
            CLOCKENABLE => 'H',
            DOUT1 => '0',
            OUTPUTENABLE => '0',
            DIN0 => OPEN,
            DOUT0 => \N__684\,
            INPUTCLK => '0',
            LATCHINPUTVALUE => '0',
            DIN1 => OPEN,
            OUTPUTCLK => '0'
        );

    \i_resp_pl_byte_ibuf_2_iopad\ : IO_PAD
    generic map (
            IO_STANDARD => "SB_LVCMOS",
            PULLUP => '0'
        )
    port map (
            OE => \N__1075\,
            DIN => \N__1074\,
            DOUT => \N__1073\,
            PACKAGEPIN => i_resp_pl_byte_wire(2)
        );

    \i_resp_pl_byte_ibuf_2_preio\ : PRE_IO
    generic map (
            NEG_TRIGGER => '0',
            PIN_TYPE => "000001"
        )
    port map (
            PADOEN => \N__1075\,
            PADOUT => \N__1074\,
            PADIN => \N__1073\,
            CLOCKENABLE => 'H',
            DOUT1 => '0',
            OUTPUTENABLE => '0',
            DIN0 => i_resp_pl_byte_c_2,
            DOUT0 => '0',
            INPUTCLK => '0',
            LATCHINPUTVALUE => '0',
            DIN1 => OPEN,
            OUTPUTCLK => '0'
        );

    \i_send_pl_byte_ibuf_0_iopad\ : IO_PAD
    generic map (
            IO_STANDARD => "SB_LVCMOS",
            PULLUP => '0'
        )
    port map (
            OE => \N__1066\,
            DIN => \N__1065\,
            DOUT => \N__1064\,
            PACKAGEPIN => i_send_pl_byte_wire(0)
        );

    \i_send_pl_byte_ibuf_0_preio\ : PRE_IO
    generic map (
            NEG_TRIGGER => '0',
            PIN_TYPE => "000001"
        )
    port map (
            PADOEN => \N__1066\,
            PADOUT => \N__1065\,
            PADIN => \N__1064\,
            CLOCKENABLE => 'H',
            DOUT1 => '0',
            OUTPUTENABLE => '0',
            DIN0 => i_send_pl_byte_c_0,
            DOUT0 => '0',
            INPUTCLK => '0',
            LATCHINPUTVALUE => '0',
            DIN1 => OPEN,
            OUTPUTCLK => '0'
        );

    \o_pl_byte_obuf_5_iopad\ : IO_PAD
    generic map (
            IO_STANDARD => "SB_LVCMOS",
            PULLUP => '0'
        )
    port map (
            OE => \N__1057\,
            DIN => \N__1056\,
            DOUT => \N__1055\,
            PACKAGEPIN => o_pl_byte_wire(5)
        );

    \o_pl_byte_obuf_5_preio\ : PRE_IO
    generic map (
            NEG_TRIGGER => '0',
            PIN_TYPE => "011001"
        )
    port map (
            PADOEN => \N__1057\,
            PADOUT => \N__1056\,
            PADIN => \N__1055\,
            CLOCKENABLE => 'H',
            DOUT1 => '0',
            OUTPUTENABLE => '0',
            DIN0 => OPEN,
            DOUT0 => \N__552\,
            INPUTCLK => '0',
            LATCHINPUTVALUE => '0',
            DIN1 => OPEN,
            OUTPUTCLK => '0'
        );

    \o_pl_valid_obuf_iopad\ : IO_PAD
    generic map (
            IO_STANDARD => "SB_LVCMOS",
            PULLUP => '0'
        )
    port map (
            OE => \N__1048\,
            DIN => \N__1047\,
            DOUT => \N__1046\,
            PACKAGEPIN => o_pl_valid_wire
        );

    \o_pl_valid_obuf_preio\ : PRE_IO
    generic map (
            NEG_TRIGGER => '0',
            PIN_TYPE => "011001"
        )
    port map (
            PADOEN => \N__1048\,
            PADOUT => \N__1047\,
            PADIN => \N__1046\,
            CLOCKENABLE => 'H',
            DOUT1 => '0',
            OUTPUTENABLE => '0',
            DIN0 => OPEN,
            DOUT0 => \N__624\,
            INPUTCLK => '0',
            LATCHINPUTVALUE => '0',
            DIN1 => OPEN,
            OUTPUTCLK => '0'
        );

    \i_grant_sel_ibuf_iopad\ : IO_PAD
    generic map (
            IO_STANDARD => "SB_LVCMOS",
            PULLUP => '0'
        )
    port map (
            OE => \N__1039\,
            DIN => \N__1038\,
            DOUT => \N__1037\,
            PACKAGEPIN => i_grant_sel_wire
        );

    \i_grant_sel_ibuf_preio\ : PRE_IO
    generic map (
            NEG_TRIGGER => '0',
            PIN_TYPE => "000001"
        )
    port map (
            PADOEN => \N__1039\,
            PADOUT => \N__1038\,
            PADIN => \N__1037\,
            CLOCKENABLE => 'H',
            DOUT1 => '0',
            OUTPUTENABLE => '0',
            DIN0 => i_grant_sel_c,
            DOUT0 => '0',
            INPUTCLK => '0',
            LATCHINPUTVALUE => '0',
            DIN1 => OPEN,
            OUTPUTCLK => '0'
        );

    \i_resp_pl_byte_ibuf_3_iopad\ : IO_PAD
    generic map (
            IO_STANDARD => "SB_LVCMOS",
            PULLUP => '0'
        )
    port map (
            OE => \N__1030\,
            DIN => \N__1029\,
            DOUT => \N__1028\,
            PACKAGEPIN => i_resp_pl_byte_wire(3)
        );

    \i_resp_pl_byte_ibuf_3_preio\ : PRE_IO
    generic map (
            NEG_TRIGGER => '0',
            PIN_TYPE => "000001"
        )
    port map (
            PADOEN => \N__1030\,
            PADOUT => \N__1029\,
            PADIN => \N__1028\,
            CLOCKENABLE => 'H',
            DOUT1 => '0',
            OUTPUTENABLE => '0',
            DIN0 => i_resp_pl_byte_c_3,
            DOUT0 => '0',
            INPUTCLK => '0',
            LATCHINPUTVALUE => '0',
            DIN1 => OPEN,
            OUTPUTCLK => '0'
        );

    \i_resp_pl_valid_ibuf_iopad\ : IO_PAD
    generic map (
            IO_STANDARD => "SB_LVCMOS",
            PULLUP => '0'
        )
    port map (
            OE => \N__1021\,
            DIN => \N__1020\,
            DOUT => \N__1019\,
            PACKAGEPIN => i_resp_pl_valid_wire
        );

    \i_resp_pl_valid_ibuf_preio\ : PRE_IO
    generic map (
            NEG_TRIGGER => '0',
            PIN_TYPE => "000001"
        )
    port map (
            PADOEN => \N__1021\,
            PADOUT => \N__1020\,
            PADIN => \N__1019\,
            CLOCKENABLE => 'H',
            DOUT1 => '0',
            OUTPUTENABLE => '0',
            DIN0 => i_resp_pl_valid_c,
            DOUT0 => '0',
            INPUTCLK => '0',
            LATCHINPUTVALUE => '0',
            DIN1 => OPEN,
            OUTPUTCLK => '0'
        );

    \i_send_pl_byte_ibuf_1_iopad\ : IO_PAD
    generic map (
            IO_STANDARD => "SB_LVCMOS",
            PULLUP => '0'
        )
    port map (
            OE => \N__1012\,
            DIN => \N__1011\,
            DOUT => \N__1010\,
            PACKAGEPIN => i_send_pl_byte_wire(1)
        );

    \i_send_pl_byte_ibuf_1_preio\ : PRE_IO
    generic map (
            NEG_TRIGGER => '0',
            PIN_TYPE => "000001"
        )
    port map (
            PADOEN => \N__1012\,
            PADOUT => \N__1011\,
            PADIN => \N__1010\,
            CLOCKENABLE => 'H',
            DOUT1 => '0',
            OUTPUTENABLE => '0',
            DIN0 => i_send_pl_byte_c_1,
            DOUT0 => '0',
            INPUTCLK => '0',
            LATCHINPUTVALUE => '0',
            DIN1 => OPEN,
            OUTPUTCLK => '0'
        );

    \o_pl_byte_obuf_4_iopad\ : IO_PAD
    generic map (
            IO_STANDARD => "SB_LVCMOS",
            PULLUP => '0'
        )
    port map (
            OE => \N__1003\,
            DIN => \N__1002\,
            DOUT => \N__1001\,
            PACKAGEPIN => o_pl_byte_wire(4)
        );

    \o_pl_byte_obuf_4_preio\ : PRE_IO
    generic map (
            NEG_TRIGGER => '0',
            PIN_TYPE => "011001"
        )
    port map (
            PADOEN => \N__1003\,
            PADOUT => \N__1002\,
            PADIN => \N__1001\,
            CLOCKENABLE => 'H',
            DOUT1 => '0',
            OUTPUTENABLE => '0',
            DIN0 => OPEN,
            DOUT0 => \N__810\,
            INPUTCLK => '0',
            LATCHINPUTVALUE => '0',
            DIN1 => OPEN,
            OUTPUTCLK => '0'
        );

    \i_resp_pl_byte_ibuf_4_iopad\ : IO_PAD
    generic map (
            IO_STANDARD => "SB_LVCMOS",
            PULLUP => '0'
        )
    port map (
            OE => \N__994\,
            DIN => \N__993\,
            DOUT => \N__992\,
            PACKAGEPIN => i_resp_pl_byte_wire(4)
        );

    \i_resp_pl_byte_ibuf_4_preio\ : PRE_IO
    generic map (
            NEG_TRIGGER => '0',
            PIN_TYPE => "000001"
        )
    port map (
            PADOEN => \N__994\,
            PADOUT => \N__993\,
            PADIN => \N__992\,
            CLOCKENABLE => 'H',
            DOUT1 => '0',
            OUTPUTENABLE => '0',
            DIN0 => i_resp_pl_byte_c_4,
            DOUT0 => '0',
            INPUTCLK => '0',
            LATCHINPUTVALUE => '0',
            DIN1 => OPEN,
            OUTPUTCLK => '0'
        );

    \i_send_pl_byte_ibuf_2_iopad\ : IO_PAD
    generic map (
            IO_STANDARD => "SB_LVCMOS",
            PULLUP => '0'
        )
    port map (
            OE => \N__985\,
            DIN => \N__984\,
            DOUT => \N__983\,
            PACKAGEPIN => i_send_pl_byte_wire(2)
        );

    \i_send_pl_byte_ibuf_2_preio\ : PRE_IO
    generic map (
            NEG_TRIGGER => '0',
            PIN_TYPE => "000001"
        )
    port map (
            PADOEN => \N__985\,
            PADOUT => \N__984\,
            PADIN => \N__983\,
            CLOCKENABLE => 'H',
            DOUT1 => '0',
            OUTPUTENABLE => '0',
            DIN0 => i_send_pl_byte_c_2,
            DOUT0 => '0',
            INPUTCLK => '0',
            LATCHINPUTVALUE => '0',
            DIN1 => OPEN,
            OUTPUTCLK => '0'
        );

    \o_pl_byte_obuf_3_iopad\ : IO_PAD
    generic map (
            IO_STANDARD => "SB_LVCMOS",
            PULLUP => '0'
        )
    port map (
            OE => \N__976\,
            DIN => \N__975\,
            DOUT => \N__974\,
            PACKAGEPIN => o_pl_byte_wire(3)
        );

    \o_pl_byte_obuf_3_preio\ : PRE_IO
    generic map (
            NEG_TRIGGER => '0',
            PIN_TYPE => "011001"
        )
    port map (
            PADOEN => \N__976\,
            PADOUT => \N__975\,
            PADIN => \N__974\,
            CLOCKENABLE => 'H',
            DOUT1 => '0',
            OUTPUTENABLE => '0',
            DIN0 => OPEN,
            DOUT0 => \N__843\,
            INPUTCLK => '0',
            LATCHINPUTVALUE => '0',
            DIN1 => OPEN,
            OUTPUTCLK => '0'
        );

    \i_pl_ready_ibuf_iopad\ : IO_PAD
    generic map (
            IO_STANDARD => "SB_LVCMOS",
            PULLUP => '0'
        )
    port map (
            OE => \N__967\,
            DIN => \N__966\,
            DOUT => \N__965\,
            PACKAGEPIN => i_pl_ready_wire
        );

    \i_pl_ready_ibuf_preio\ : PRE_IO
    generic map (
            NEG_TRIGGER => '0',
            PIN_TYPE => "000001"
        )
    port map (
            PADOEN => \N__967\,
            PADOUT => \N__966\,
            PADIN => \N__965\,
            CLOCKENABLE => 'H',
            DOUT1 => '0',
            OUTPUTENABLE => '0',
            DIN0 => i_pl_ready_c,
            DOUT0 => '0',
            INPUTCLK => '0',
            LATCHINPUTVALUE => '0',
            DIN1 => OPEN,
            OUTPUTCLK => '0'
        );

    \i_send_pl_byte_ibuf_3_iopad\ : IO_PAD
    generic map (
            IO_STANDARD => "SB_LVCMOS",
            PULLUP => '0'
        )
    port map (
            OE => \N__958\,
            DIN => \N__957\,
            DOUT => \N__956\,
            PACKAGEPIN => i_send_pl_byte_wire(3)
        );

    \i_send_pl_byte_ibuf_3_preio\ : PRE_IO
    generic map (
            NEG_TRIGGER => '0',
            PIN_TYPE => "000001"
        )
    port map (
            PADOEN => \N__958\,
            PADOUT => \N__957\,
            PADIN => \N__956\,
            CLOCKENABLE => 'H',
            DOUT1 => '0',
            OUTPUTENABLE => '0',
            DIN0 => i_send_pl_byte_c_3,
            DOUT0 => '0',
            INPUTCLK => '0',
            LATCHINPUTVALUE => '0',
            DIN1 => OPEN,
            OUTPUTCLK => '0'
        );

    \o_pl_byte_obuf_2_iopad\ : IO_PAD
    generic map (
            IO_STANDARD => "SB_LVCMOS",
            PULLUP => '0'
        )
    port map (
            OE => \N__949\,
            DIN => \N__948\,
            DOUT => \N__947\,
            PACKAGEPIN => o_pl_byte_wire(2)
        );

    \o_pl_byte_obuf_2_preio\ : PRE_IO
    generic map (
            NEG_TRIGGER => '0',
            PIN_TYPE => "011001"
        )
    port map (
            PADOEN => \N__949\,
            PADOUT => \N__948\,
            PADIN => \N__947\,
            CLOCKENABLE => 'H',
            DOUT1 => '0',
            OUTPUTENABLE => '0',
            DIN0 => OPEN,
            DOUT0 => \N__879\,
            INPUTCLK => '0',
            LATCHINPUTVALUE => '0',
            DIN1 => OPEN,
            OUTPUTCLK => '0'
        );

    \i_resp_pl_byte_ibuf_6_iopad\ : IO_PAD
    generic map (
            IO_STANDARD => "SB_LVCMOS",
            PULLUP => '0'
        )
    port map (
            OE => \N__940\,
            DIN => \N__939\,
            DOUT => \N__938\,
            PACKAGEPIN => i_resp_pl_byte_wire(6)
        );

    \i_resp_pl_byte_ibuf_6_preio\ : PRE_IO
    generic map (
            NEG_TRIGGER => '0',
            PIN_TYPE => "000001"
        )
    port map (
            PADOEN => \N__940\,
            PADOUT => \N__939\,
            PADIN => \N__938\,
            CLOCKENABLE => 'H',
            DOUT1 => '0',
            OUTPUTENABLE => '0',
            DIN0 => i_resp_pl_byte_c_6,
            DOUT0 => '0',
            INPUTCLK => '0',
            LATCHINPUTVALUE => '0',
            DIN1 => OPEN,
            OUTPUTCLK => '0'
        );

    \i_send_pl_byte_ibuf_4_iopad\ : IO_PAD
    generic map (
            IO_STANDARD => "SB_LVCMOS",
            PULLUP => '0'
        )
    port map (
            OE => \N__931\,
            DIN => \N__930\,
            DOUT => \N__929\,
            PACKAGEPIN => i_send_pl_byte_wire(4)
        );

    \i_send_pl_byte_ibuf_4_preio\ : PRE_IO
    generic map (
            NEG_TRIGGER => '0',
            PIN_TYPE => "000001"
        )
    port map (
            PADOEN => \N__931\,
            PADOUT => \N__930\,
            PADIN => \N__929\,
            CLOCKENABLE => 'H',
            DOUT1 => '0',
            OUTPUTENABLE => '0',
            DIN0 => i_send_pl_byte_c_4,
            DOUT0 => '0',
            INPUTCLK => '0',
            LATCHINPUTVALUE => '0',
            DIN1 => OPEN,
            OUTPUTCLK => '0'
        );

    \o_pl_byte_obuf_0_iopad\ : IO_PAD
    generic map (
            IO_STANDARD => "SB_LVCMOS",
            PULLUP => '0'
        )
    port map (
            OE => \N__922\,
            DIN => \N__921\,
            DOUT => \N__920\,
            PACKAGEPIN => o_pl_byte_wire(0)
        );

    \o_pl_byte_obuf_0_preio\ : PRE_IO
    generic map (
            NEG_TRIGGER => '0',
            PIN_TYPE => "011001"
        )
    port map (
            PADOEN => \N__922\,
            PADOUT => \N__921\,
            PADIN => \N__920\,
            CLOCKENABLE => 'H',
            DOUT1 => '0',
            OUTPUTENABLE => '0',
            DIN0 => OPEN,
            DOUT0 => \N__588\,
            INPUTCLK => '0',
            LATCHINPUTVALUE => '0',
            DIN1 => OPEN,
            OUTPUTCLK => '0'
        );

    \I__179\ : InMux
    port map (
            O => \N__903\,
            I => \N__900\
        );

    \I__178\ : LocalMux
    port map (
            O => \N__900\,
            I => i_send_pl_byte_c_2
        );

    \I__177\ : InMux
    port map (
            O => \N__897\,
            I => \N__894\
        );

    \I__176\ : LocalMux
    port map (
            O => \N__894\,
            I => \N__891\
        );

    \I__175\ : Span4Mux_s2_v
    port map (
            O => \N__891\,
            I => \N__888\
        );

    \I__174\ : Sp12to4
    port map (
            O => \N__888\,
            I => \N__885\
        );

    \I__173\ : Span12Mux_h
    port map (
            O => \N__885\,
            I => \N__882\
        );

    \I__172\ : Odrv12
    port map (
            O => \N__882\,
            I => i_resp_pl_byte_c_2
        );

    \I__171\ : IoInMux
    port map (
            O => \N__879\,
            I => \N__876\
        );

    \I__170\ : LocalMux
    port map (
            O => \N__876\,
            I => \N__873\
        );

    \I__169\ : Span4Mux_s0_v
    port map (
            O => \N__873\,
            I => \N__870\
        );

    \I__168\ : Sp12to4
    port map (
            O => \N__870\,
            I => \N__867\
        );

    \I__167\ : Odrv12
    port map (
            O => \N__867\,
            I => o_pl_byte_c_2
        );

    \I__166\ : InMux
    port map (
            O => \N__864\,
            I => \N__861\
        );

    \I__165\ : LocalMux
    port map (
            O => \N__861\,
            I => i_send_pl_byte_c_3
        );

    \I__164\ : InMux
    port map (
            O => \N__858\,
            I => \N__855\
        );

    \I__163\ : LocalMux
    port map (
            O => \N__855\,
            I => \N__852\
        );

    \I__162\ : Span4Mux_h
    port map (
            O => \N__852\,
            I => \N__849\
        );

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
            in3 => \N__758\,
            lcout => o_send_pl_ready_c,
            ltout => OPEN,
            carryin => \_gnd_net_\,
            carryout => OPEN,
            clk => \_gnd_net_\,
            ce => 'H',
            sr => \_gnd_net_\
        );
end \INTERFACE\;
