hack-a-tack/FPGA_Logic_Analyzer/(commit log)

2026-03-06 First commit: v1 PCB design and production files, some FPGA modules
    [iCE40UP5K_logic_analyzer-B_Cu.gbl, iCE40UP5K_logic_analyzer-B_Mask.gbs, iCE40UP5K_logic_analyzer-B_Paste.gbp, iCE40UP5K_logic_analyzer-B_Silkscreen.gbo, iCE40UP5K_logic_analyzer-Edge_Cuts.gm1, iCE40UP5K_logic_analyzer-F_Cu.gtl, iCE40UP5K_logic_analyzer-F_Mask.gts, iCE40UP5K_logic_analyzer-F_Paste.gtp]
2026-03-06 Stop tracking current_vhdl_for_easy_review.txt
2026-03-08 Added tx_mux architecture
    [send_engine_sbt.sdf, send_engine_sbt_vital.sdf, tx_mux_pin_table.CSV, tx_mux_sbt.sdf, tx_mux_sbt_vital.sdf]
2026-03-08 i_tx_busy implemented for analyzer_fsm (current modules compliant)
2026-03-08 upgraded headers
    [analyzer_fsm_pin_table.CSV, analyzer_fsm_sbt.sdf, analyzer_fsm_sbt_vital.sdf, tx_mux_pin_table.CSV]
2026-03-08 Added uart_tx architecture
    [analyzer_fsm_pin_table.CSV, uart_tx_pin_table.CSV, uart_tx_sbt.sdf, uart_tx_sbt_vital.sdf]
2026-03-09 Added/finished (v1) uart_tx TB
2026-03-11 Finsihed uart_rx module
    [uart_rx_pin_table.CSV, uart_rx_sbt.sdf, uart_rx_sbt_vital.sdf, uart_tx_pin_table.CSV]
2026-03-12 Added uart_rx TB
2026-03-12 Added cmd_parser
    [uart_rx_pin_table.CSV]
2026-03-14 Added trace_buffer (RAM) module
2026-03-14 Added trace_buffer (RAM) TB
2026-03-15 All 9 sub- and top-level module synthesise together (without constraint files)
    [uart_tx_sbt.sdf, uart_tx_sbt_vital.sdf]
2026-03-22 uart_rx simulates with 0 errors
    [analyzer_fsm.vhd, clocking.vhd, clocking_tb.vhd, top.vhd, trace_buffer.vhd, uart_rx.vhd, uart_rx_tb.vhd]
2026-03-22 uart_rx simulates with 0 errors, 0 clock drift, delta cycles implemented
    [uart_rx_tb.vhd]
2026-03-22 uart_tx simulated
2026-03-22 uart_tx (more solid) simulation
2026-04-04 trace_buffer simulated
2026-04-13 added rev1 images of schematic, layout, 3d render
2026-04-13 added rev1 block diagram; updated rev1 3d render
    [iCE40UP5K_logic_analyzer.kicad_pcb]
2026-04-18 small update to uart_tx so all bit periods are 52 clocks
2026-04-19 uart_tx sorted, full project compiled, best Fmax and WNS as of late
2026-05-14 Added arduino file for programming flash (basic communication, sector clear, page program and read; full bitstream TBD)
2026-05-14 bitstream_upload.ino file cleaned for testing. flash_upload.py for sending commands to program flash via arduino. arduino not ready for full programming
2026-05-14 FPGA PCB fully programmed using sorted bitstream_upload.ino file. also, bitstream added to arduino_flash_programmer folder for easier use of python script
2026-05-14 changed all rtl and tb files. rst is active low, so all 0s and 1s for rst signals flipped
    [analyzer_fsm.vhd, capture_engine.vhd, cmd_parser.vhd, la_host.py, send_engine.vhd, top.vhd, trace_buffer.vhd, tx_mux.vhd]
2026-05-17 bitmap DEBUG2 file used to find measured sample rate. top.vhd changed to facilitate this measurement
2026-05-17 current uart_tx.vhd and top.vhd used for finding transfer time metric.
2026-05-22 REV 1 COMPLETE. stability metrics measured. LA running top_bitmap_normal1.bin
    [capture.csv]
2026-05-24 rev1 admin complete. folder structure updated and finalised. moving on to rev2 folder (to be created)
    [FPGA Logic Analyzer, rev1, BOM.csv, FPGA Logic Analyzer, rev1, BOM.xlsx, analyzer_fsm_sbt.sdf, analyzer_fsm_sbt_vital.sdf, capture.csv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]
2026-05-25 first rev2 commit. updated sampling connector and added series resistors, weak pulldowns and inverting Schmitt trigger buffers. VHDL of top.vhd updated accordingly
    [iCE40UP5K_logic_analyzer_rev2.kicad_pcb, iCE40UP5K_logic_analyzer_rev2.kicad_sch]
2026-05-27 USB-UART bridge IC implementation. added LC filter to VPHY and VPLL. added caps to remaining power pins.
    [iCE40UP5K_logic_analyzer_rev2.kicad_sch]
2026-06-01 bridge-IC finished in pcb schematic
    [iCE40UP5K_logic_analyzer_rev2.kicad_sch]
2026-06-06 Added FPGA DEBUG HEADER to schematic. top.vhd and pcf files also updated.
    [iCE40UP5K_logic_analyzer_rev2.kicad_sch]
2026-06-06 Added UART PROBE HEADER to schematic.
    [iCE40UP5K_logic_analyzer_rev2.kicad_sch]
2026-06-06 Added CONFIG PROBE HEADER to schematic.
    [iCE40UP5K_logic_analyzer_rev2.kicad_sch]
2026-06-06 Added POWER RAIL DEBUG HEADER and 0R links to LDO outputs in schematic.
    [iCE40UP5K_logic_analyzer_rev2.kicad_sch]
2026-06-10 reworked schematic test pads. Cleaned up multiple of the schematic blocks.
    [iCE40UP5K_logic_analyzer_rev2.kicad_sch]
2026-06-15 CRESET_B slide switch implemented in schematic.
    [iCE40UP5K_logic_analyzer_rev2.kicad_sch]
2026-06-19 rev2 schematic fully sorted with cleanup and different sections
    [iCE40UP5K_logic_analyzer_rev2.kicad_sch]
2026-06-22 SCHEMATIC passed design rule check (DRC).
    [iCE40UP5K_logic_analyzer_rev2.csv, iCE40UP5K_logic_analyzer_rev2.kicad_sch]
2026-06-23 LAYOUT all components placed relatively well. Time for wiring
    [iCE40UP5K_logic_analyzer_rev2.kicad_pcb, iCE40UP5K_logic_analyzer_rev2.kicad_sch]
2026-06-24 LAYOUT in the works. SPI lines connected last
    [iCE40UP5K_logic_analyzer_rev2.kicad_pcb]
2026-06-24 LAYOUT. update to SPI lines.
    [iCE40UP5K_logic_analyzer_rev2.kicad_pcb]
2026-06-25 LAYOUT. LA inputs sorted. Note that LA12-15 have new FPGA pins (updated in notes table and PCF).
    [iCE40UP5K_logic_analyzer_rev2.kicad_pcb, iCE40UP5K_logic_analyzer_rev2.kicad_sch]
2026-06-25 LAYOUT. UART/RTS/CTS lines sorted. LEDs/DEBUGs/testpads next.
2026-06-26 LAYOUT. LEDs/DEBUG/HEADERS/testpads sorted.
    [iCE40UP5K_logic_analyzer_rev2.kicad_pcb]
2026-07-10 layout sorted with power pours on L3 and silkscreen
    [iCE40UP5K_logic_analyzer_rev2.kicad_pcb, iCE40UP5K_logic_analyzer_rev2.kicad_sch]
2026-07-10 added remaining 3D models to PCB
    [iCE40UP5K_logic_analyzer_rev2.kicad_pcb]
2026-07-11 PCB completed final DRC. Rev2 production files generated. PCB and components ordered.
    [FPGA Logic Analyzer, rev2, BOM.csv, FPGA Logic Analyzer, rev2, BOM.xlsx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]
2026-07-11 added rev2 kicad schematic/layout/3d render images
2026-08-03 VHDL. capture_engine upgraded for current set of changes (trigger subsystem, FSM)
2026-08-04 VHDL. updated trace_buffer.vhd module (for trigger subsystem changes).
2026-08-06 VHDL. changed send_engine, tx_mux, uart_tx, analyzer_fsm. TX handshake implemented
2026-08-09 VHDL. clocking.vhd module sorted (variable sample rate)
2026-08-17 git add . git commit -m "VHDL. Timeout and error handling for config_regs. analyzer_fsm now blocks config writes during CAPTURE and SEND. cmd_parser now checks analyzer_fsm's write permission before 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
    [analyzer_fsm.vhd, cmd_parser.vhd, config_regs.vhd]
2026-08-17 VHDL. Variable UART baud rate (with safety features, e.g. revert timer and commit point)
    [config_regs.vhd, resp_gen.vhd, uart_rx.vhd, uart_tx.vhd]
2026-08-18 "VHDL and vscode/claude setup. la_pkg integration. GHDL for VHDL copmilation."
    [tx_mux_pin_table.CSV, tx_mux_sbt.sdf, tx_mux_sbt_vital.sdf]
2026-08-19 VHDL. Migrate to la_pkg from uart_pkg for all relevant modules.
2026-08-20 VHDL. LA inputs synchronised (2FF). Compilation error as r_banks are inferred as FFs, not EBRs.
    [capture_engine.vhd, top.vhd]
2026-08-23 VHDL. Optimising Fmax. Highest recorded 42.47MHz with current VHDL.
    [top_pin_table.CSV, top_sbt.sdf, top_sbt_vital.sdf, tx_mux_pin_table.CSV]
2026-09-04 TB. uart_rx ran successfully in ModelSim.
2026-09-11 TB. uart_tx ran successfully in ModelSim.
